wayoffthecoast/reference-PDB-files/Motherboard/PDFs/Motherboard-layout.pdf

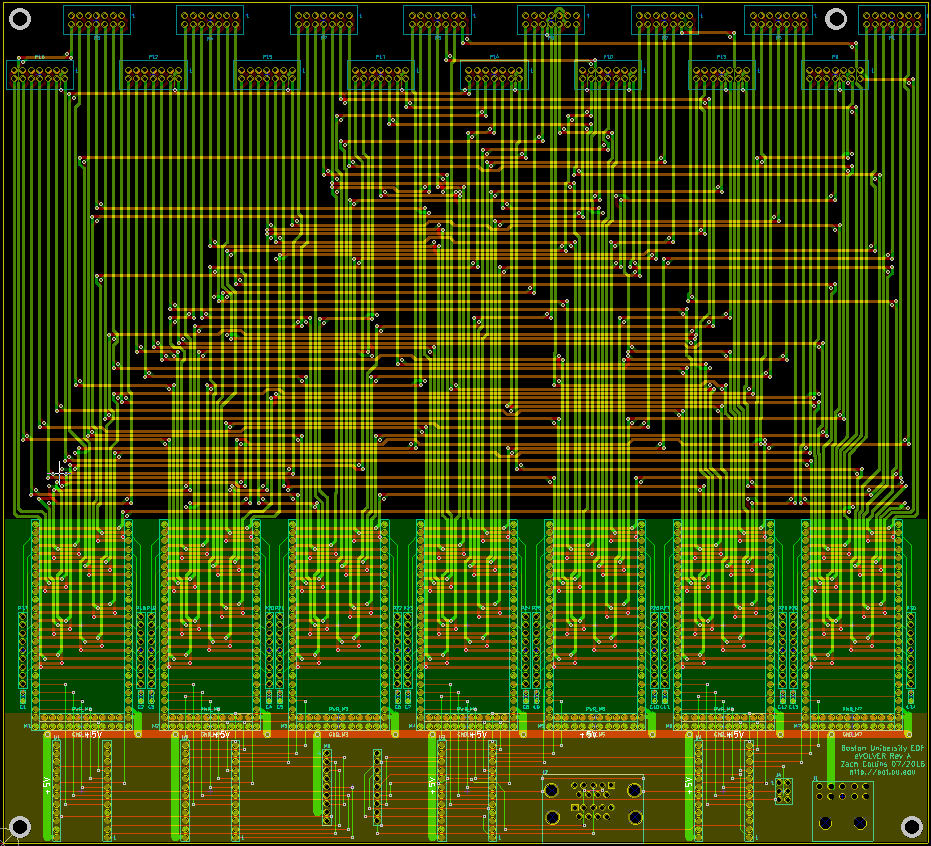
[picture p1: page 1]
