wayoffthecoast/reference-PDB-files/ADC/ADC_BOM_grouped_IC1_IS_WRONG?_.ods

 |  |  |  |  |  | Prototype Qty: | 5 |  |  |  | Production Qty: | 40 |  | Reeling Fee | $7.00
 |  |  |  |  |  | Prototype (Cut Tape) |  |  |  |  | Production (Digi-Reel)
Index | Reference | Quantity | Value | Footprint | Supplier Name | Qty Needed | Qty to Buy | Supplier Number | Comp Price | Comp Total | Qty Needed | Qty to Buy | Supplier Number | Comp Price | Reel Total
1 | C1 C10 C11 C12 C13 C14 C15 C16 C17 C18 C19 C2 C20 C21 C22 C23 C24 C3 C4 C5 C6 C7 C8 C9 | 24 | .1uF | Capacitors_SMD:C_0402 | Murata Electronics North America | 120 | 150 | 490-10777-1-ND | $0.01 | $0.83 | 960 | 1300 | 490-10777-6-ND | $0.00 | $10.90
2 | IC1 | 1 | 74HC4067 | ADC:74HC_HTC4067 | NXP Semiconductors | 5 | 8 | 568-12173-1-ND | $2.88 | $23.04 | 40 | 50 | 568-12173-6-ND | $2.59 | $136.35
3 | P1 P2 | 2 | CONNX25 | mods:25_pin_10in | Mill-Max Manufacturing Corp. | 10 | 12 | ED10025-ND | $3.66 | $43.87 | 80 | 85 | ED10025-ND | $4.52 | $384.20 | Not in Reel
4 | R1 R12 R13 R16 R17 R20 R21 R24 R25 R28 R29 R32 R33 R36 R37 R4 R40 R41 R44 R45 R48 R49 R5 R52 R53 R56 R57 R60 R61 R64 R65 R8 R9 | 33 | 10k | Resistors_SMD:R_0402 | Yageo | 165 | 200 | 311-10KJRCT-ND | $0.00 | $0.94 | 1320 | 1500 | 311-10KJRDKR-ND | $0.00 | $10.20
5 | R10 R14 R18 R2 R22 R26 R30 R34 R38 R42 R46 R50 R54 R58 R6 R62 | 16 | 1 M | Resistors_SMD:R_0402 | Yageo | 80 | 100 | 311-1.0MJRCT-ND | $0.00 | $0.47 | 640 | 800 | 311-1.0MJRDKR-ND | $0.00 | $9.32
6 | R11 R15 R19 R23 R27 R3 R31 R35 R39 R43 R47 R51 R55 R59 R63 R7 | 16 | OMIT | Resistors_SMD:R_0402 | Yageo | 80 | 0 | N/A | $0.00 | $0.00 | 640 | 0 | N/A | $0.00 | $0.00
7 | U1 | 1 | TLV1117LV33DCYR | ADC:TLV1117 | Texas Instruments | 5 | 8 | 296-28778-1-ND | $0.64 | $5.12 | 40 | 50 | 296-28778-6-ND | $0.56 | $35.20
8 | U2 | 1 | MCP6001 | ADC:MCP6001 | Microchip Technology | 5 | 8 | MCP6001T-I/OTCT-ND | $0.24 | $1.92 | 40 | 50 | MCP6001T-I/OTDKR-ND | $0.20 | $17.00
9 | U3 U4 U5 U6 | 4 | MCP6004 | ADC:MCP6004 | Microchip Technology | 20 | 25 | MCP6004T-I/STCT-ND | $0.36 | $9.00 | 160 | 200 | MCP6004T-I/STCT-ND | $0.33 | $73.00
 |  |  |  |  |  |  |  | Prototype Cost |  | $85.18 |  |  | Production Cost |  | $676.17
