wayoffthecoast/reference-PDB-files/Motherboard/Motherboard_BOM_grouped.ods

Prototype board quantity: | 2
Production board quantity: | 12 |  |  |  |  |  | Prototype |  |  |  |  | Production
Index | Reference | Quantity | Value | Footprint | Supplier Name | Notes | Catalog Number | quantity | order quantity | Price each | Price total | Catalog Number | quantity | order quantity | Price each | Price Total | Notes
1 | C1 C10 C11 C12 C13 C14 C2 C3 C4 C5 C6 C7 C8 C9 | 14 | 1uF | mods:FK18X5R0J105K | Digi-Key |  | 445-8395-ND | 28 | 30 | $0.20 | $6.00 | 445-8395-ND | 168 | 200 | $0.11 | $22.72
2 | P31 | 1 | CONN_01X10 | Mods:1723162216 | Digi-Key |  | WM11879-ND | 2 | 3 | $7.38 | $22.14 | WM11879-ND | 12 | 15 | $7.08 | $106.20
3 | J2 | 1 | DB9-M | mods:DB9FC | Digi-Key |  | 1109FME-ND | 2 | 3 | $6.96 | $20.88 | 1109FME-ND | 12 | 15 | $6.67 | $100.05
4 | J4 | 1 | CONN_02X03 | mods:2x3_pin_10in | Digi-Key |  | 609-3218-ND | 2 | 3 | $0.27 | $0.81 | 609-3218-ND | 12 | 15 | $0.26 | $3.87
5 | M1 M2 M3 M4 M5 M6 M7 | 7 | CONN_02X25 | mods:50_pin_10in | Digi-Key | Quantity 2x | 25-0513-10T | 28 | 30 | $2.90 | $87.00 | 25-0513-10T | 168 | 168 | $2.32 | $389.76
6 | M8 | 1 | CONN_02X09 | mods:2x_9_pin_10in | Digi-Key | Quantity 2x | 09-0513-10T | 4 | 5 | $1.87 | $9.35 | 09-0513-10 | 24 | 24 | $1.35 | $32.40 | IC socket?
7 | P1 P10 P11 P12 P13 P14 P15 P16 P2 P3 P4 P5 P6 P7 P8 P9 | 16 | CONN_02X07 | mods:2x7_pin_10in | Digi-Key |  | S9170-ND | 32 | 40 | $0.39 | $15.41 | S9170-ND | 192 | 200 | 0.315 | $63.00
8 | P17 P18 P19 P20 P21 P22 P23 P24 P25 P26 P27 P28 P29 P30 | 14 | 8_R_01X09 | mods:9_pin_10in | Digi-Key |  | 09-0513-10T | 28 | 30 | $2.69 | $80.61 | 09-0513-10 | 168 | 200 | $2.21 | $442.64
9 | GND_M1 GND_M2 GND_M3 GND_M4 GND_M5 GND_M6 GND_M7 PWR_M1 PWR_M2 PWR_M3 PWR_M4 PWR_M5 PWR_M6 PWR_M7 | 14 | CONN_01X10 | mods:10_pin_10in | Digi-Key |  | 10-0513-10 | 28 | 30 | $1.57 | $47.10 | 10-0513-10 | 168 | 200 | $1.26 | $252.00
10 | U1 U2 U3 U4 | 4 | CONN_02X12 | mods:24_pin_10in | Digi-Key |  | 214-44-624-01-670800 | 8 | 10 | $1.98 | $19.80 | 214-44-624-01-670800 | 48 | 50 | $1.98 | $99.00
 |  |  |  |  |  |  |  |  |  | Total cost: | $309.10 |  |  |  | Total cost | $1,511.64
 |  |  |  |  |  |  |  |  |  | Per board: | $154.55 |  |  |  | Per board: | $125.97
