wayoffthecoast/reference-PDB-files/Pi-Hat/EV-PiHat-asmBOM-RevA.ods

Reference | Value | Footprint | Datasheet | Supplier | Supplier PN
Q3 | 2N7002 | project_footprints:2N7002 |  | Digi-key | 2N7002NCT-ND
R1 | 510 | project_footprints:R_805_HS |  | Digi-key | RMCF0805JG510R-ND
D1 | LED | project_footprints:LED_0603 |  | Digi-key | 846-1178-2-ND
Q4 | 2N7002 | project_footprints:2N7002 |  | Digi-key | 2N7002NCT-ND
R2 | 510 | project_footprints:R_805_HS |  | Digi-key | RMCF0805JG510R-ND
D2 | LED | project_footprints:LED_0603 |  | Digi-key | 846-1178-2-ND
C2 | 1uF | project_footprints:C_0805_HS |  | Digi-key | CL21B105KOFNNNF-ND
C3 | 1uF | project_footprints:C_0805_HS |  | Digi-key | CL21B105KOFNNNF-ND
C1 | 1uF | project_footprints:C_0805_HS |  | Digi-key | CL21B105KOFNNNF-ND
R3 | DNP | project_footprints:R_805_HS
R5 | 10k | project_footprints:R_805_HS |  | Digi-key | RMCF0805JG10K0TR-ND
R10 | 10k | project_footprints:R_805_HS
J2 | Header_10Pin | project_footprints:10Pin_Header
J3 | Header_8Pin | project_footprints:8Pin_Header |  | Digi-key | 609-3273-ND
J4 | Header_8Pin | project_footprints:8Pin_Header |  | Digi-key | 609-3273-ND
J5 | Header_8Pin | project_footprints:8Pin_Header |  | Digi-key | 609-3273-ND
U1 | MAX481 | project_footprints:SO-8 |  | Digi-key | MAX481CSA+TR-ND
J6 | RJ14 | project_footprints:609-5080-ND |  | Digi-key | 609-5080-ND
Q5 | BSS123 | project_footprints:2N7002 |  | Digi-key | BSS123NTR-ND
R12 | 10k | project_footprints:R_805_HS |  | Digi-key | RMCF0805JG10K0TR-ND
R4 | 10k | project_footprints:R_805_HS |  | Digi-key | RMCF0805JG10K0TR-ND
J7 | 2Screw_Term | project_footprints:277-1667-ND |  | Digi-key | 277-1667-ND
R6 | DNP | project_footprints:R_805_HS |  | x | x
J1 | raspberrypi_hat:OX40HAT | project_footprints:Connector_PinSocket_2.54mm |  | Digi-key | S9200-ND
