wayoffthecoast/reference-PDB-files/PWM/pwm_BOM_grouped.ods

Prototype board quantity: | 6
Production board quantity: | 60 |  |  |  |  | Prototype |  |  |  |  | Production
Index | Reference | Qty | Value | Footprint | Supplier Name | Catalog Number | quantity | order quantity | Price each | Price total | Catalog Number | quantity | order quantity | Price each | Price Total | Reel charge | Total | Notes
1 | C1 C10 C2 C5 C6 C7 C8 C9 | 8 | 0.1uF | mods:C_0402 | Digi-Key | 490-6328-1-ND | 48 | 50 | $0.01 | $0.33 | 490-6328-6-ND | 480 | 500 | $0.00386 | $1.93 | $7.00 | $8.93
2 | C3 C4 | 2 | 1uF | mods:C_0402 | Digi-Key | 490-1320-1-ND | 12 | 20 | $0.02 | $0.42 | 490-1320-6-ND | 120 | 250 | 0.0096 | $2.40 | $7.00 | $9.40
3 | D1 D10 D11 D12 D13 D14 D15 D16 D2 D3 D4 D5 D6 D7 D8 D9 | 16 | ZHCS506TA | mods:ZHCS506TA | Digi-Key | ZHCS506CT-ND | 96 | 100 | $0.33 | $33.24 | ZHCS506DKR-ND | 960 | 1000 | $0.20 | $201.25 | $7.00 | $208.25
4 | P1 P2 | 2 | CONN_01X25_1 | mods:25_pin_10in | Digi-Key | 25-0600-20 | 12 | 20 | $3.19 | $63.80 | 25-0600-20 | 120 | 150 | $2.55 | $382.50 |  | $382.50 | ED10025-ND alternate ($$$)
5 | P3 P4 | 2 | CONN_01X10 | mods:10pin_tenth_in | Digi-Key | 10-0600-20 | 12 | 20 | $1.56 | $31.20 | 10-0600-20 | 120 | 150 | $1.26 | $189.00 |  | $189.00 | ED10010-ND alternate ($$$)
6 | Q1 Q10 Q11 Q12 Q13 Q14 Q15 Q16 Q2 Q3 Q4 Q5 Q6 Q7 Q8 Q9 | 16 | AO3422 | mods:AO3422 | Digi-Key | 785-1015-1-ND | 96 | 100 | $0.2538 | $25.38 | 785-1015-6-ND | 960 | 1000 | $0.11536 | $115.36 | $7.00 | $122.36
7 | R1 R10 R11 R12 R13 R14 R15 R16 R2 R3 R4 R5 R6 R7 R8 R9 R18 | 17 | 10K | mods:R_0402 | Digi-Key | 311-10KJRCT-ND | 102 | 120 | $0.00470 | $0.56 | 311-10KJRDKR-ND | 1020 | 1100 | $0.00213 | $2.34 | $7.00 | $9.34
8 | R17 | 1 | 2.2k | mods:R_0402 | Digi-Key | 311-2.20KLRCT-ND | 6 | 10 | $0.013 | $0.13 | 311-2.20KLRDKR-ND | 60 | 100 | $0.01 | $0.54 | $7.00 | $7.54
9 | U1 | 1 | TLV1117LV33DCYR | mods:TLV1117LV33DCYR | Digi-Key | 296-28778-1-ND | 6 | 10 | $0.649 | $6.49 | 296-28778-6-ND | 60 | 100 | $0.4966 | $49.66 | $7.00 | $56.66
10 | U2 | 1 | TLC5940PWP | mods:TLC5940PWP | Digi-Key | 296-35975-1-ND | 6 | 10 | $2.778 | $27.78 | 296-35975-6-ND | 60 | 100 | $2.2793 | $227.93 | $7.00 | $234.93
 |  |  |  |  |  |  |  |  | Total cost: | $189.33 |  |  |  | Total cost | $1,172.91 | $56.00 | $1,228.91
 |  |  |  |  |  |  |  |  | Per board: | $31.56 |  |  |  |  |  | Per board: | $20.48
