wayoffthecoast/reference-PDB-files/RS485/RS485_BOM_grouped.ods

 |  |  |  |  |  | Prototype Qty: | 2 |  |  |  | Production Qty: | 10 |  | Reeling Fee | $7.00
 |  |  |  |  |  | Prototype (Cut Tape) |  |  |  |  | Production (Digi-Reel)
Index | Reference | Quantity | Value | Footprint | Supplier Name | Qty Needed | Qty to Buy | Supplier Number | Comp Price | Comp Total | Qty Needed | Qty to Buy | Supplier Number | Comp Price | Reel Total
1 | C1 C2 C3 | 3 | .1uF | mods:C_0402 | Murata Electronics North America | 6 | 10 | 490-10777-1-ND | 0.012 | $0.12 | 30 | 40 | 490-10777-6-ND | 0.012 | $7.48
2 | C4 | 1 | 10nF | mods:C_0402 | Murata Electronics North America | 2 | 10 | 490-6340-1-ND | 0.012 | $0.12 | 10 | 20 | 490-6340-6-ND | 0.012 | $7.24
3 | C5 | 1 | 1nF | mods:C_0402 | Murata Electronics North America | 2 | 10 | 490-6169-1-ND | 0.029 | $0.29 | 10 | 20 | 490-6169-6-ND | 0.029 | $7.58
4 | C6 | 1 | 100pF | mods:C_0402 | Murata Electronics North America | 2 | 10 | 490-5922-1-ND | 0.012 | $0.12 | 10 | 20 | 490-5922-6-ND | 0.012 | $7.24
5 | C7 | 1 | 10pF | mods:C_0402 | Murata Electronics North America | 2 | 10 | 490-6168-1-ND | 0.012 | $0.12 | 10 | 20 | 490-6168-6-ND | 0.012 | $7.24
6 | P1 P2 | 2 | CONN_01X09 | mods:9_pin_10in | Mill-Max Manufacturing Corp. | 4 | 6 | ED10009-ND | 2.85 | $17.10 | 20 | 30 | ED10009-ND | 2.85 | $85.50
7 | R1 R2 R3 R4 | 4 | 10k | mods:R_0402 | Yageo | 8 | 10 | 311-10KJRCT-ND | 0.012 | $0.12 | 40 | 50 | 311-10KJRDKR-ND | 0.012 | $7.60 | Not in Reel
8 | U1 U2 U4 U5 | 4 | SP3485CN | mods:SO-8 | Exar Corporation | 8 | 10 | 1016-1144-5-ND | 2.027 | $20.27 | 40 | 50 | 1016-1144-5-ND | 2.027 | $101.35 | Not in Reel (Tube)
9 | U3 | 1 | TLV1117LV33DCYR | mods:TLV1117LV33DCYR | Texas Instruments | 2 | 5 | 296-28778-1-ND | 0.64 | $3.20 | 10 | 20 | 296-28778-6-ND | 0.64 | $19.80
 |  |  |  |  |  |  |  | Prototype Cost |  | $41.46 |  |  | Production Cost |  | $251.03
 |  |  |  |  |  |  |  |  | Per board: | $20.73 |  |  |  | Per board: | $25.10
