wayoffthecoast/reference-PDB-files/ADC/JLCPCB/ADC_BOM_single_SUBMITTED.xls

Comment | Designator | Footprint | LCSC Part Number | Datasheet | Supplier Num | Supplier Name | PREVIOUSLY USED WRONG PART
TLV1117LV33DCYR | U1 | ADC:TLV1117 | C15578 |  | 296-28778-1-ND | Texas Instruments
.1uF | C4 | Capacitors_SMD:C_0402 | C159815
.1uF | C2 | Capacitors_SMD:C_0402 | C159815
CONNX25 | P1 | mods:25_pin_10in |  |  | ED10025-ND | Mill-Max Manufacturing Corp.
CONNX25 | P2 | mods:25_pin_10in |  |  | ED10025-ND | Mill-Max Manufacturing Corp.
74HC4067DB,118 | IC1 | ADC:74HC_HTC4067 | C124924 |  | 568-7641-1-ND | NXP Semiconductors | 74HC4067PW,118 = 568-12173-2-ND
.1uF | C1 | Capacitors_SMD:C_0402 | C159815
.1uF | C3 | Capacitors_SMD:C_0402 | C159815
MCP6001 | U2 | ADC:MCP6001 | C116490 |  | MCP6001T-I/OTCT-ND | Microchip Technology
10k | R1 | Resistors_SMD:R_0402 | C140214
MCP6004 | U3 | ADC:MCP6004 | C50282 |  | MCP6004T-I/STCT-ND | Microchip Technology
1M = 1 MegaOhm | R2 | Resistors_SMD:R_0402 | C26087
10k | R4 | Resistors_SMD:R_0402 | C140214
DO NOT PLACE = OMIT | R3 | Resistors_SMD:R_0402
10k | R5 | Resistors_SMD:R_0402 | C140214
.1uF | C5 | Capacitors_SMD:C_0402 | C159815
1M = 1 MegaOhm | R10 | Resistors_SMD:R_0402 | C26087
DO NOT PLACE = OMIT | R11 | Resistors_SMD:R_0402
10k | R12 | Resistors_SMD:R_0402 | C140214
10k | R13 | Resistors_SMD:R_0402 | C140214
1M = 1 MegaOhm | R14 | Resistors_SMD:R_0402 | C26087
DO NOT PLACE = OMIT | R15 | Resistors_SMD:R_0402
10k | R16 | Resistors_SMD:R_0402 | C140214
10k | R17 | Resistors_SMD:R_0402 | C140214
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
10k | R56 | Resistors_SMD:R_0402 | C140214
10k | R57 | Resistors_SMD:R_0402 | C140214
.1uF | C21 | Capacitors_SMD:C_0402 | C159815
.1uF | C23 | Capacitors_SMD:C_0402 | C159815
.1uF | C22 | Capacitors_SMD:C_0402 | C159815
.1uF | C24 | Capacitors_SMD:C_0402 | C159815
