wayoffthecoast/reference-PDB-files/RS485/JLCPCB/RS485_BOM_grouped_Submitted.xls

Comment | Designator | Footprint | LCSC Part Number | Supplier Name | Qty Needed | Qty to Buy | Supplier Number | Comp Price | Comp Total | Qty Needed | Qty to Buy | Supplier Number | Comp Price | Reel Total
.1uF = 100 nF | C1 C2 C3 | mods:C_0402 | C309458 | Murata Electronics North America | #REF! | 10 | 490-10777-1-ND | 0.012 | $0.12 | #REF! | 40 | 490-10777-6-ND | 0.012 | #REF!
10nF | C4 | mods:C_0402 | C541443 | Murata Electronics North America | #REF! | 10 | 490-6340-1-ND | 0.012 | $0.12 | #REF! | 20 | 490-6340-6-ND | 0.012 | #REF!
1nF | C5 | mods:C_0402 | C77018 | Murata Electronics North America | #REF! | 10 | 490-6169-1-ND | 0.029 | $0.29 | #REF! | 20 | 490-6169-6-ND | 0.029 | #REF!
100pF | C6 | mods:C_0402 | C1546 | Murata Electronics North America | #REF! | 10 | 490-5922-1-ND | 0.012 | $0.12 | #REF! | 20 | 490-5922-6-ND | 0.012 | #REF!
10pF | C7 | mods:C_0402 | C32949 | Murata Electronics North America | #REF! | 10 | 490-6168-1-ND | 0.012 | $0.12 | #REF! | 20 | 490-6168-6-ND | 0.012 | #REF!
CONN_01X09 | P1 P2 | mods:9_pin_10in |  | Mill-Max Manufacturing Corp. | #REF! | 6 | ED10009-ND | 2.85 | $17.10 | #REF! | 30 | ED10009-ND | 2.85 | $85.50
10k | R1 R2 R3 R4 | mods:R_0402 | C269674 | Yageo | #REF! | 10 | 311-10KJRCT-ND | 0.012 | $0.12 | #REF! | 50 | 311-10KJRDKR-ND | 0.012 | #REF! | Not in Reel
SP3485CN | U1 U2 U4 U5 | mods:SO-8 | C916153 | Exar Corporation | #REF! | 10 | 1016-1144-5-ND | 2.027 | $20.27 | #REF! | 50 | 1016-1144-5-ND | 2.027 | $101.35 | Not in Reel (Tube)
TLV1117LV33DCYR | U3 | mods:TLV1117LV33DCYR | C15578 | Texas Instruments | #REF! | 5 | 296-28778-1-ND | 0.64 | $3.20 | #REF! | 20 | 296-28778-6-ND | 0.64 | #REF!
 |  |  |  |  |  |  | Prototype Cost |  | $41.46 |  |  | Production Cost |  | #REF!
 |  |  |  |  |  |  |  | Per board: | #REF! |  |  |  | Per board: | #REF!
