wayoffthecoast/reference-PDB-files/hardware-master/Smart Sleeve/vial_board/Rev D/Vial_Board_grp.ods

Reference | Quantity | Value | Footprint | Datasheet | Catalog Number | Supplier Name
P1 | 1 | CONN_02X08 | mods:2x8_pin_10in |  | S9171-ND | Digi-key
P2 | 1 | CONN_01X04 | mods:4_ScrewTerm |  | ED10563-ND | Digi-Key
P5 | 1 | DNP (Thermistor) | mods:Thermistor |  | x | x
P6 | 1 | IR LED | mods:screw_terminal |  | ED10561-ND | Digi-Key
P7 | 1 | IR Detector | mods:screw_terminal |  | ED10561-ND | Digi-Key
P8 | 1 | Spare B | mods:screw_terminal |  | ED10561-ND | Digi-key
P9 | 1 | Spare A | mods:screw_terminal |  | ED10561-ND | Digi-key
R1 R3 R4 R7 | 4 | 82 | mods:Through_hole_R |  | 82ZCT-ND | Digi-Key
R5 | 1 | Heater 1 | mods:Heater |  | 684-MP915-20 | Mouser Electronics
R6 | 1 | Heater 2 | mods:Heater |  | 684-MP915-20 | Mouser Electronics
