wayoffthecoast/reference-PDB-files/hardware-master/pump_board/Rev C/Mounts/3D printed/Solidworks/pumpmount_frontLeft_RevC.SLDPRT

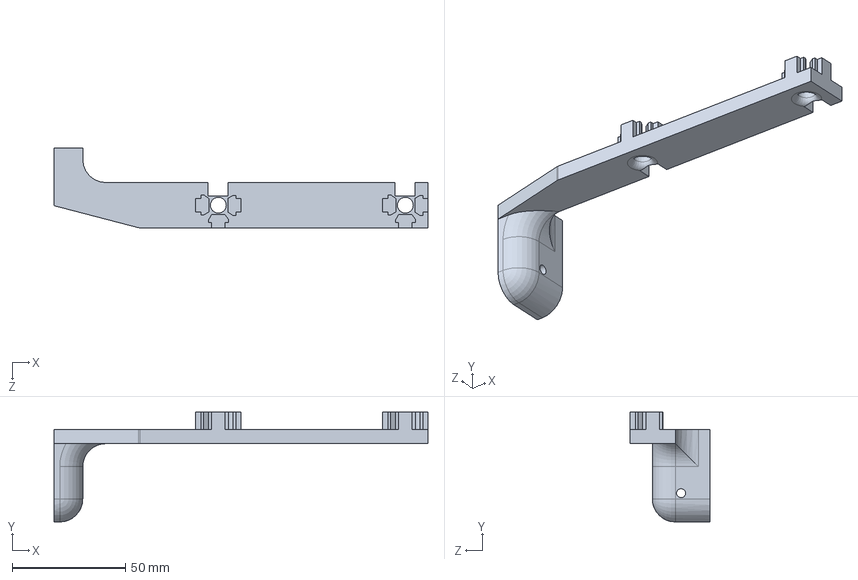
[picture p3: CAD file, 2021-12-21]
hardware-master/pump_board/Rev C/Mounts/3D printed/Solidworks/pumpmount_frontLeft_RevC.SLDPRT
165.1 x 48.5 x 35.2 mm
