wayoffthecoast/reference-PDB-files/hardware-master/Smart Sleeve/aluminum_tube/KL_aluminum_sleeve_V2.STEP

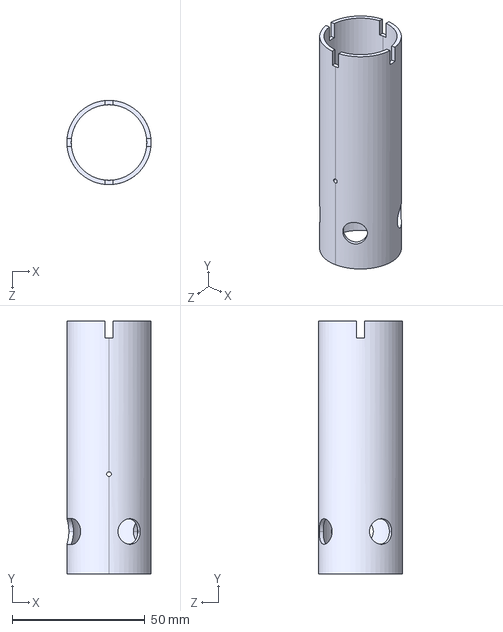
[picture p4: CAD file, 2021-12-21]
hardware-master/Smart Sleeve/aluminum_tube/KL_aluminum_sleeve_V2.STEP
31.8 x 95.3 x 31.8 mm
