wayoffthecoast/reference-PDB-files/hardware-master/Smart Sleeve/tube-holder/Tube Holder_V4.SLDPRT

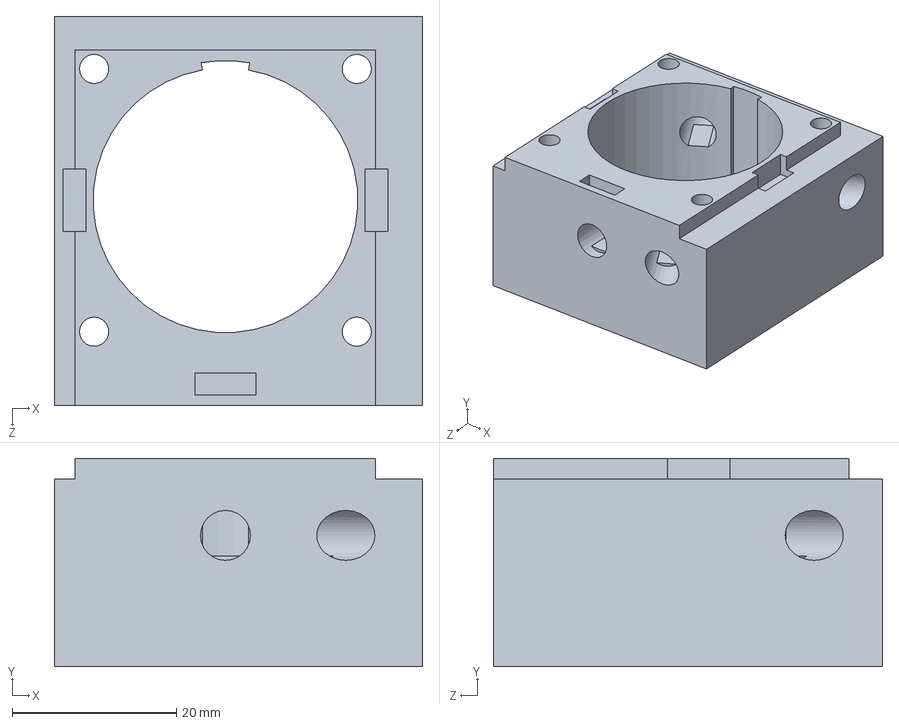
[picture p5: CAD file, 2021-12-21]
hardware-master/Smart Sleeve/tube-holder/Tube Holder_V4.SLDPRT
44.8 x 25.4 x 47.4 mm
