wayoffthecoast/reference-PDB-files/hardware-master/Smart Sleeve/vial-aligner/vial_aligner.SLDPRT

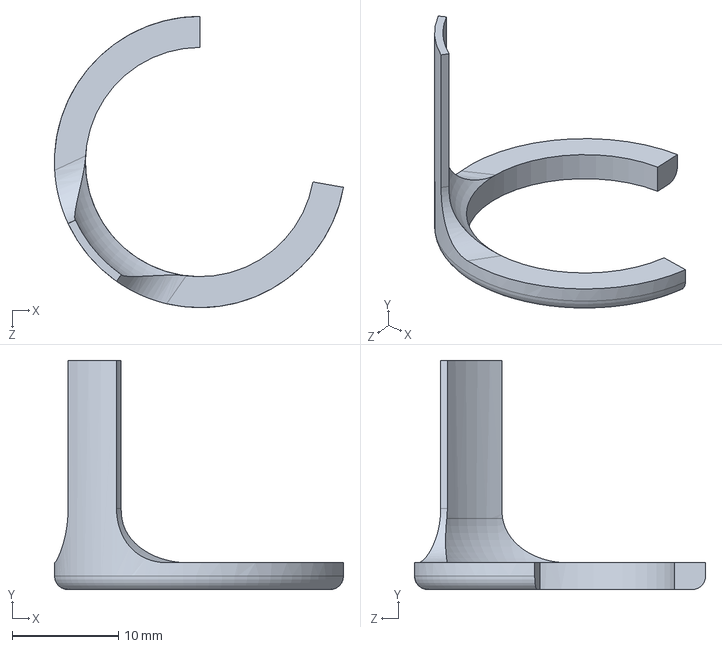
[picture p6: CAD file, 2021-12-21]
hardware-master/Smart Sleeve/vial-aligner/vial_aligner.SLDPRT
27.2 x 21.6 x 27.4 mm
