wayoffthecoast/reference-PDB-files/hardware-master/Smart Sleeve/vial_cap/vial_cap_v5.SLDPRT

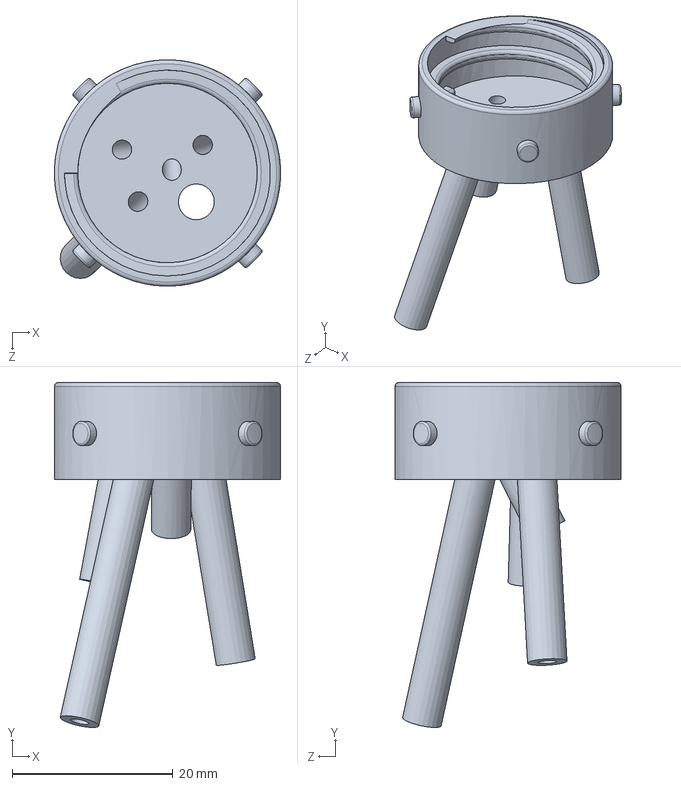
[picture p7: CAD file, 2021-12-21]
hardware-master/Smart Sleeve/vial_cap/vial_cap_v5.SLDPRT
28.2 x 43.0 x 28.2 mm
