wayoffthecoast/reference-PDB-files/pump_board/Rev C/Mounts/3D printed/Solidworks/pumpmount_backLeft_RevC.SLDPRT

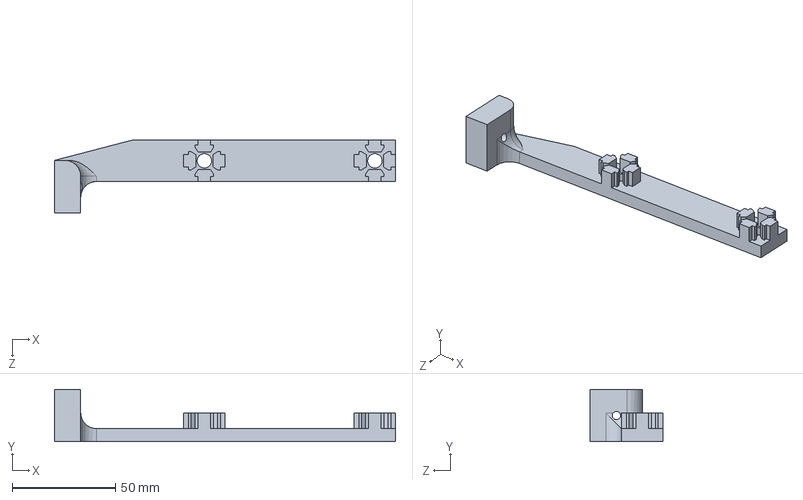
[picture p8: CAD file, 2021-12-21]
pump_board/Rev C/Mounts/3D printed/Solidworks/pumpmount_backLeft_RevC.SLDPRT
165.1 x 25.4 x 35.2 mm
