wayoffthecoast/reference-PDB-files/(list of files, cad)

Other CAD files:
hardware-master/pump_board/Rev C/Mounts/3D printed/STL/pumpmount_frontRight_RevC.STL
pump_board/Rev C/Mounts/3D printed/Solidworks/pumpmount_frontRigh_RevC.SLDPRT
pump_board/Rev C/Mounts/3D printed/STL/pumpmount_frontRight_RevC.STL
hardware-master/pump_board/Rev C/Mounts/3D printed/Solidworks/pumpmount_frontRigh_RevC.SLDPRT
hardware-master/pump_board/Rev C/Mounts/3D printed/Solidworks/pumpmount_backRight_RevC.SLDPRT
pump_board/Rev C/Mounts/3D printed/Solidworks/pumpmount_backRight_RevC.SLDPRT
hardware-master/Smart Sleeve/tube-holder/Tube Holder_V4.STL
hardware-master/Smart Sleeve/vial-aligner/vial_aligner.STL
hardware-master/Smart Sleeve/vial_cap/vial_cap_v5.STL
hardware-master/pump_board/Rev C/Mounts/3D printed/STL/pumpmount_backLeft_RevC.STL
hardware-master/pump_board/Rev C/Mounts/3D printed/STL/pumpmount_backRight_RevC.STL
hardware-master/pump_board/Rev C/Mounts/3D printed/STL/pumpmount_frontLeft_RevC.STL
pump_board/Rev C/Mounts/3D printed/STL/pumpmount_backLeft_RevC.STL
pump_board/Rev C/Mounts/3D printed/STL/pumpmount_backRight_RevC.STL
pump_board/Rev C/Mounts/3D printed/STL/pumpmount_frontLeft_RevC.STL
