wayoffthecoast/reference-PDB-files/Motherboard/PDFs/Motherboard-gerber.pdf

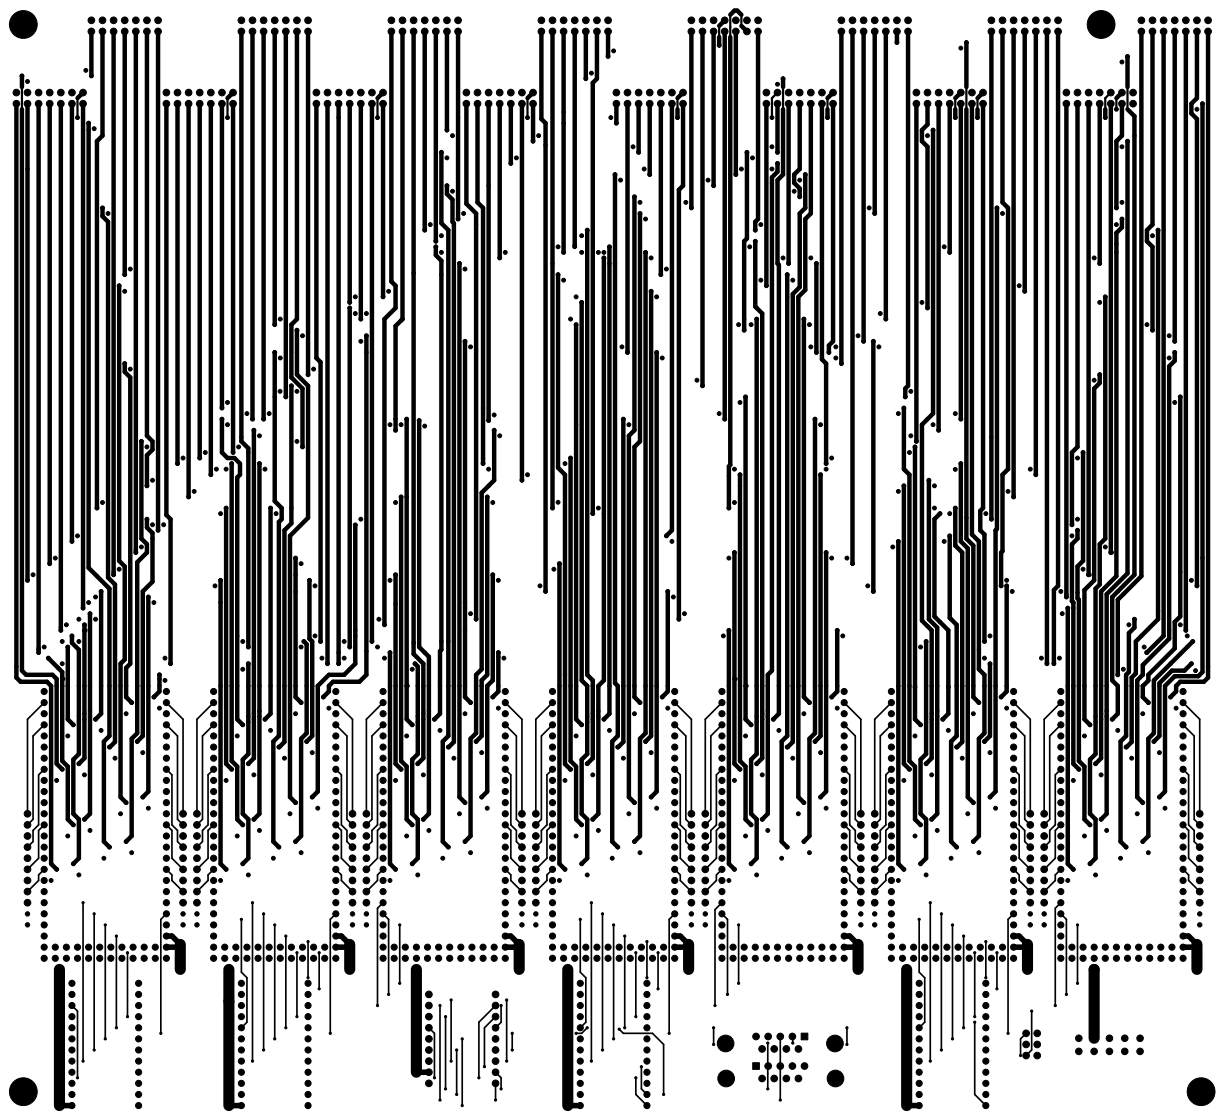
[picture p10: page 1]

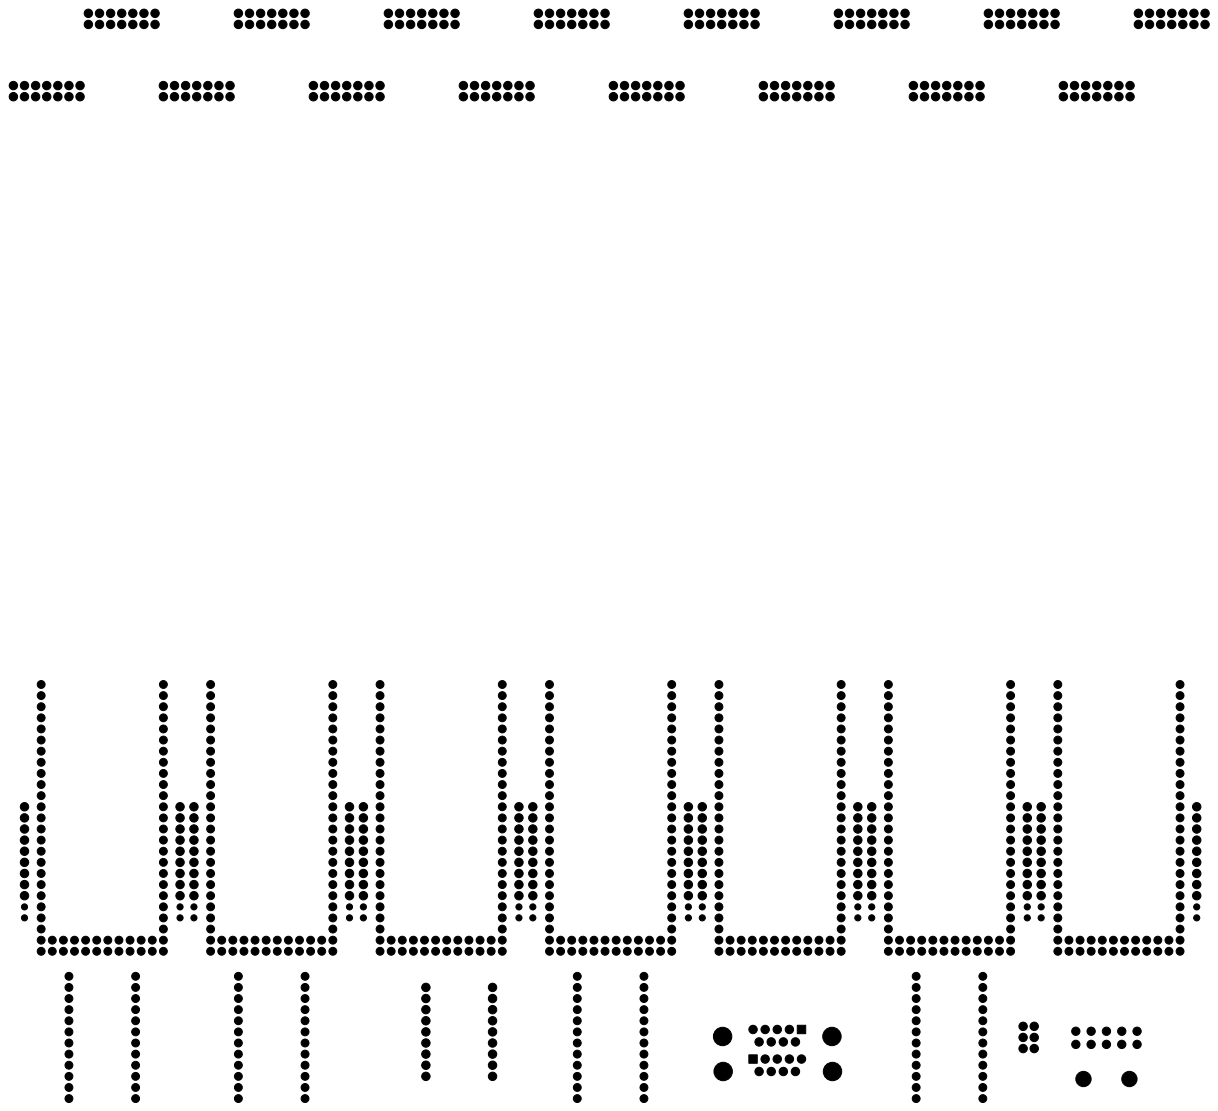
[picture p11: page 2]

# BOSTON UNIVERSITY EDF

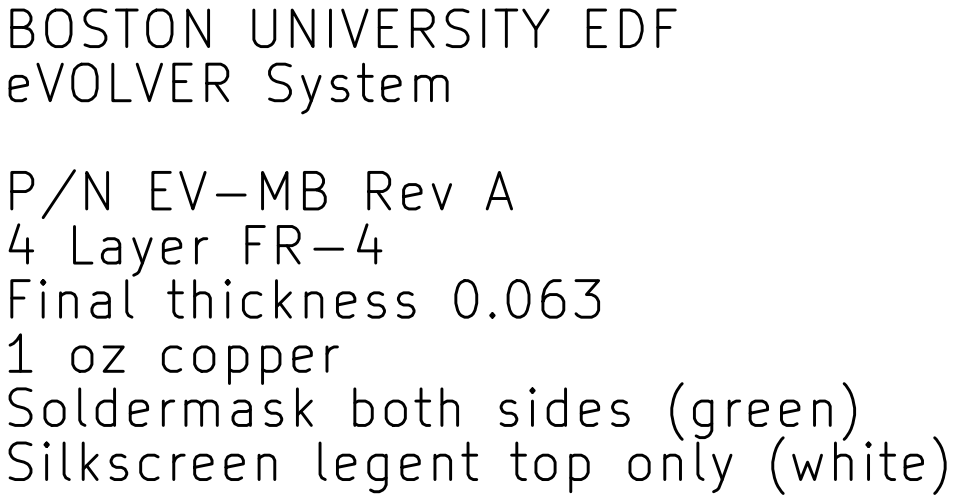
[picture p12: page 5]

eVOLVER System
P/N EV-MB Rev A
4 Layer FR-4
Final thickness 0.063
1 oz copper
Soldermask both sides (green)
Silkscreen legent top only (white)

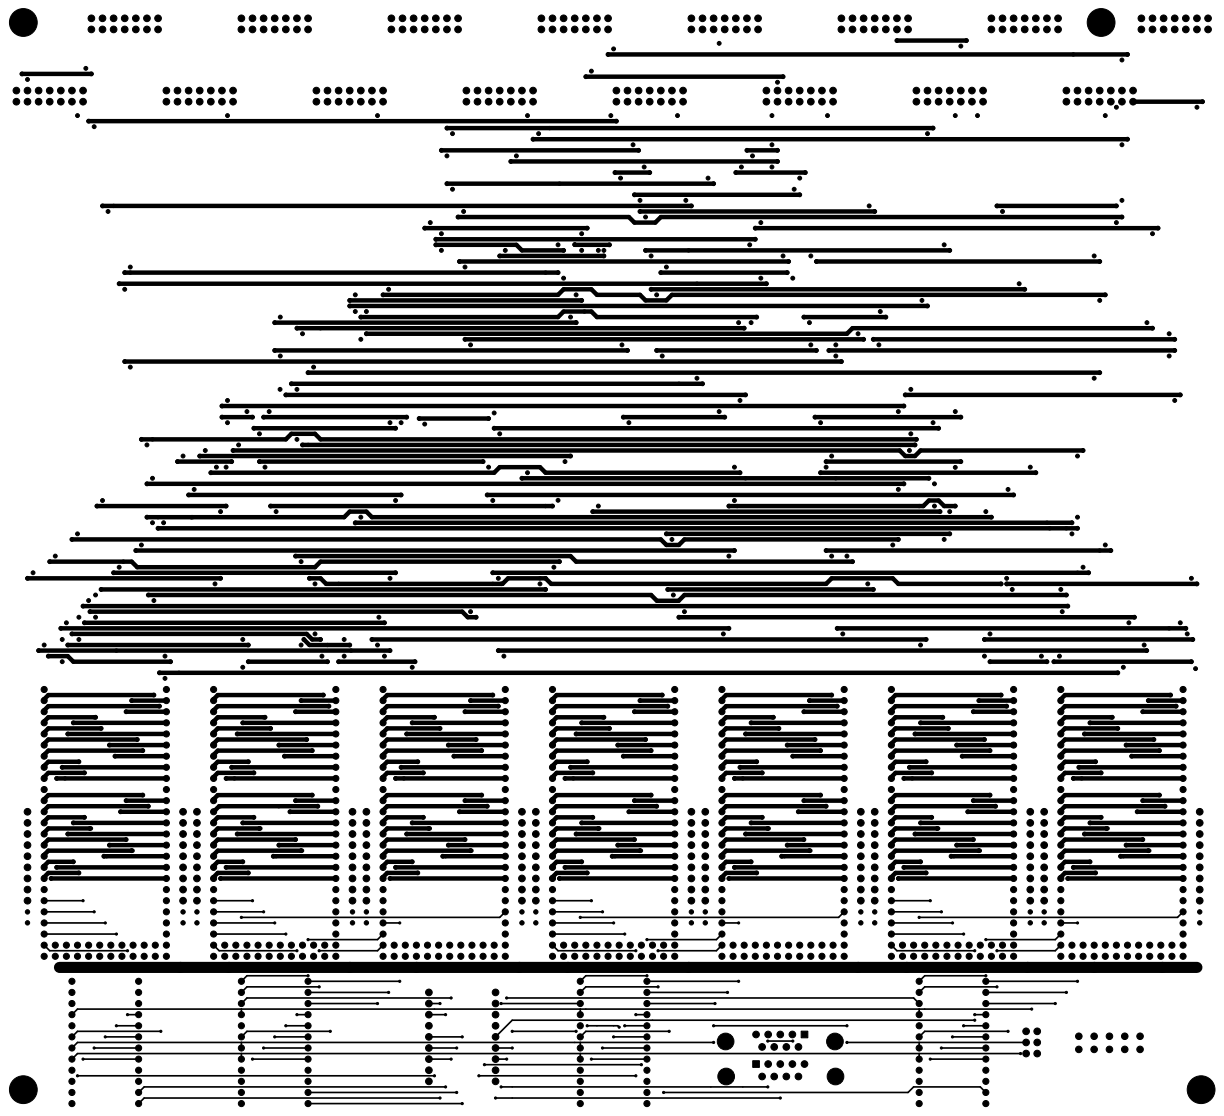
[picture p13: page 6]

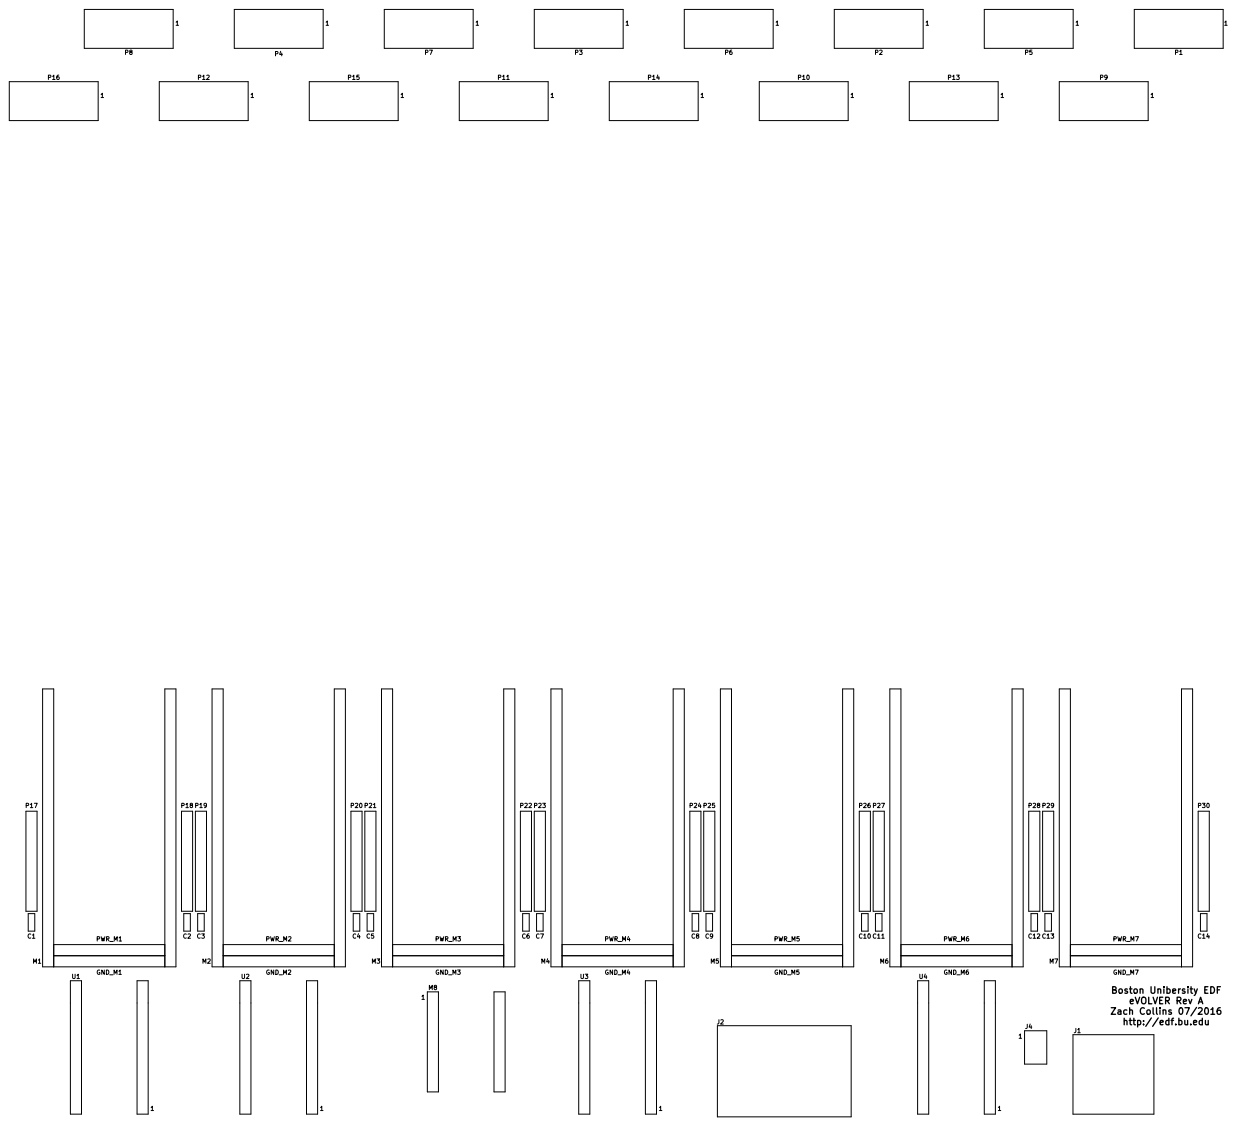
[picture p14: page 9]

Boston Unibersity EDF
eVOLVER Rev A
Zach Collins 07/2016 http://edf.bu.edu

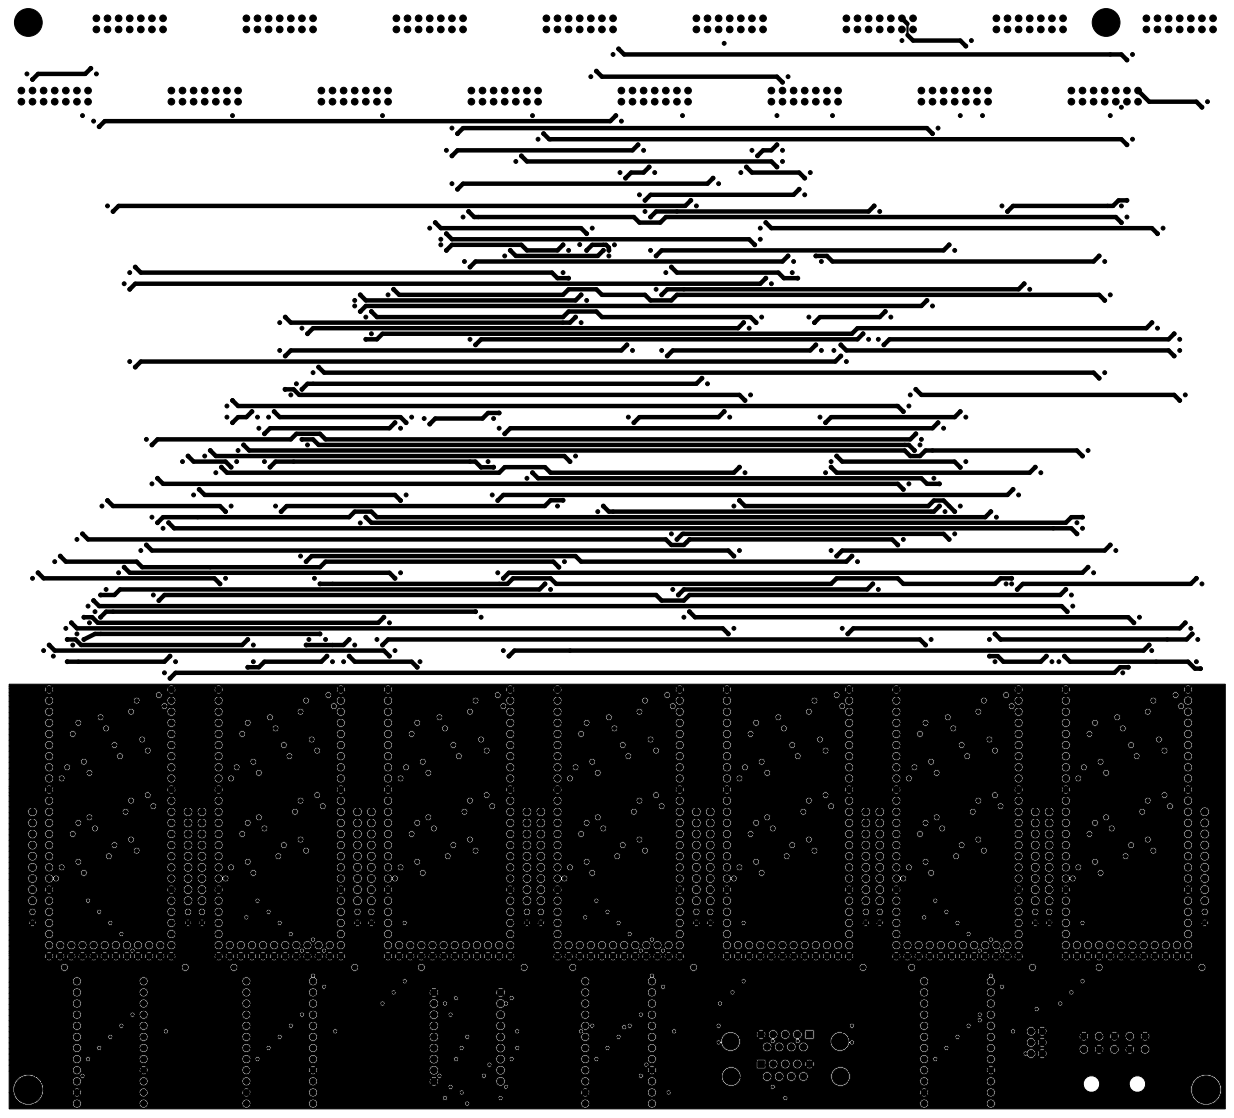
[picture p15: page 10]

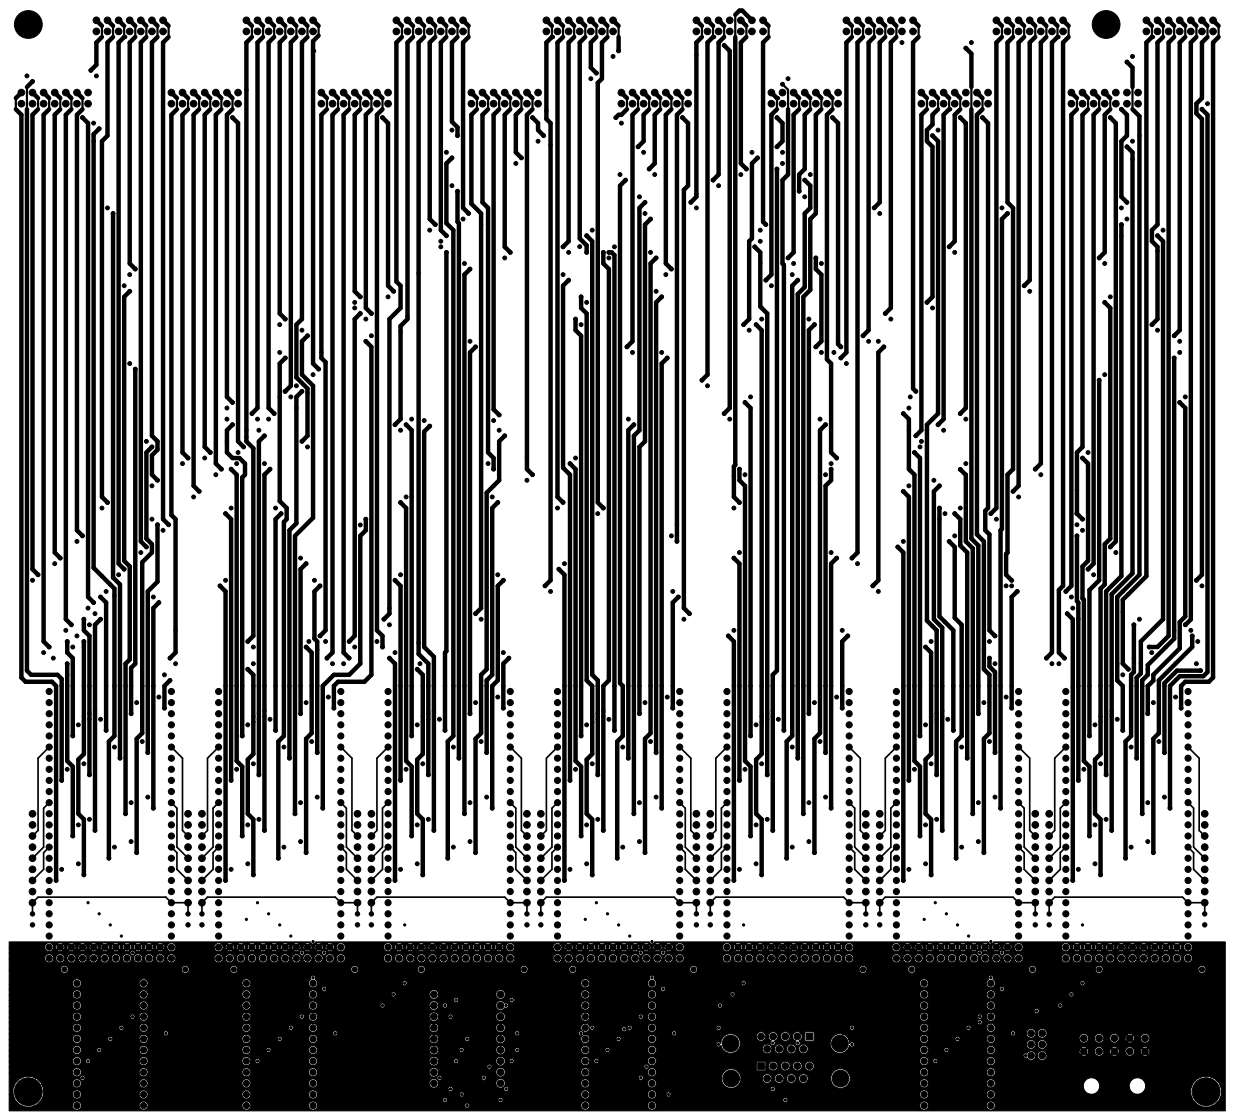
[picture p16: page 11]
