wayoffthecoast/reference-PDB-files/Motherboard/PDFs/Motherboard.pdf

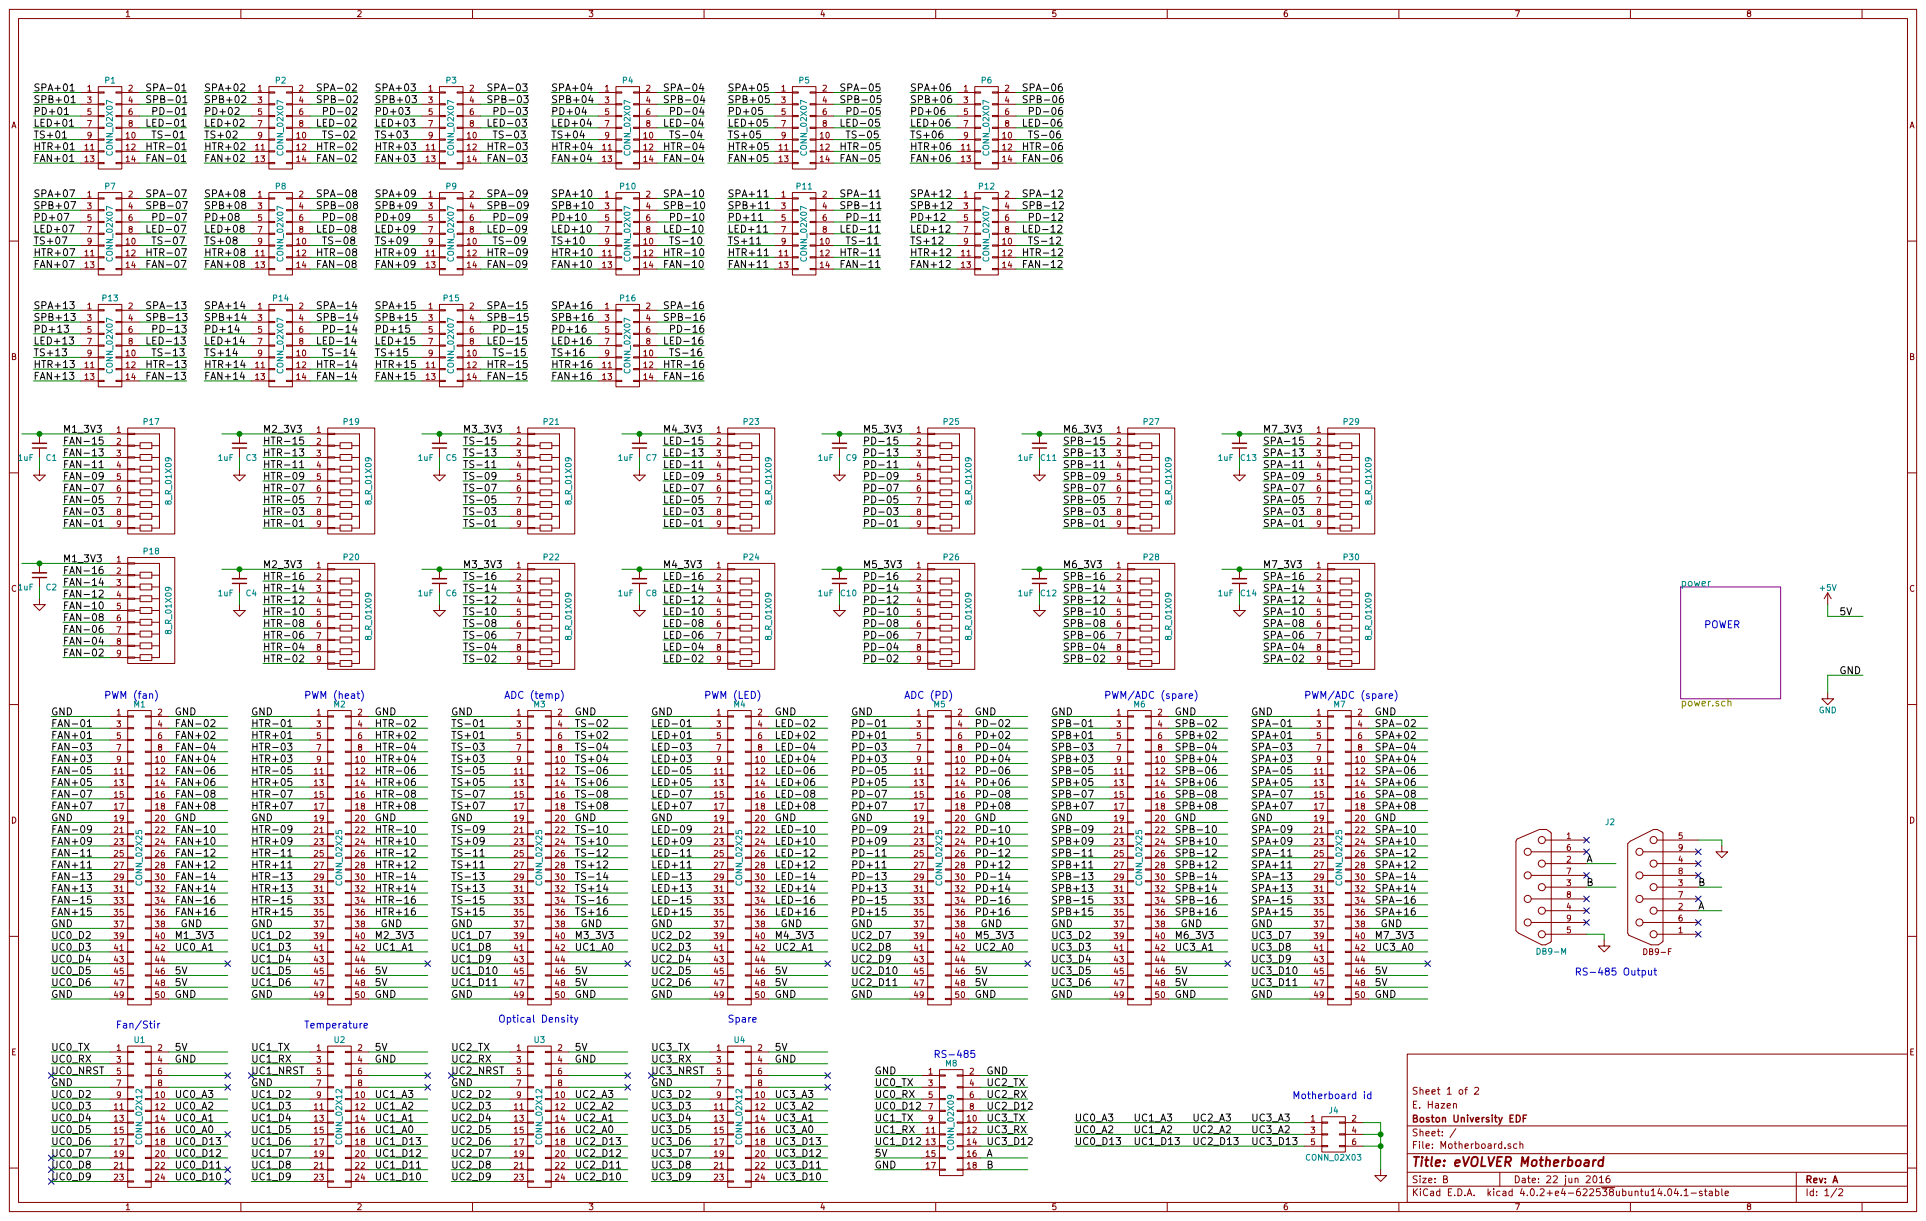
[picture p17: page 1]

LED-05 TS-05 HTR-05 FAN-05 SPA-11

LED-06 TS-06 HTR-06 FAN-06 SPA-12

LED+05 TS+05 HTR+05 FAN+05

LED+06 TS+06 HTR+06 FAN+06

LED-12 TS-12 HTR-12 FAN-12 M1_3V3

LED+11 TS+11 HTR+11 FAN+11

LED-11 TS-11 HTR-11 FAN-11

LED+12 TS+12 HTR+12 FAN+12

File: Motherboard.sch Sheet: / Boston University EDF E. Hazen Sheet 1 of 2

Id: 1/2 Title: eVOLVER Motherboard
