wayoffthecoast/reference-PDB-files/PWM/PDFs/eVolver_pwm_gerbers.pdf

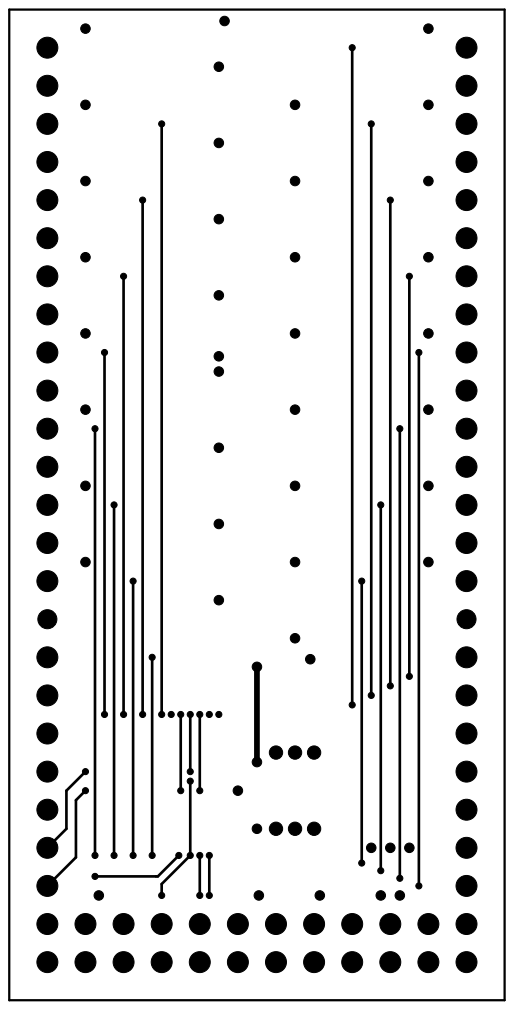
[picture p18: page 1]
D Date: KiCad E.D.A. kicad 4.0.2+e4-622538ubuntu14.04.1-stable Size: A4; Rev:; Id: 1/1 Title:; File: eVolver_pwm.kicad_pcb Sheet:

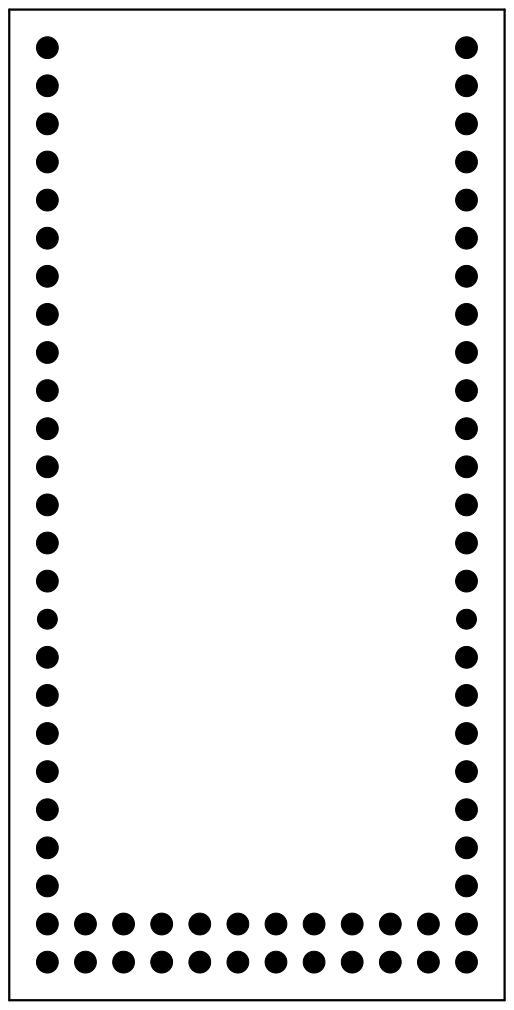
[picture p19: page 2]
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

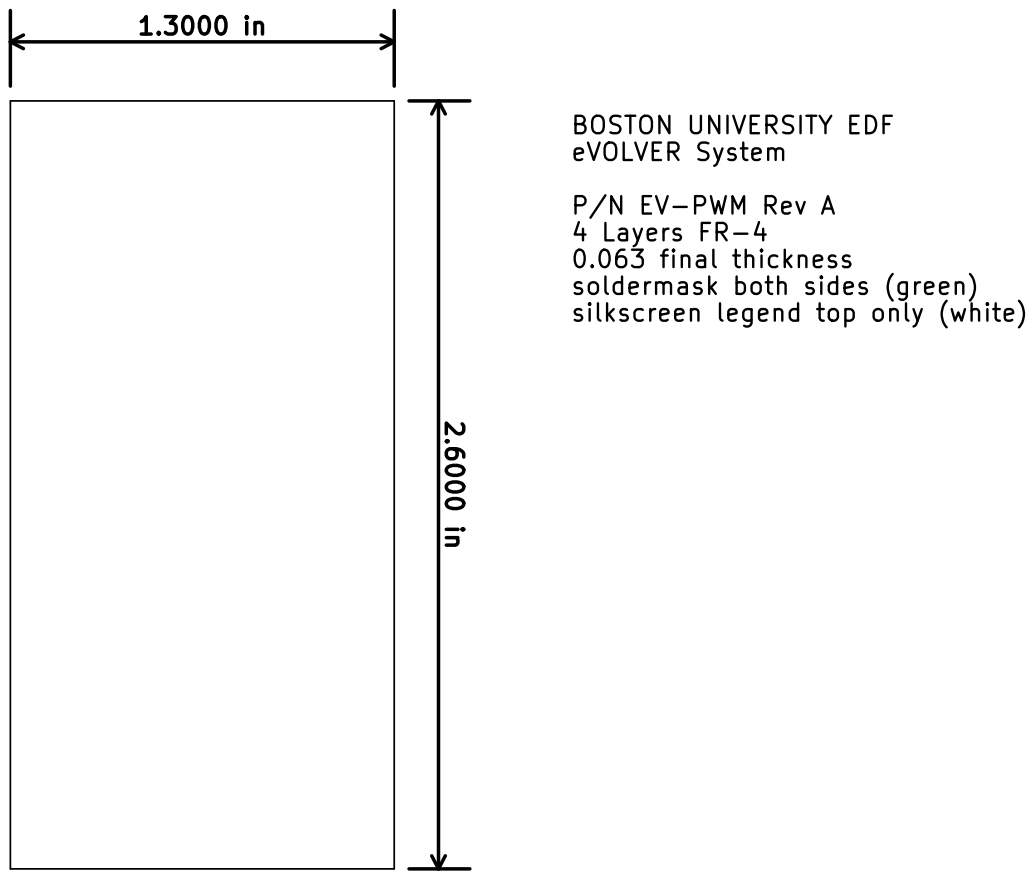
[picture p20: page 3]
D Date: KiCad E.D.A. kicad 4.0.2+e4-622538ubuntu14.04.1-stable Size: A4; Rev:; Id: 1/1 Title:; File: eVolver_pwm.kicad_pcb Sheet:; BOSTON UNIVERSITY EDF

eVOLVER System
P/N EV-PWM Rev A
4 Layers FR-4
0.063 final thickness
soldermask both sides (green)
silkscreen legend top only (white)

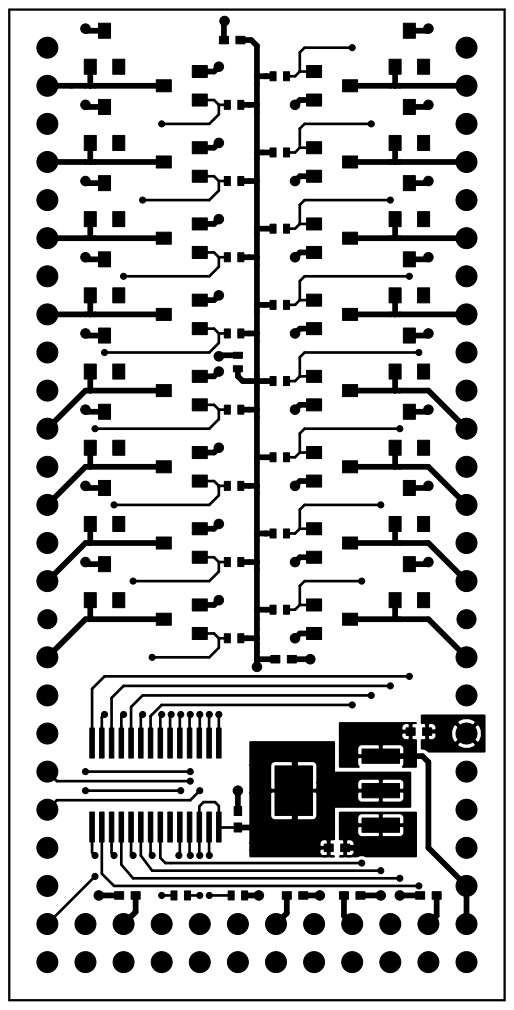
[picture p21: page 4]
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

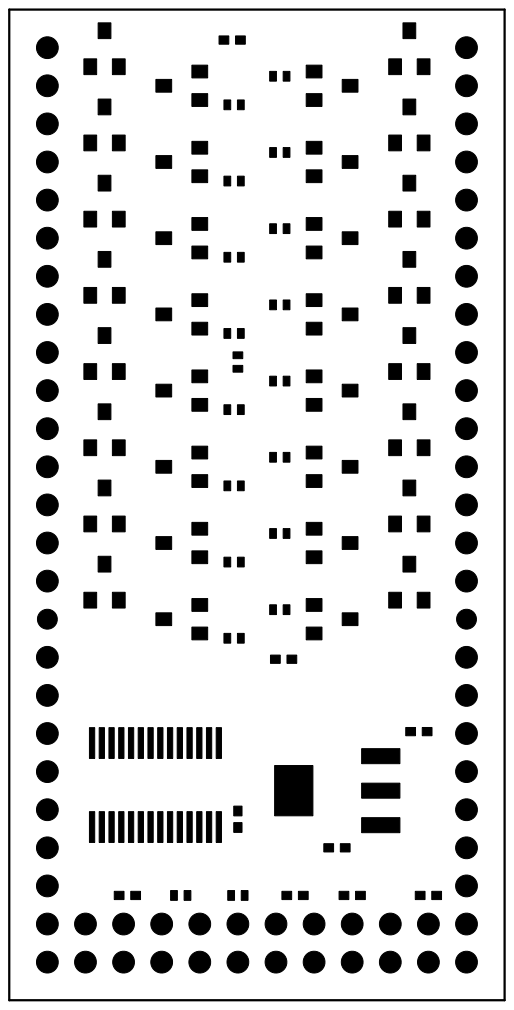
[picture p22: page 5]
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

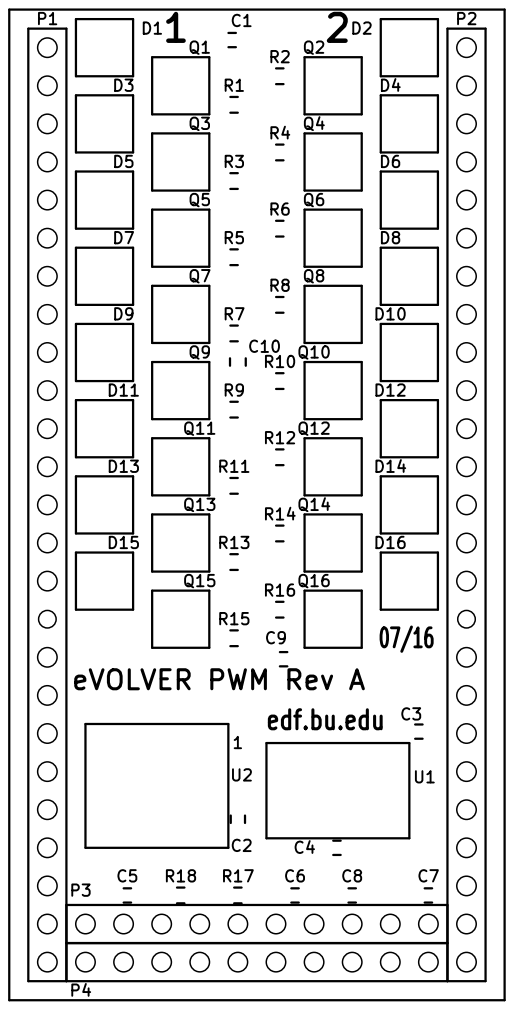
[picture p23: page 6]

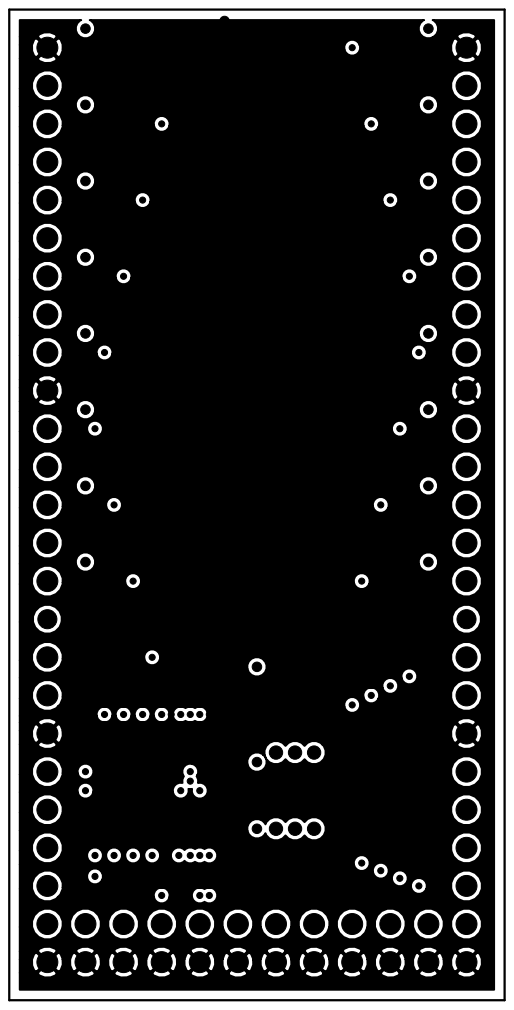
[picture p24: page 7]
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

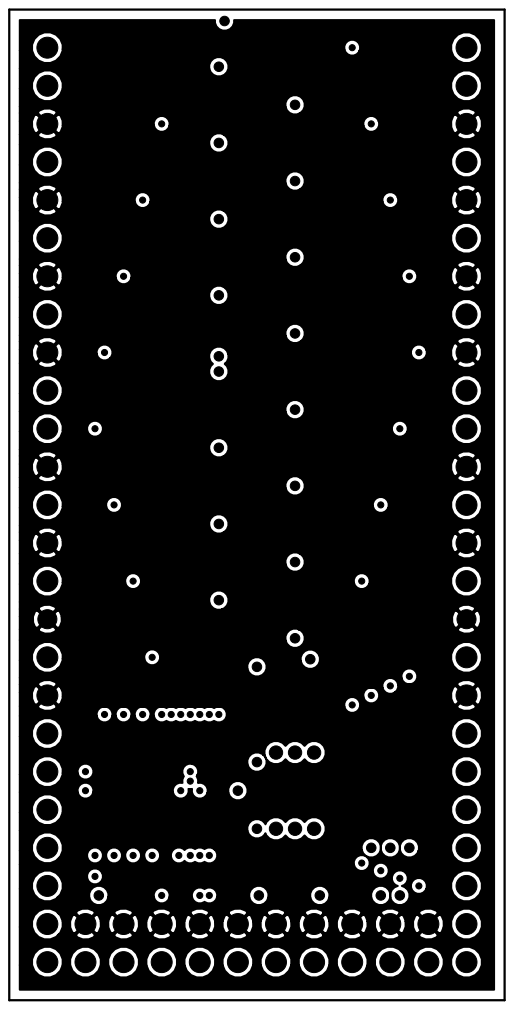
[picture p25: page 8]
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
