wayoffthecoast/reference-PDB-files/Motor_Board | TSSOP/schematic-test-print.pdf

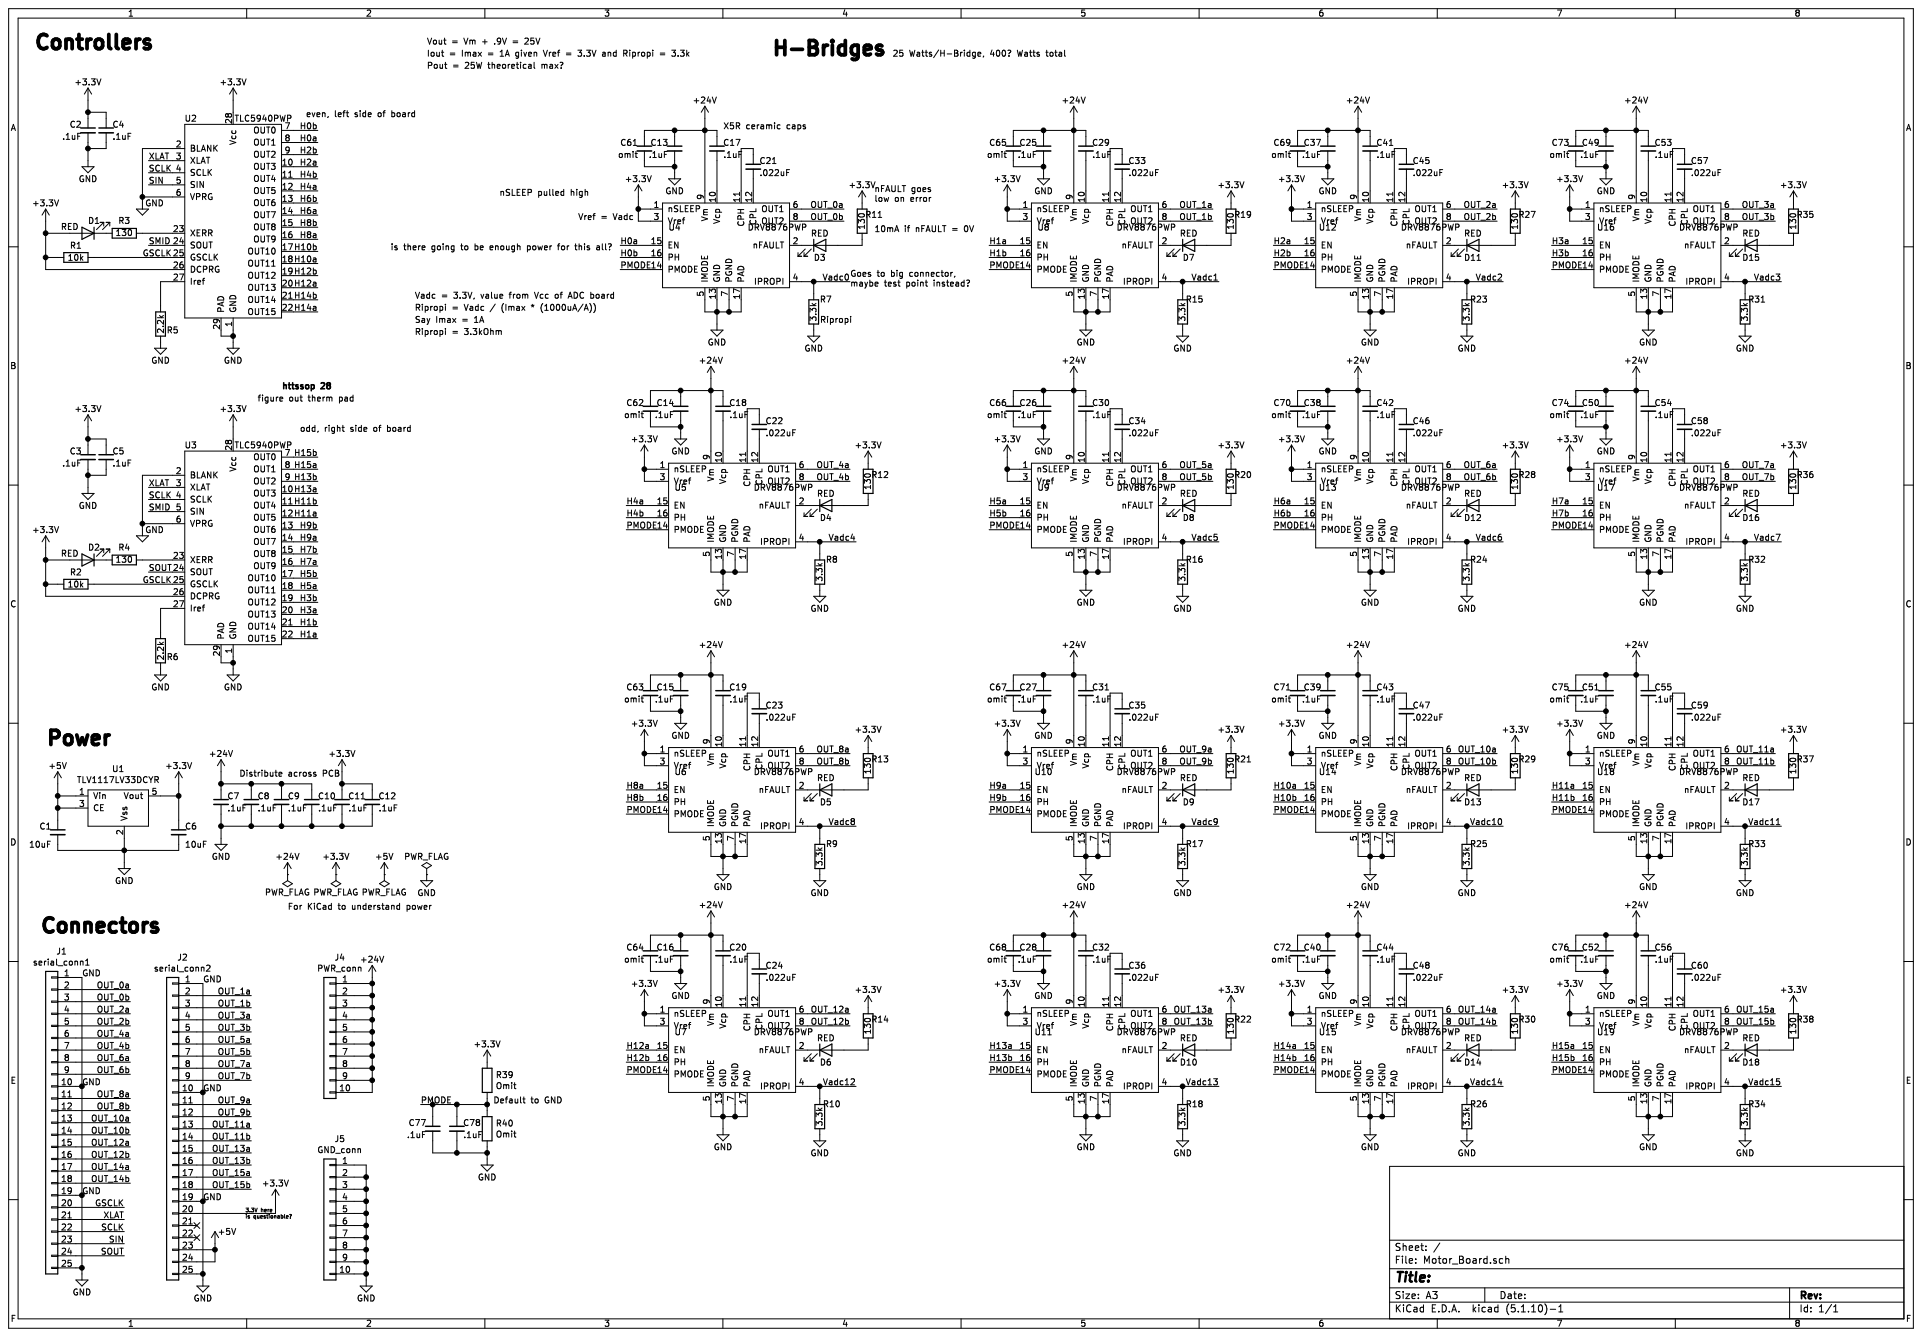
[picture p26: page 1]
