wayoffthecoast/reference-PDB-files/AUX/PDFs/Auxiliary_Board-B.Cu.pdf

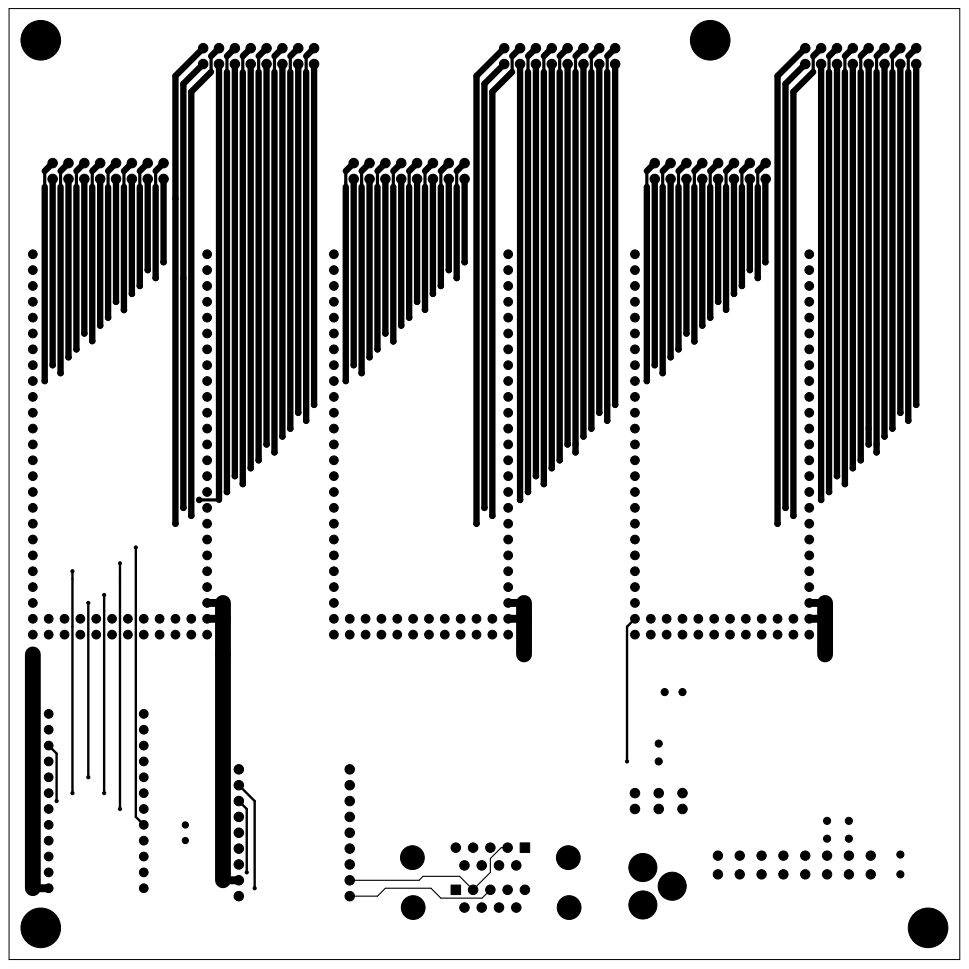
[picture p27: page 1]
