wayoffthecoast/reference-PDB-files/AUX/PDFs/Auxiliary_Board-B.Mask.pdf

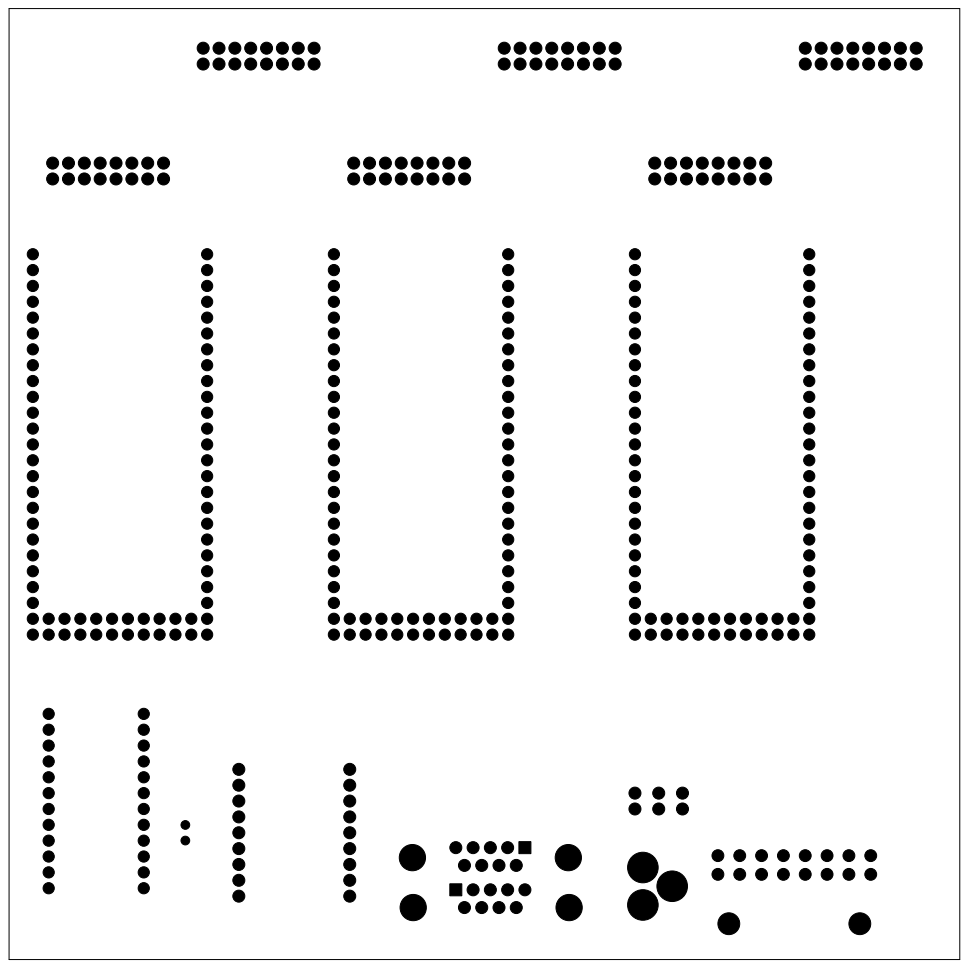
[picture p28: page 1]
