wayoffthecoast/reference-PDB-files/AUX/PDFs/Auxiliary_Board-Dwgs.User.pdf

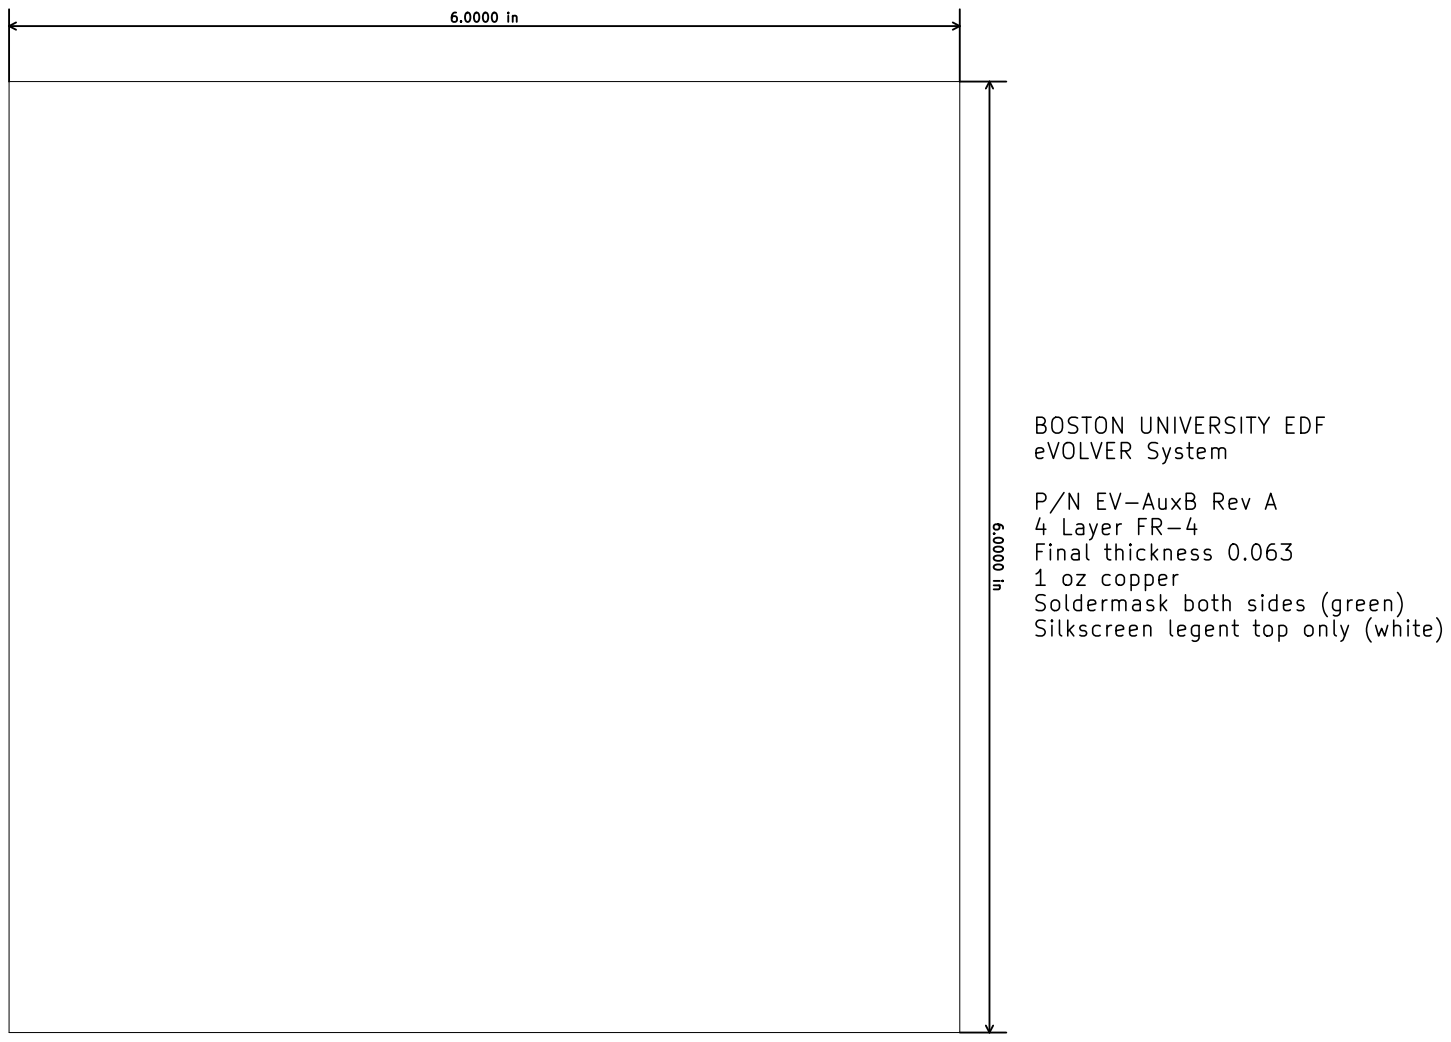
[picture p29: page 1]
