wayoffthecoast/reference-PDB-files/AUX/PDFs/Auxiliary_Board-F.Cu.pdf

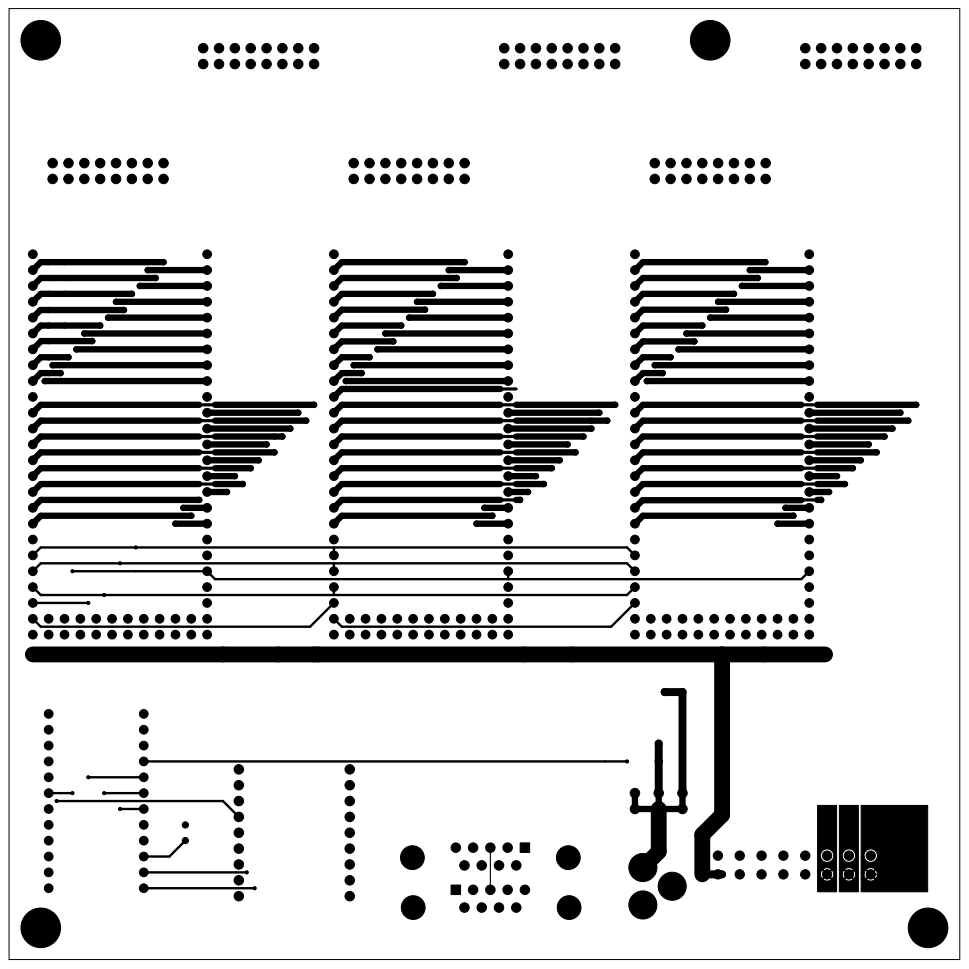
[picture p30: page 1]
