wayoffthecoast/reference-PDB-files/AUX/PDFs/Auxiliary_Board-F.SilkS.pdf

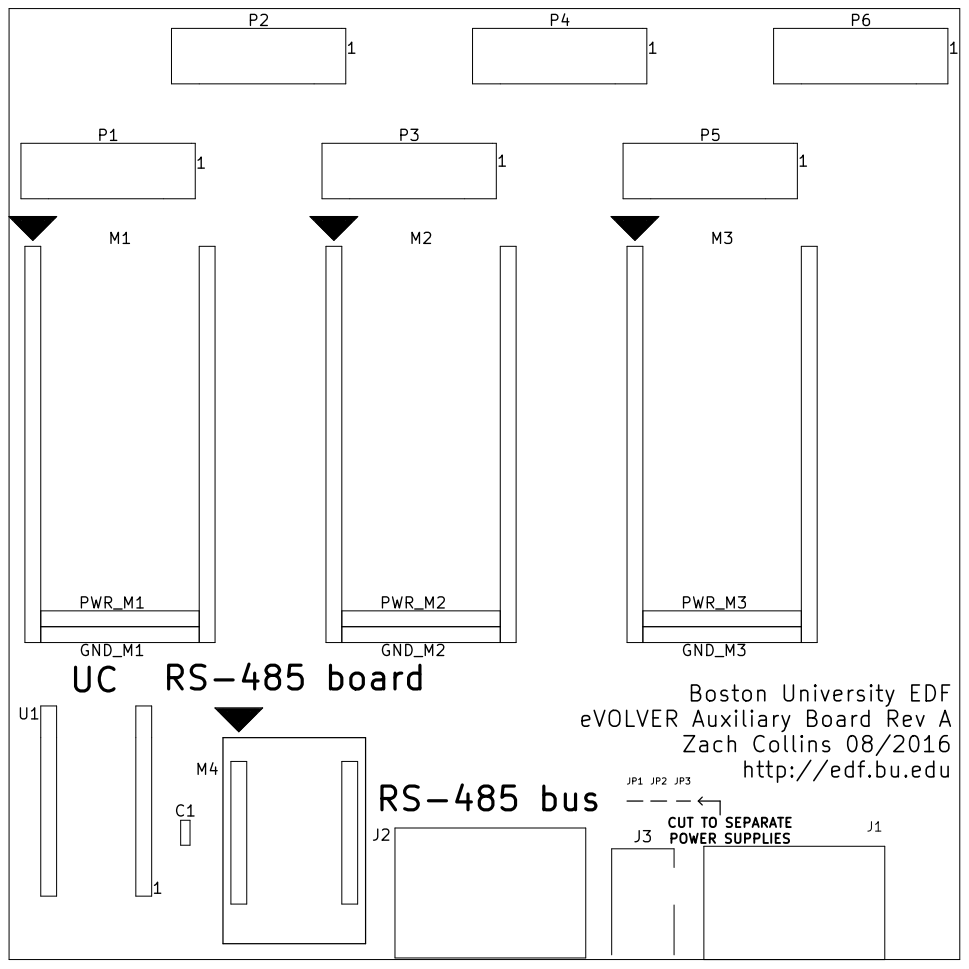
[picture p31: page 1]
