wayoffthecoast/reference-PDB-files/AUX/PDFs/Auxiliary_Board-In1.Cu.pdf

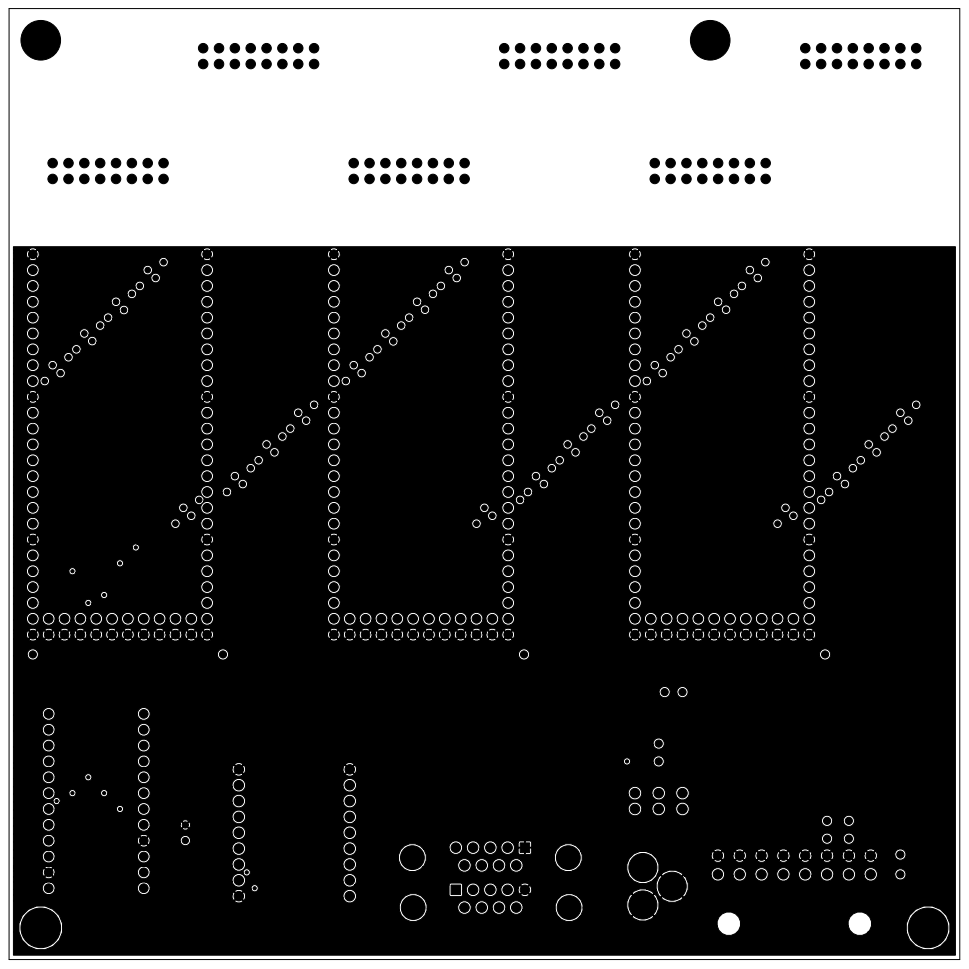
[picture p32: page 1]
