wayoffthecoast/reference-PDB-files/AUX/PDFs/Auxiliary_Board-In2.Cu.pdf

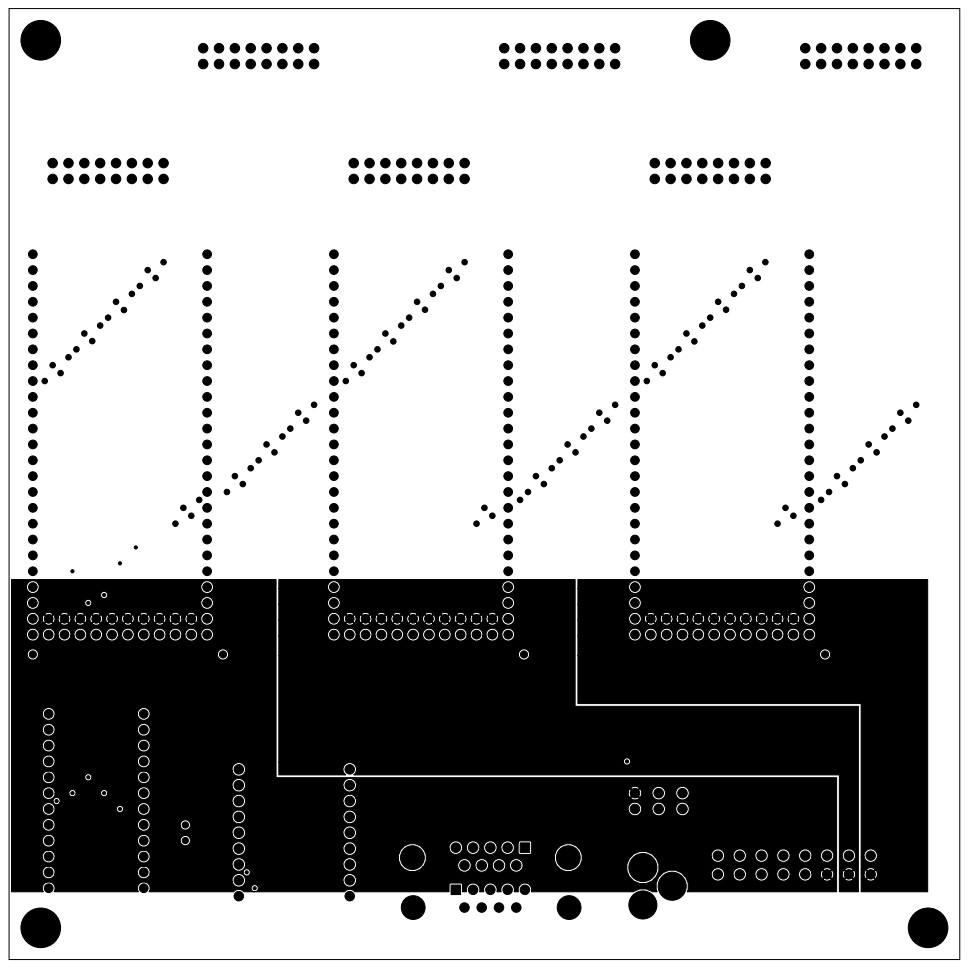
[picture p33: page 1]
