wayoffthecoast/reference-PDB-files/Motherboard/PDFs/Motherboard-F.Cu.pdf

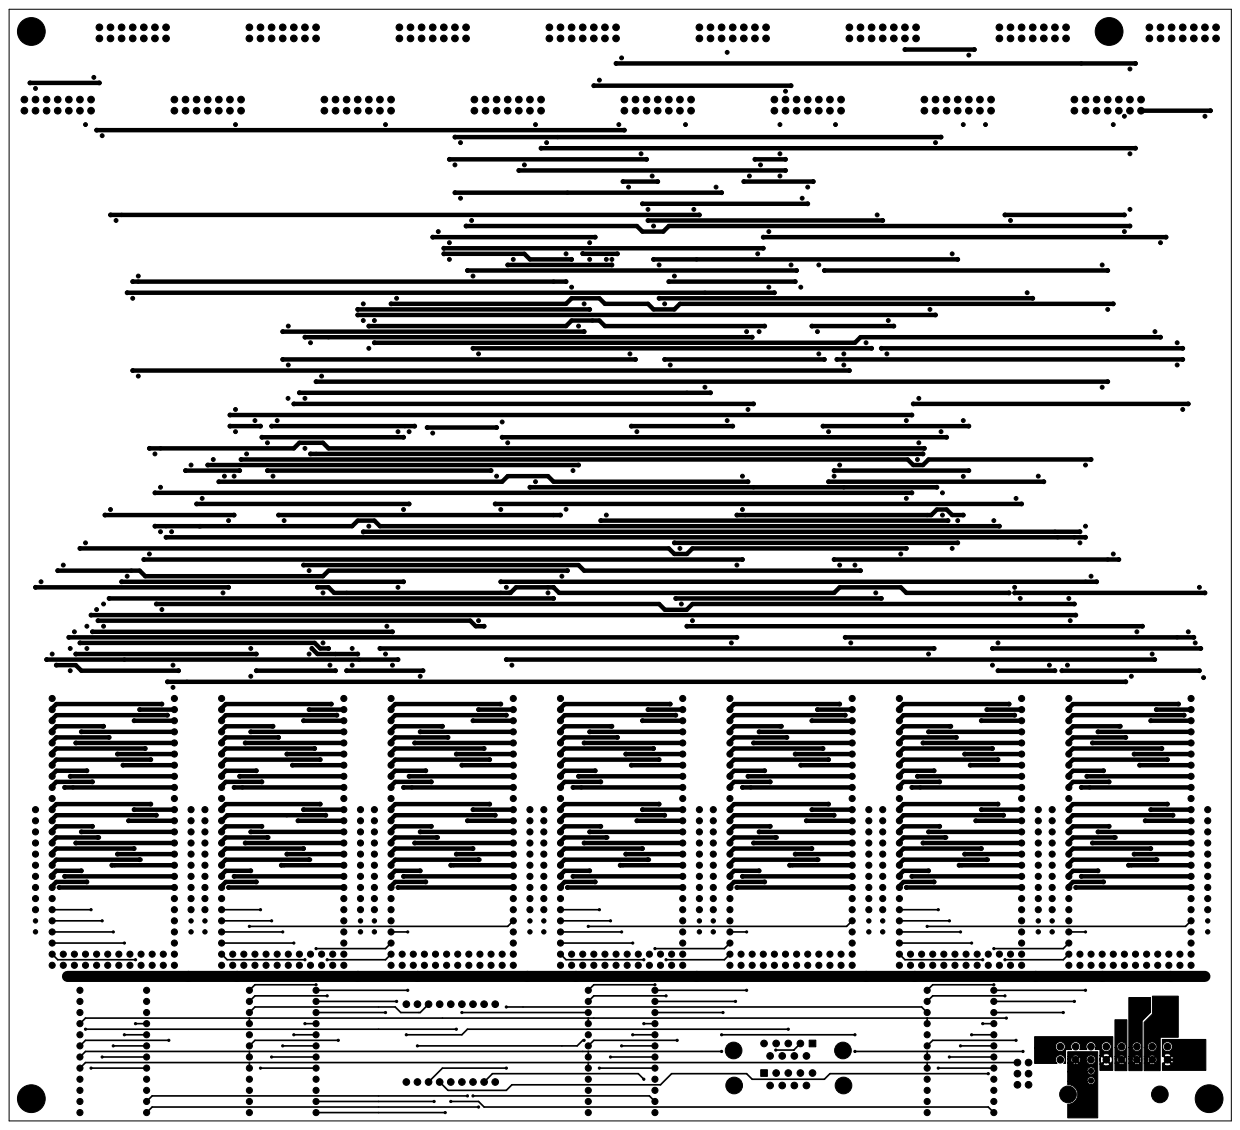
[picture p34: page 1]
