wayoffthecoast/reference-PDB-files/Motherboard/PDFs/Motherboard-F.SilkS.pdf

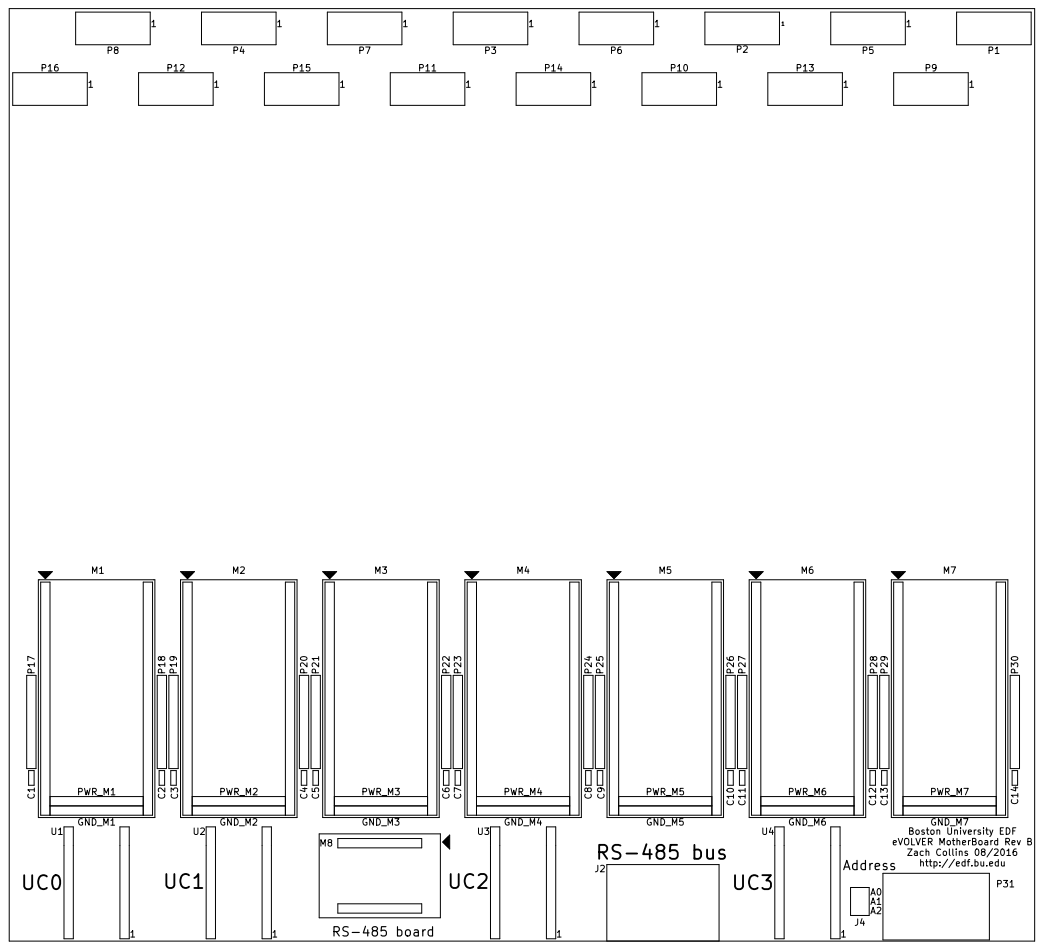
[picture p35: page 1]

Boston University EDF
eVOLVER MotherBoard Rev B
Zach Collins 08/2016
http://edf.bu.edu
