wayoffthecoast/reference-PDB-files/Motor_Board/Motor_Board.kicad_pcb

## KiCad design Motor_Board/Motor_Board.kicad_pcb (2021-12-21)

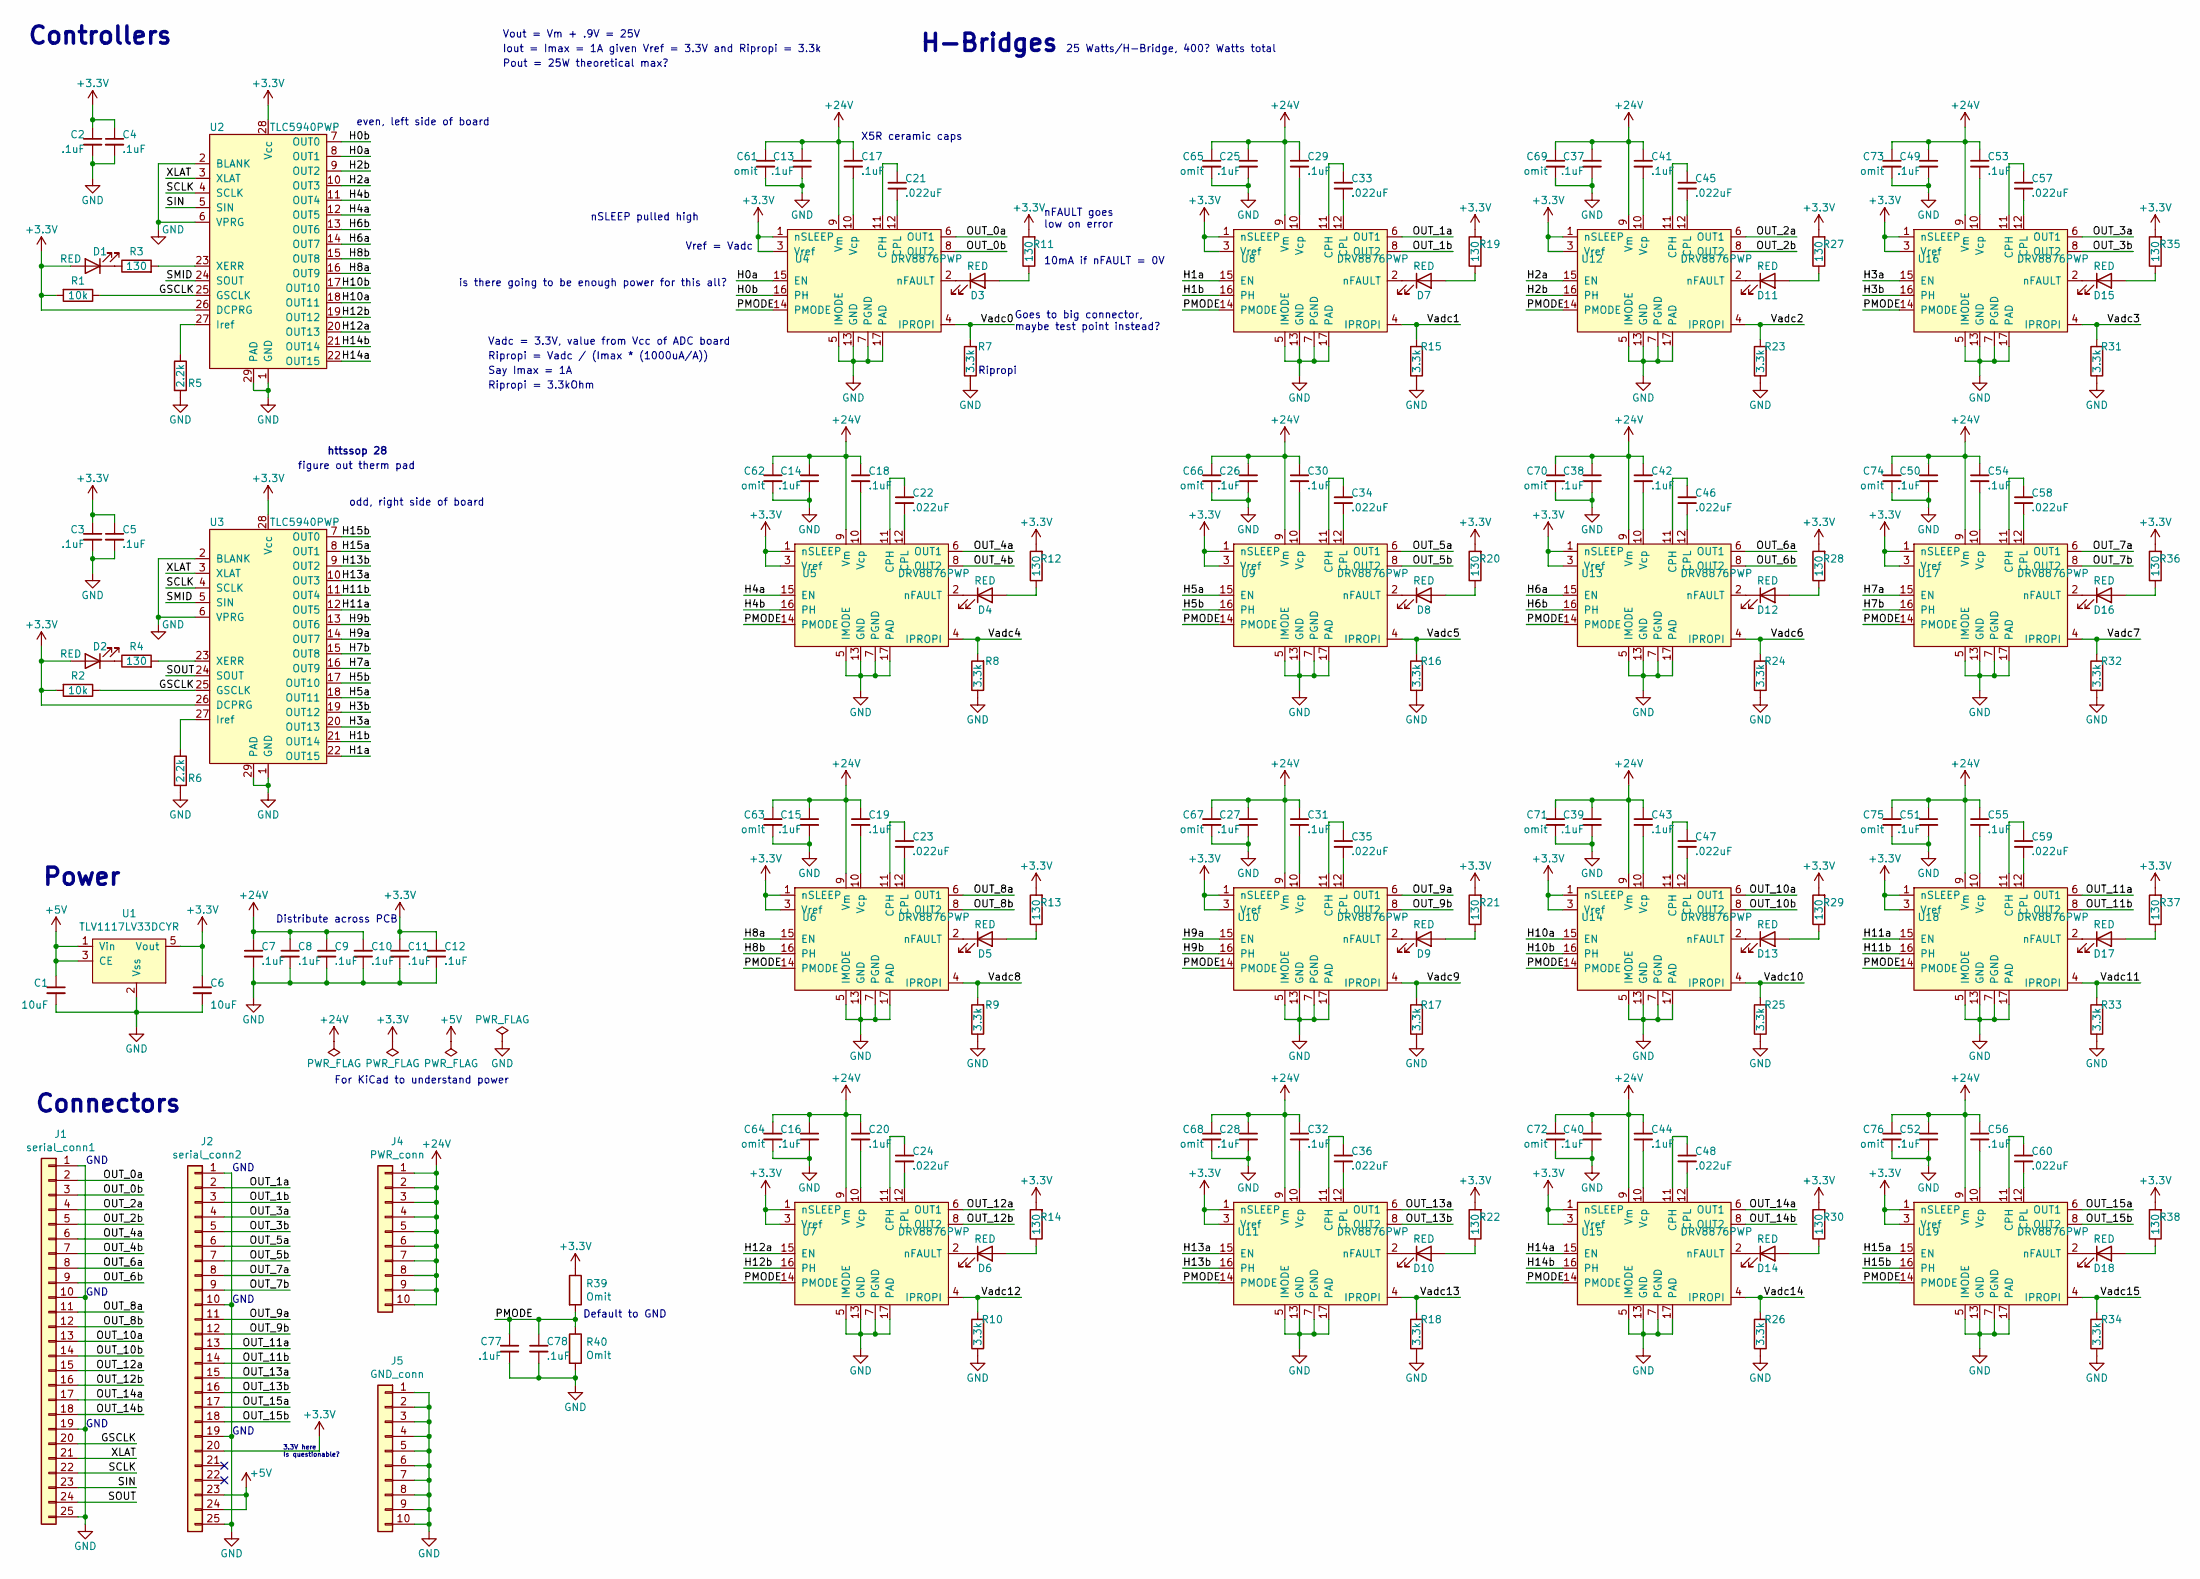
[picture p36: schematic Motor_Board.sch]

Parts:
C1, C6: 10uF; C_0402_1005Metric_lines
C2, C3, C4, C5, C7, C8, C9, C10, C11, C12, C13, C14, C15, C16, C17, C18, C19, C20, C25, C26, C27, C28, C29, C30, C31, C32, C37, C38, C39, C40, C41, C42, C43, C44, C49, C50, C51, C52, C53, C54, C55, C56, C77, C78: .1uF; C_0402_1005Metric_lines
C21, C22, C23, C24, C33, C34, C35, C36, C45, C46, C47, C48, C57, C58, C59, C60: .022uF; C_0402_1005Metric_lines
C61, C62, C63, C64, C65, C66, C67, C68, C69, C70, C71, C72, C73, C74, C75, C76: omit; C_0603_1608Metric_Pad1.05x0.95mm_HandSolder
D1, D2, D3, D4, D5, D6, D7, D8, D9, D10, D11, D12, D13, D14, D15, D16, D17, D18: RED; D_0402_1005Metric_lines
J1: serial_conn1; PinSocket_1x25_P2.54mm_Vertical
J2: serial_conn2; PinSocket_1x25_P2.54mm_Vertical
J4: PWR_conn; PinSocket_1x10_P2.54mm_Vertical
J5: GND_conn; PinSocket_1x10_P2.54mm_Vertical
R1, R2: 10k; R_0402_1005Metric_lines
R3, R4, R11, R12, R13, R14, R19, R20, R21, R22, R27, R28, R29, R30, R35, R36, R37, R38: 130; R_0402_1005Metric_lines
R5, R6: 2.2k; R_0402_1005Metric_lines
R7, R8, R10, R15, R16, R17, R18, R23, R24, R25, R26, R31, R32, R33, R34: 3.3k; R_0402_1005Metric_lines
R9: 3.3k; R_0402_1005Metric
R39, R40: Omit; C_0402_1005Metric_lines
U1: TLV1117LV33DCYR; SOT-23-5
U2, U3: TLC5940PWP; HTSSOP-28-1EP_4.4x9.7mm_P0.65mm_EP2.85x5.4mm_ThermalVias
U4, U5, U6, U7, U8, U9, U10, U11, U12, U13, U14, U15, U16, U17, U18, U19: DRV8876PWP; QFN-16-1EP_3x3mm_P0.5mm_EP1.75x1.75mm_ThermalVias

Connections:
+3V3: C2.1, C3.1, C4.1, C5.1, C6.1, C11.1, C12.1, D1.2 (A), D2.2 (A), J2.20, R1.2, R2.2, R11.2, R12.2, R13.2, R14.2, R19.2, R20.2, R21.2, R22.2, R27.2, R28.2, R29.2, R30.2, R35.2, R36.2, R37.2, R38.2, R39.1, U1.5 (Vout), U2.26 (DCPRG), U2.28 (Vcc), U3.26 (DCPRG), U3.28 (Vcc), U4.1 (nSLEEP), U4.3 (Vref), U5.1 (nSLEEP), U5.3 (Vref), U6.1 (nSLEEP), U6.3 (Vref), U7.1 (nSLEEP), U7.3 (Vref), U8.1 (nSLEEP), U8.3 (Vref), U9.1 (nSLEEP), U9.3 (Vref), U10.1 (nSLEEP), U10.3 (Vref), U11.1 (nSLEEP), U11.3 (Vref), U12.1 (nSLEEP), U12.3 (Vref), U13.1 (nSLEEP), U13.3 (Vref), U14.1 (nSLEEP), U14.3 (Vref), U15.1 (nSLEEP), U15.3 (Vref), U16.1 (nSLEEP), U16.3 (Vref), U17.1 (nSLEEP), U17.3 (Vref), U18.1 (nSLEEP), U18.3 (Vref), U19.1 (nSLEEP), U19.3 (Vref)
+5V: C1.1, J2.23, J2.24, U1.1 (Vin), U1.3 (CE)
+24V: C7.1, C8.1, C9.1, C10.1, C13.1, C14.1, C15.1, C16.1, C17.1, C18.1, C19.1, C20.1, C25.1, C26.1, C27.1, C28.1, C29.1, C30.1, C31.1, C32.1, C37.1, C38.1, C39.1, C40.1, C41.1, C42.1, C43.1, C44.1, C49.1, C50.1, C51.1, C52.1, C53.1, C54.1, C55.1, C56.1, C61.1, C62.1, C63.1, C64.1, C65.1, C66.1, C67.1, C68.1, C69.1, C70.1, C71.1, C72.1, C73.1, C74.1, C75.1, C76.1, J4.1, J4.2, J4.3, J4.4, J4.5, J4.6, J4.7, J4.8, J4.9, J4.10, U4.9 (Vm), U5.9 (Vm), U6.9 (Vm), U7.9 (Vm), U8.9 (Vm), U9.9 (Vm), U10.9 (Vm), U11.9 (Vm), U12.9 (Vm), U13.9 (Vm), U14.9 (Vm), U15.9 (Vm), U16.9 (Vm), U17.9 (Vm), U18.9 (Vm), U19.9 (Vm)
/GSCLK: J1.20, R1.1, R2.1, U2.25 (GSCLK), U3.25 (GSCLK)
/H0a: U2.8 (OUT1), U4.15 (EN)
/H0b: U2.7 (OUT0), U4.16 (PH)
/H1a: U3.22 (OUT15), U8.15 (EN)
/H1b: U3.21 (OUT14), U8.16 (PH)
/H2a: U2.10 (OUT3), U12.15 (EN)
/H2b: U2.9 (OUT2), U12.16 (PH)
/H3a: U3.20 (OUT13), U16.15 (EN)
/H3b: U3.19 (OUT12), U16.16 (PH)
/H4a: U2.12 (OUT5), U5.15 (EN)
/H4b: U2.11 (OUT4), U5.16 (PH)
/H5a: U3.18 (OUT11), U9.15 (EN)
/H5b: U3.17 (OUT10), U9.16 (PH)
/H6a: U2.14 (OUT7), U13.15 (EN)
/H6b: U2.13 (OUT6), U13.16 (PH)
/H7a: U3.16 (OUT9), U17.15 (EN)
/H7b: U3.15 (OUT8), U17.16 (PH)
/H8a: U2.16 (OUT9), U6.15 (EN)
/H8b: U2.15 (OUT8), U6.16 (PH)
/H9a: U3.14 (OUT7), U10.15 (EN)
/H9b: U3.13 (OUT6), U10.16 (PH)
/H10a: U2.18 (OUT11), U14.15 (EN)
/H10b: U2.17 (OUT10), U14.16 (PH)
/H11a: U3.12 (OUT5), U18.15 (EN)
/H11b: U3.11 (OUT4), U18.16 (PH)
/H12a: U2.20 (OUT13), U7.15 (EN)
/H12b: U2.19 (OUT12), U7.16 (PH)
/H13a: U3.10 (OUT3), U11.15 (EN)
/H13b: U3.9 (OUT2), U11.16 (PH)
/H14a: U2.22 (OUT15), U15.15 (EN)
/H14b: U2.21 (OUT14), U15.16 (PH)
/H15a: U3.8 (OUT1), U19.15 (EN)
/H15b: U3.7 (OUT0), U19.16 (PH)
/OUT_0a: J1.2, U4.6 (OUT1)
/OUT_0b: J1.3, U4.8 (OUT2)
/OUT_1a: J2.2, U8.6 (OUT1)
/OUT_1b: J2.3, U8.8 (OUT2)
/OUT_2a: J1.4, U12.6 (OUT1)
/OUT_2b: J1.5, U12.8 (OUT2)
/OUT_3a: J2.4, U16.6 (OUT1)
/OUT_3b: J2.5, U16.8 (OUT2)
/OUT_4a: J1.6, U5.6 (OUT1)
/OUT_4b: J1.7, U5.8 (OUT2)
/OUT_5a: J2.6, U9.6 (OUT1)
/OUT_5b: J2.7, U9.8 (OUT2)
/OUT_6a: J1.8, U13.6 (OUT1)
/OUT_6b: J1.9, U13.8 (OUT2)
/OUT_7a: J2.8, U17.6 (OUT1)
/OUT_7b: J2.9, U17.8 (OUT2)
/OUT_8a: J1.11, U6.6 (OUT1)
/OUT_8b: J1.12, U6.8 (OUT2)
/OUT_9a: J2.11, U10.6 (OUT1)
/OUT_9b: J2.12, U10.8 (OUT2)
/OUT_10a: J1.13, U14.6 (OUT1)
/OUT_10b: J1.14, U14.8 (OUT2)
/OUT_11a: J2.13, U18.6 (OUT1)
/OUT_11b: J2.14, U18.8 (OUT2)
/OUT_12a: J1.15, U7.6 (OUT1)
/OUT_12b: J1.16, U7.8 (OUT2)
/OUT_13a: J2.15, U11.6 (OUT1)
/OUT_13b: J2.16, U11.8 (OUT2)
/OUT_14a: J1.17, U15.6 (OUT1)
/OUT_14b: J1.18, U15.8 (OUT2)
/OUT_15a: J2.17, U19.6 (OUT1)
/OUT_15b: J2.18, U19.8 (OUT2)
/PMODE: C77.1, C78.1, R39.2, R40.1, U4.14 (PMODE), U5.14 (PMODE), U6.14 (PMODE), U7.14 (PMODE), U8.14 (PMODE), U9.14 (PMODE), U10.14 (PMODE), U11.14 (PMODE), U12.14 (PMODE), U13.14 (PMODE), U14.14 (PMODE), U15.14 (PMODE), U16.14 (PMODE), U17.14 (PMODE), U18.14 (PMODE), U19.14 (PMODE)
/SCLK: J1.22, U2.4 (SCLK), U3.4 (SCLK)
/SIN: J1.23, U2.5 (SIN)
/SMID: U2.24 (SOUT), U3.5 (SIN)
/SOUT: J1.24, U3.24 (SOUT)
/Vadc0: R7.2, U4.4 (IPROPI)
/Vadc1: R15.2, U8.4 (IPROPI)
/Vadc2: R23.2, U12.4 (IPROPI)
/Vadc3: R31.2, U16.4 (IPROPI)
/Vadc4: R8.2, U5.4 (IPROPI)
/Vadc5: R16.2, U9.4 (IPROPI)
/Vadc6: R24.2, U13.4 (IPROPI)
/Vadc7: R32.2, U17.4 (IPROPI)
/Vadc8: R9.2, U6.4 (IPROPI)
/Vadc9: R17.2, U10.4 (IPROPI)
/Vadc10: R25.2, U14.4 (IPROPI)
/Vadc11: R33.2, U18.4 (IPROPI)
/Vadc12: R10.2, U7.4 (IPROPI)
/Vadc13: R18.2, U11.4 (IPROPI)
/Vadc14: R26.2, U15.4 (IPROPI)
/Vadc15: R34.2, U19.4 (IPROPI)
/XLAT: J1.21, U2.3 (XLAT), U3.3 (XLAT)
GND: C1.2, C2.2, C3.2, C4.2, C5.2, C6.2, C7.2, C8.2, C9.2, C10.2, C11.2, C12.2, C13.2, C14.2, C15.2, C16.2, C25.2, C26.2, C27.2, C28.2, C37.2, C38.2, C39.2, C40.2, C49.2, C50.2, C51.2, C52.2, C61.2, C62.2, C63.2, C64.2, C65.2, C66.2, C67.2, C68.2, C69.2, C70.2, C71.2, C72.2, C73.2, C74.2, C75.2, C76.2, C77.2, C78.2, J1.1, J1.10, J1.19, J1.25, J2.1, J2.10, J2.19, J2.25, J5.1, J5.2, J5.3, J5.4, J5.5, J5.6, J5.7, J5.8, J5.9, J5.10, R5.2, R6.2, R7.1, R8.1, R9.1, R10.1, R15.1, R16.1, R17.1, R18.1, R23.1, R24.1, R25.1, R26.1, R31.1, R32.1, R33.1, R34.1, R40.2, U1.2 (Vss), U2.1 (GND), U2.2 (BLANK), U2.6 (VPRG), U2.29 (PAD), U3.1 (GND), U3.2 (BLANK), U3.6 (VPRG), U3.29 (PAD), U4.5 (IMODE), U4.7 (PGND), U4.13 (GND), U4.17 (PAD), U5.5 (IMODE), U5.7 (PGND), U5.13 (GND), U5.17 (PAD), U6.5 (IMODE), U6.7 (PGND), U6.13 (GND), U6.17 (PAD), U7.5 (IMODE), U7.7 (PGND), U7.13 (GND), U7.17 (PAD), U8.5 (IMODE), U8.7 (PGND), U8.13 (GND), U8.17 (PAD), U9.5 (IMODE), U9.7 (PGND), U9.13 (GND), U9.17 (PAD), U10.5 (IMODE), U10.7 (PGND), U10.13 (GND), U10.17 (PAD), U11.5 (IMODE), U11.7 (PGND), U11.13 (GND), U11.17 (PAD), U12.5 (IMODE), U12.7 (PGND), U12.13 (GND), U12.17 (PAD), U13.5 (IMODE), U13.7 (PGND), U13.13 (GND), U13.17 (PAD), U14.5 (IMODE), U14.7 (PGND), U14.13 (GND), U14.17 (PAD), U15.5 (IMODE), U15.7 (PGND), U15.13 (GND), U15.17 (PAD), U16.5 (IMODE), U16.7 (PGND), U16.13 (GND), U16.17 (PAD), U17.5 (IMODE), U17.7 (PGND), U17.13 (GND), U17.17 (PAD), U18.5 (IMODE), U18.7 (PGND), U18.13 (GND), U18.17 (PAD), U19.5 (IMODE), U19.7 (PGND), U19.13 (GND), U19.17 (PAD)
unnamed: C17.2, U4.10 (Vcp)
unnamed: C18.2, U5.10 (Vcp)
unnamed: C19.2, U6.10 (Vcp)
unnamed: C20.2, U7.10 (Vcp)
unnamed: C21.1, U4.11 (CPH)
unnamed: C21.2, U4.12 (CPL)
unnamed: C22.1, U5.11 (CPH)
unnamed: C22.2, U5.12 (CPL)
unnamed: C23.1, U6.11 (CPH)
unnamed: C23.2, U6.12 (CPL)
unnamed: C24.1, U7.11 (CPH)
unnamed: C24.2, U7.12 (CPL)
unnamed: C29.2, U8.10 (Vcp)
unnamed: C30.2, U9.10 (Vcp)
unnamed: C31.2, U10.10 (Vcp)
unnamed: C32.2, U11.10 (Vcp)
unnamed: C33.1, U8.11 (CPH)
unnamed: C33.2, U8.12 (CPL)
unnamed: C34.1, U9.11 (CPH)
unnamed: C34.2, U9.12 (CPL)
unnamed: C35.1, U10.11 (CPH)
unnamed: C35.2, U10.12 (CPL)
unnamed: C36.1, U11.11 (CPH)
unnamed: C36.2, U11.12 (CPL)
unnamed: C41.2, U12.10 (Vcp)
unnamed: C42.2, U13.10 (Vcp)
unnamed: C43.2, U14.10 (Vcp)
unnamed: C44.2, U15.10 (Vcp)
unnamed: C45.1, U12.11 (CPH)
unnamed: C45.2, U12.12 (CPL)
unnamed: C46.1, U13.11 (CPH)
unnamed: C46.2, U13.12 (CPL)
unnamed: C47.1, U14.11 (CPH)
unnamed: C47.2, U14.12 (CPL)
unnamed: C48.1, U15.11 (CPH)
unnamed: C48.2, U15.12 (CPL)
unnamed: C53.2, U16.10 (Vcp)
unnamed: C54.2, U17.10 (Vcp)
unnamed: C55.2, U18.10 (Vcp)
unnamed: C56.2, U19.10 (Vcp)
unnamed: C57.1, U16.11 (CPH)
unnamed: C57.2, U16.12 (CPL)
unnamed: C58.1, U17.11 (CPH)
unnamed: C58.2, U17.12 (CPL)
unnamed: C59.1, U18.11 (CPH)
unnamed: C59.2, U18.12 (CPL)
unnamed: C60.1, U19.11 (CPH)
unnamed: C60.2, U19.12 (CPL)
unnamed: D1.1 (K), R3.1
unnamed: D2.1 (K), R4.1
unnamed: D3.1 (K), U4.2 (nFAULT)
unnamed: D3.2 (A), R11.1
unnamed: D4.1 (K), U5.2 (nFAULT)
unnamed: D4.2 (A), R12.1
unnamed: D5.1 (K), U6.2 (nFAULT)
unnamed: D5.2 (A), R13.1
unnamed: D6.1 (K), U7.2 (nFAULT)
unnamed: D6.2 (A), R14.1
unnamed: D7.1 (K), U8.2 (nFAULT)
unnamed: D7.2 (A), R19.1
unnamed: D8.1 (K), U9.2 (nFAULT)
unnamed: D8.2 (A), R20.1
unnamed: D9.1 (K), U10.2 (nFAULT)
unnamed: D9.2 (A), R21.1
unnamed: D10.1 (K), U11.2 (nFAULT)
unnamed: D10.2 (A), R22.1
unnamed: D11.1 (K), U12.2 (nFAULT)
unnamed: D11.2 (A), R27.1
unnamed: D12.1 (K), U13.2 (nFAULT)
unnamed: D12.2 (A), R28.1
unnamed: D13.1 (K), U14.2 (nFAULT)
unnamed: D13.2 (A), R29.1
unnamed: D14.1 (K), U15.2 (nFAULT)
unnamed: D14.2 (A), R30.1
unnamed: D15.1 (K), U16.2 (nFAULT)
unnamed: D15.2 (A), R35.1
unnamed: D16.1 (K), U17.2 (nFAULT)
unnamed: D16.2 (A), R36.1
unnamed: D17.1 (K), U18.2 (nFAULT)
unnamed: D17.2 (A), R37.1
unnamed: D18.1 (K), U19.2 (nFAULT)
unnamed: D18.2 (A), R38.1
unnamed: R3.2, U2.23 (XERR)
unnamed: R4.2, U3.23 (XERR)
unnamed: R5.1, U2.27 (Iref)
unnamed: R6.1, U3.27 (Iref)

Notes on the sheet:
Connectors
Controllers
H-Bridges
3.3V here is questionable?
GND
Power
Distribute across PCB
X5R ceramic caps
nFAULT goes low on error
is there going to be enough power for this all?
Ripropi
Vadc = 3.3V, value from Vcc of ADC board
Ripropi = Vadc / (Imax * (1000uA/A))
Say Imax = 1A
Ripropi = 3.3kOhm
Vref = Vadc
nSLEEP pulled high
10mA if nFAULT = 0V
25 Watts/H-Bridge, 400? Watts total
For KiCad to understand power
Goes to big connector, maybe test point instead?
Vout = Vm + .9V = 25V
Iout = Imax = 1A given Vref = 3.3V and Ripropi = 3.3k
Pout = 25W theoretical max?
httssop 28
figure out therm pad
even, left side of board
odd, right side of board
Default to GND

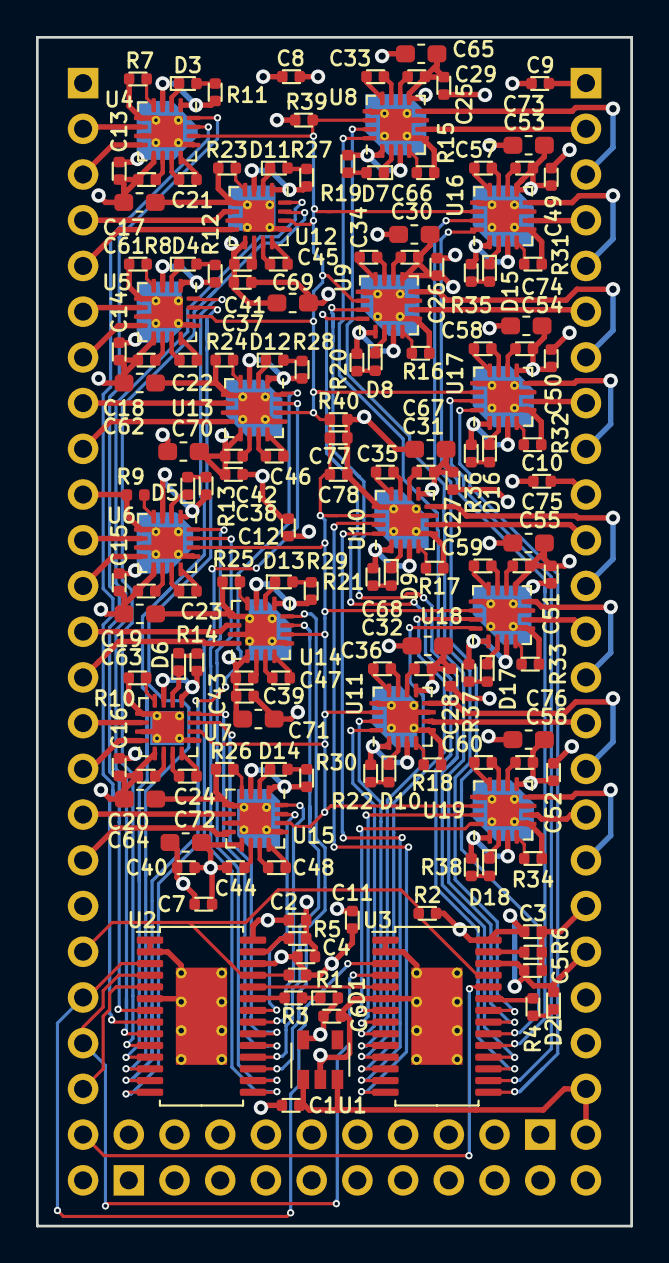
[picture p37: board Motor_Board.kicad_pcb from above]

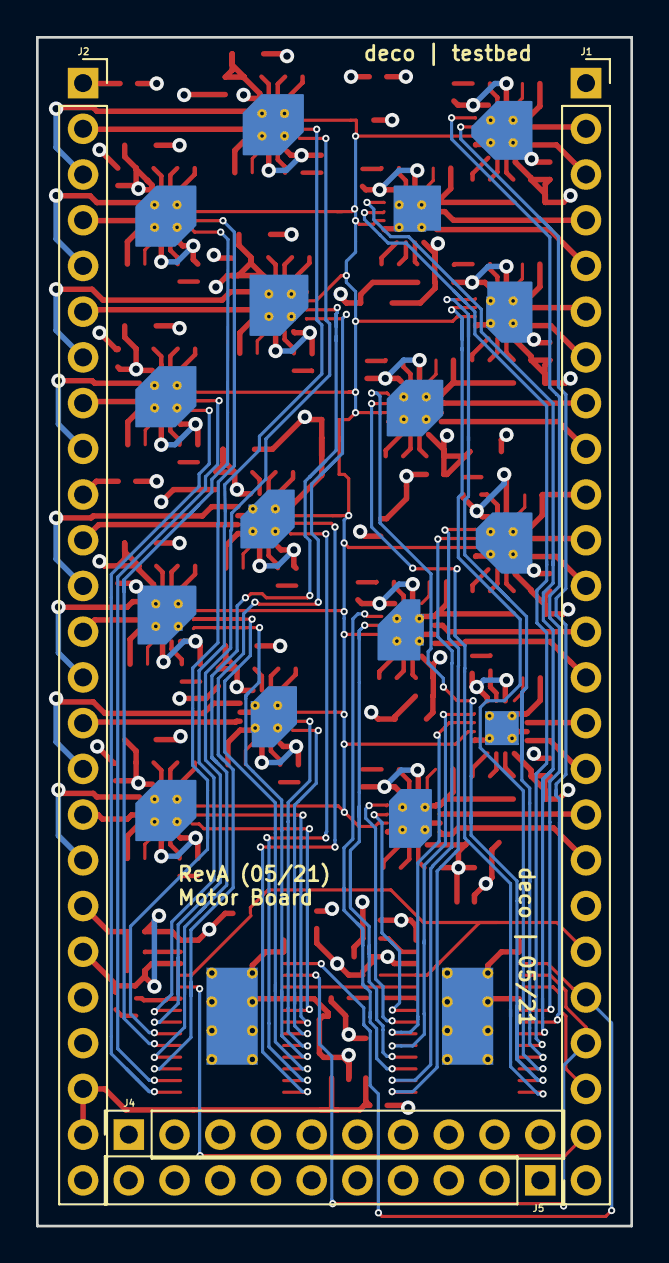
[picture p38: board Motor_Board.kicad_pcb from below]

Board: 4 copper layers, 33.0 x 66.0 mm, 159 parts (4 on the bottom side), 177 nets.
