wayoffthecoast/reference-PDB-files/pump_board/Rev C/PCB/pump_board/pump_board.kicad_pcb

## KiCad design pump_board/Rev C/PCB/pump_board/pump_board.kicad_pcb (2021-12-21)

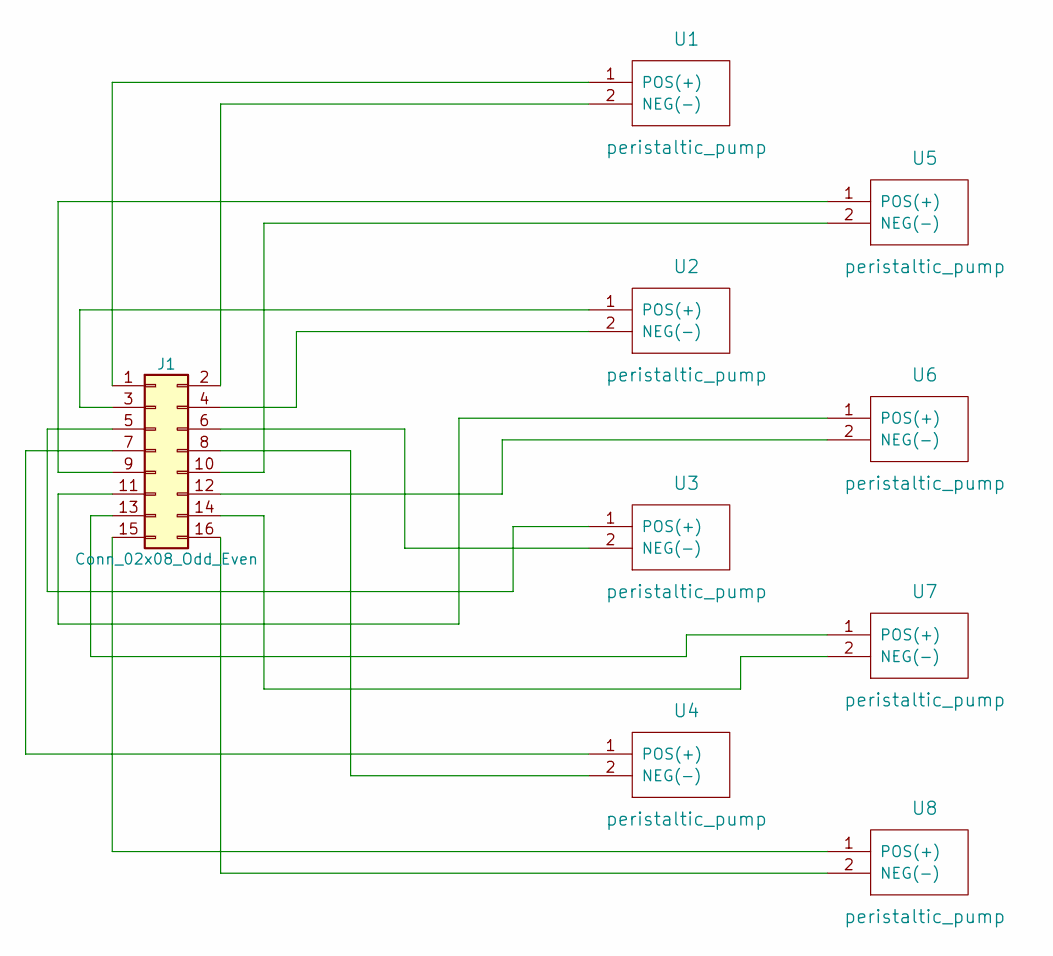
[picture p39: schematic pump_board.sch]

Parts:
J1: Conn_02x08_Odd_Even; pump_2x8_connector
U1, U2, U3, U4, U5, U6, U7, U8: peristaltic_pump; peristlatic_pump_2020_04_29

Connections:
unnamed: J1.1, U1.1 (POS(+))
unnamed: J1.2, U1.2 (NEG(-))
unnamed: J1.3, U2.1 (POS(+))
unnamed: J1.4, U2.2 (NEG(-))
unnamed: J1.5, U3.1 (POS(+))
unnamed: J1.6, U3.2 (NEG(-))
unnamed: J1.7, U4.1 (POS(+))
unnamed: J1.8, U4.2 (NEG(-))
unnamed: J1.9, U5.1 (POS(+))
unnamed: J1.10, U5.2 (NEG(-))
unnamed: J1.11, U6.1 (POS(+))
unnamed: J1.12, U6.2 (NEG(-))
unnamed: J1.13, U7.1 (POS(+))
unnamed: J1.14, U7.2 (NEG(-))
unnamed: J1.15, U8.1 (POS(+))
unnamed: J1.16, U8.2 (NEG(-))

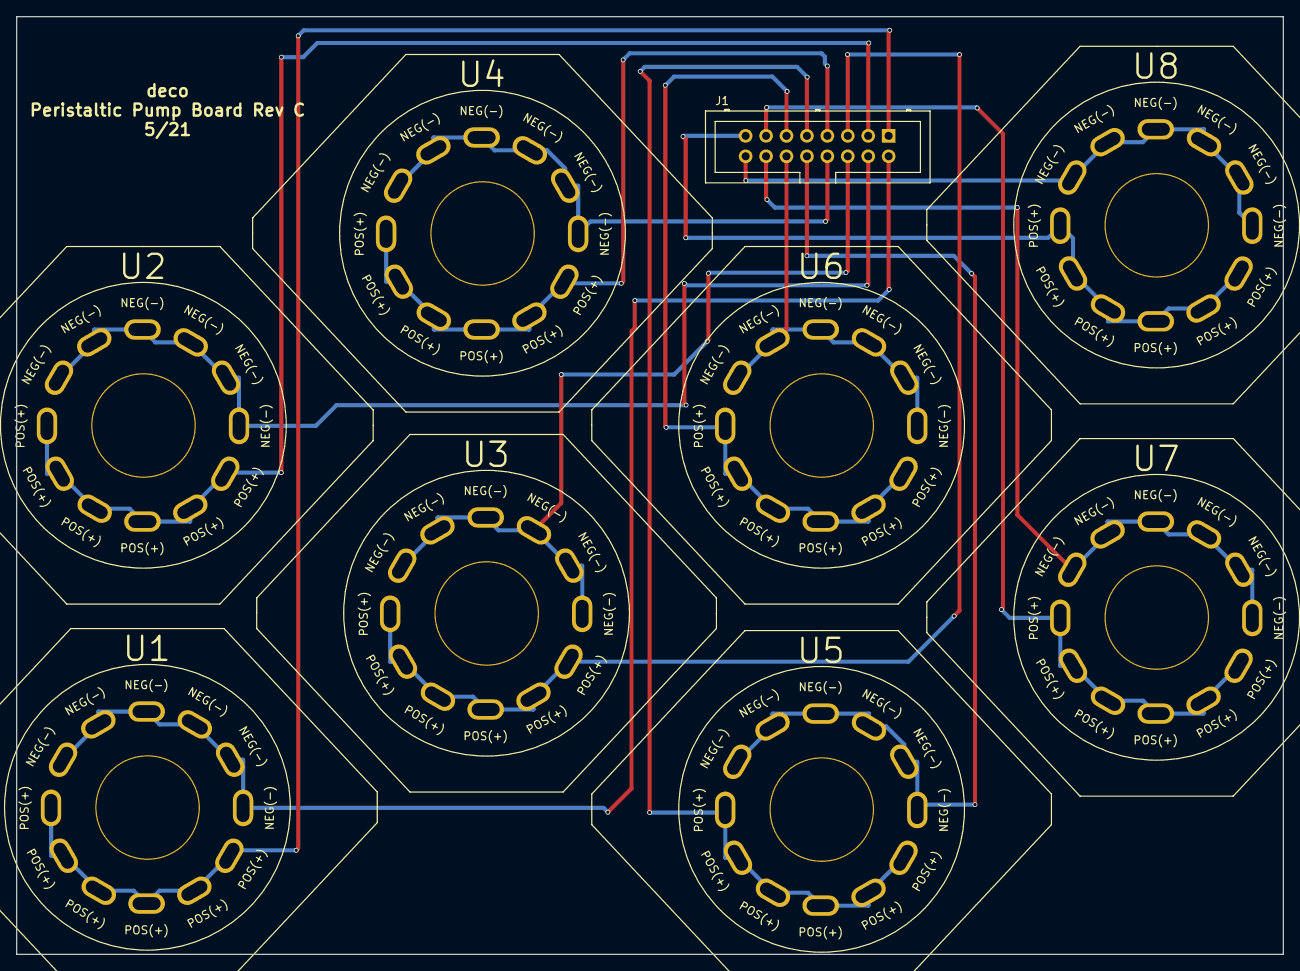
[picture p40: board pump_board.kicad_pcb from above]

Board: 2 copper layers, 157.5 x 116.6 mm, 9 parts (0 on the bottom side), 16 nets.
