wayoffthecoast/reference-PDB-files/Debug-Chip-001/Debug-Chip-001.kicad_pcb

## KiCad design Debug-Chip-001/Debug-Chip-001.kicad_pcb (2021-12-21)

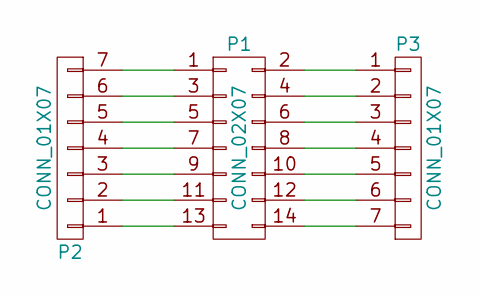
[picture p41: schematic Debug-Chip-001.sch]

Parts:
P1: CONN_02X07; 2x7_pin_10in
P2, P3: CONN_01X07; Pin_Header_Straight_1x07_Pitch2.54mm

Connections:
unnamed: P1.1, P2.7
unnamed: P1.2, P3.1
unnamed: P1.3, P2.6
unnamed: P1.4, P3.2
unnamed: P1.5, P2.5
unnamed: P1.6, P3.3
unnamed: P1.7, P2.4
unnamed: P1.8, P3.4
unnamed: P1.9, P2.3
unnamed: P1.10, P3.5
unnamed: P1.11, P2.2
unnamed: P1.12, P3.6
unnamed: P1.13, P2.1
unnamed: P1.14, P3.7

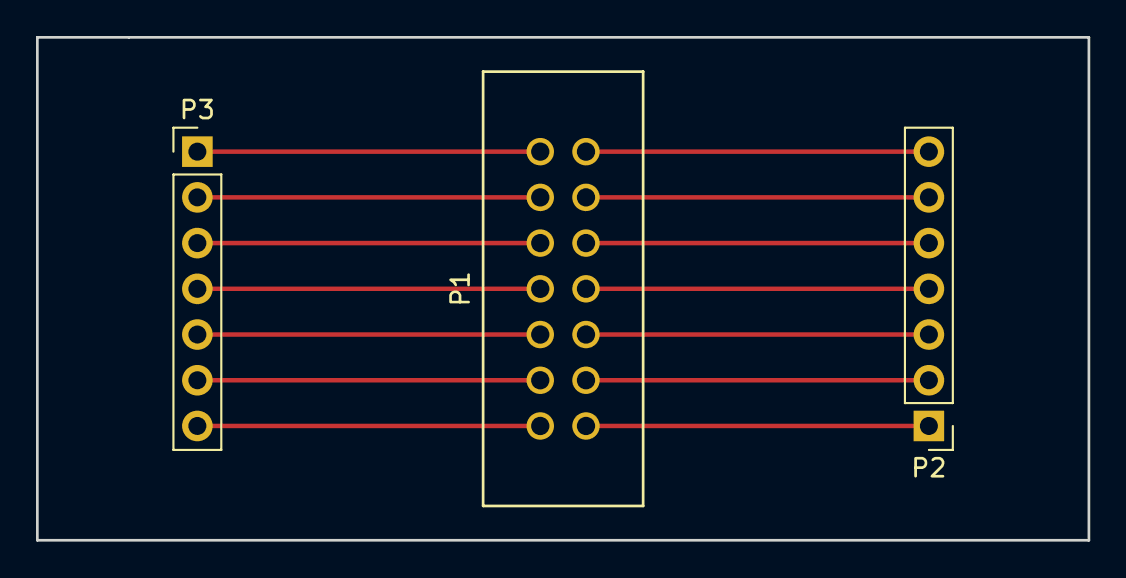
[picture p42: board Debug-Chip-001.kicad_pcb from above]

Board: 2 copper layers, 58.4 x 27.9 mm, 3 parts (0 on the bottom side), 14 nets.
