wayoffthecoast/reference-PDB-files/Vial Board/Vial_Board.kicad_pcb

## KiCad design Vial Board/Vial_Board.kicad_pcb (2021-12-21)

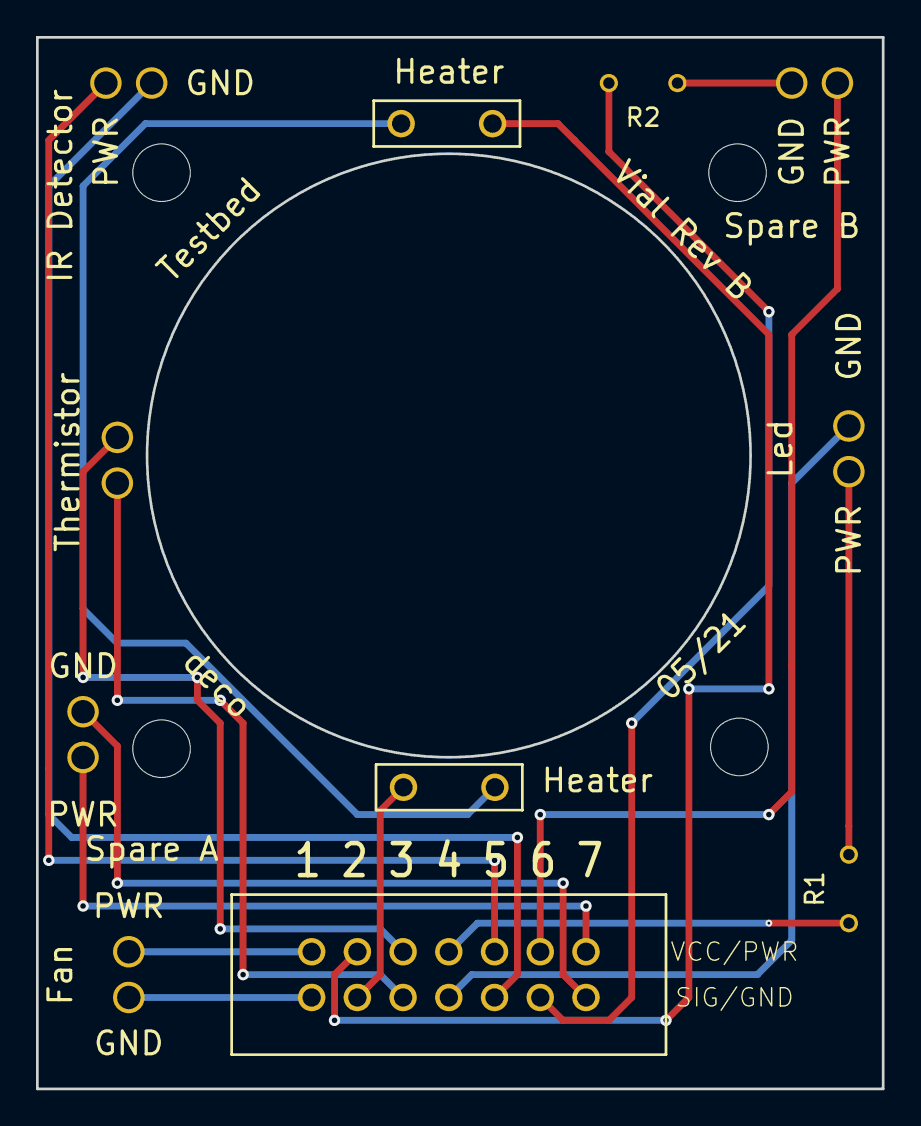
[picture p43: board Vial Board/Vial_Board.kicad_pcb from above]

Board: 2 copper layers, 47.0 x 58.4 mm, 11 parts (0 on the bottom side), 17 nets.

Parts:
P1: CONN_02X07; 2x7_pin_10in
P2: Fan; screw_terminal
P5: Thermistor
P6: Led; screw_terminal
P7: IR Detector; screw_terminal
P8: Spare B; screw_terminal
P9: Spare A; screw_terminal
R1: 435; Through_hole_R
R2: 750; Through_hole_R
R5: Heater 1; Heater
R6: Heater 2; Heater

Connections:
/FAN+: P1.13, P2.1
/FAN-: P1.14, P2.2
/HTR+: P1.11, R5.1
/HTR-: P1.12, R6.2
/LED+: P1.7, R1.1
/LED-: P1.8, P6.2
/PD+: P1.5, P7.1
/PD-: P1.6, P7.2
/SPA+: P1.1, P9.1
/SPA-: P1.2, P9.2
/SPB+: P1.3, P8.1
/SPB-: P1.4, R2.2
/TS+: P1.9, P5.1
/TS-: P1.10, P5.2
unnamed: P6.1, R1.2
unnamed: P8.2, R2.1
unnamed: R5.2, R6.1
