wayoffthecoast/reference-PDB-files/RS485/RS485.kicad_pcb

## KiCad design RS485/RS485.kicad_pcb (2021-12-21)

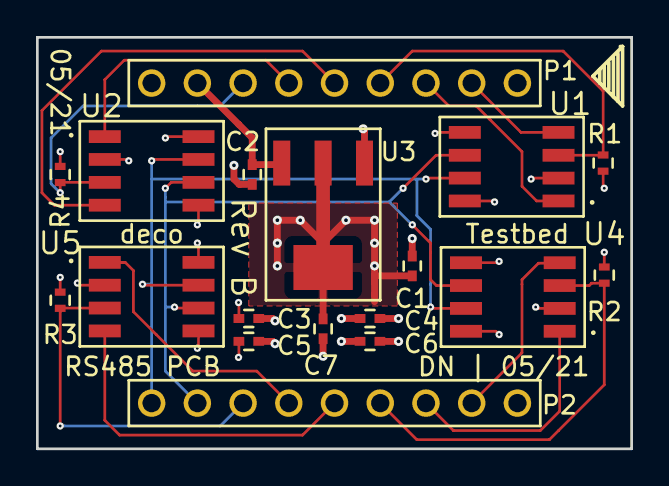
[picture p44: board RS485.kicad_pcb from above]

Board: 4 copper layers, 33.0 x 22.9 mm, 18 parts (0 on the bottom side), 17 nets.

Parts:
C1, C2: .1uF; C_0402
C3, C4, C5, C6, C7: C; C_0402
P1, P2: CONN_01X09; 9_pin_10in
R1, R2, R3, R4: 10k; R_0402
U1, U2, U4, U5: SP3485CN; SO-8
U3: TLV1117LV33DCYR

Connections:
+3V3: C1.1, C3.1, C4.1, C5.1, C6.1, C7.1, U1.8, U2.8, U3.2, U3.Tab, U4.8, U5.8
+5V: C2.1, P1.8, U3.3
GND: C1.2, C2.2, C3.2, C4.2, C5.2, C6.2, C7.2, P1.1, P1.9, P2.1, R1.2, R2.2, R3.2, R4.1, U1.2, U1.5, U2.2, U2.5, U3.1, U4.2, U4.5, U5.2, U5.5
unnamed: P1.2, U1.4
unnamed: P1.3, U1.1
unnamed: P1.4, R1.1, U1.3
unnamed: P1.5, U2.4
unnamed: P1.6, U2.1
unnamed: P1.7, R4.2, U2.3
unnamed: P2.2, U4.4
unnamed: P2.3, U4.1
unnamed: P2.4, R2.1, U4.3
unnamed: P2.5, U5.4
unnamed: P2.6, U5.1
unnamed: P2.7, R3.1, U5.3
unnamed: P2.8, U1.6, U2.6, U4.6, U5.6
unnamed: P2.9, U1.7, U2.7, U4.7, U5.7
