wayoffthecoast/reference-PDB-files/AUX/Auxiliary_Board.kicad_pcb

## KiCad design AUX/Auxiliary_Board.kicad_pcb (2021-12-21)

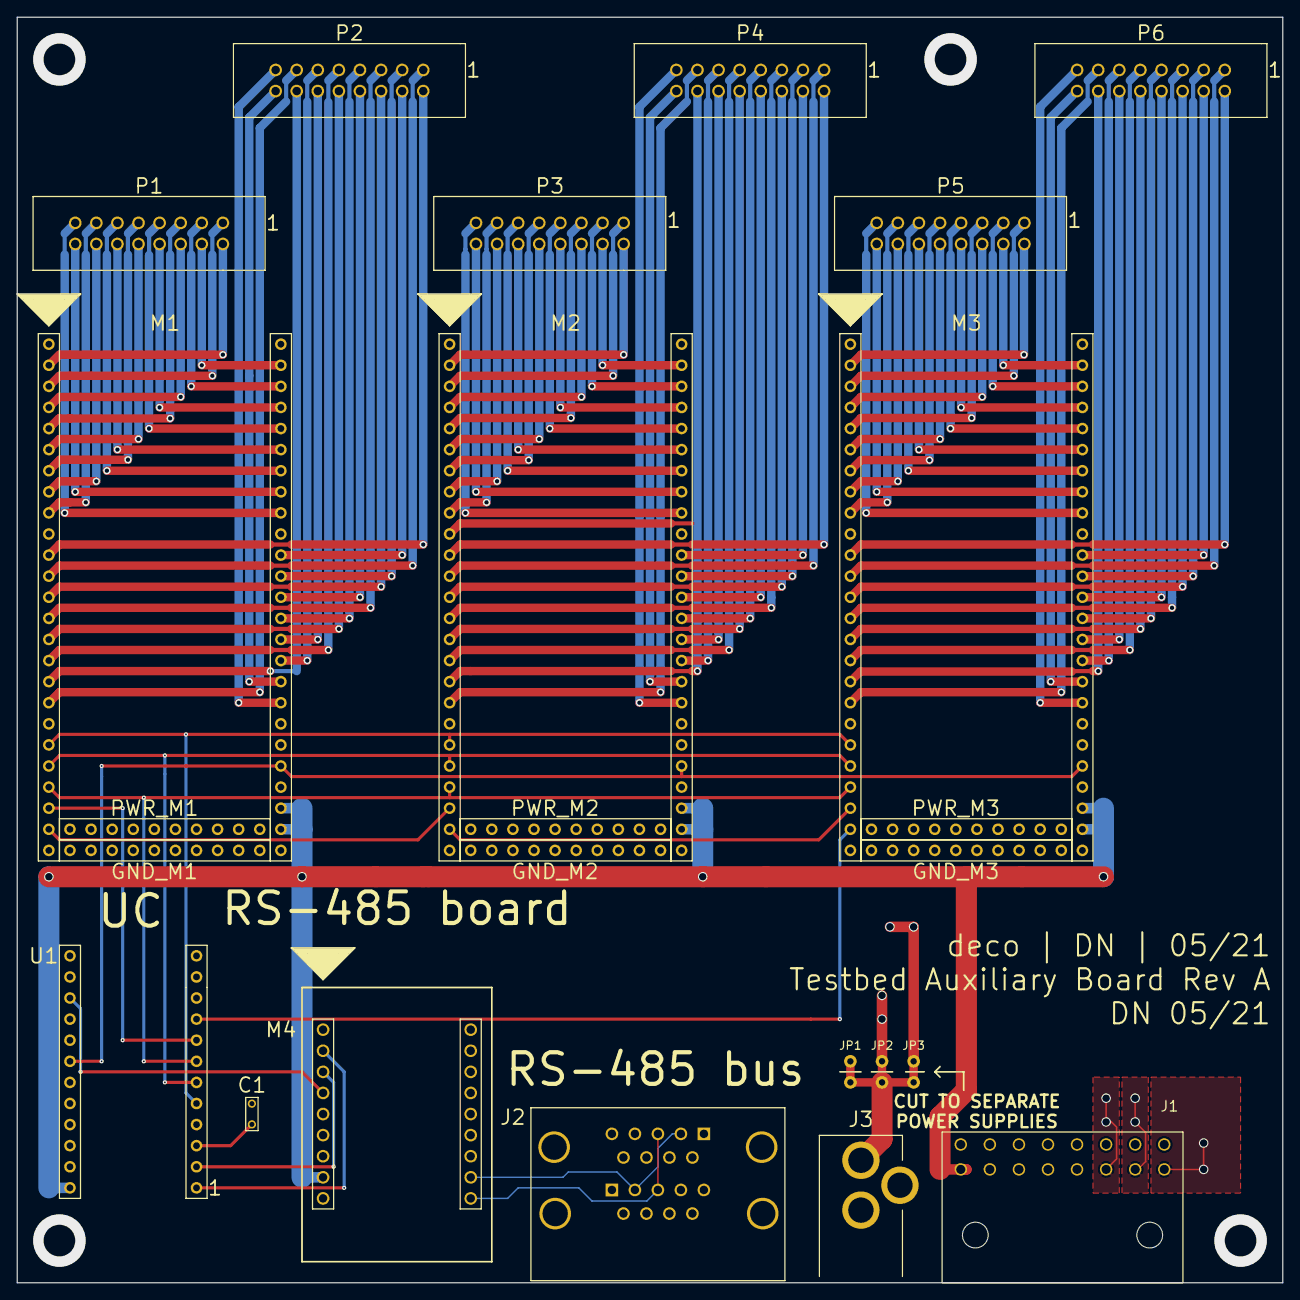
[picture p45: board Auxiliary_Board.kicad_pcb from above]

Board: 4 copper layers, 152.4 x 152.4 mm, 24 parts (0 on the bottom side), 116 nets.

Parts:
C1: 10 uF; FK18X5R0J105K
GND_M1, GND_M2, GND_M3: CONN_01X10; 10pin_tenth_in
J1: CONN_01X16; 1723162216
J2: 2xDB9; DB9FC
J3: CONN_01X03; 2.1mm_DC_Jack
JP1, JP2, JP3: JUMPER; JPR_SHORT
M1, M2, M3: CONN_02X25; 50_pin_10in
M4: CONN_02X09; 2x_9_pin_10in
P1, P2, P3, P4, P5, P6: CONN_02X08; 2x8_conn_10in
PWR_M1, PWR_M2, PWR_M3: CONN_01X10; 10pin_tenth_in
U1: CONN_02X12; 24_pin_10in

Connections:
+5V: J1.15, M1.46, M1.48, M2.46, M2.48, M3.46, M3.48, M4.15, U1.2
+24V: J3.1, JP1.1, JP2.1, JP3.1
/A: J2.2, J2.11, M4.16
/B: J2.3, J2.12, M4.18
/BLANK: M1.42, M2.42, M3.42, U1.14
/GSCLK: M1.39, M2.39, M3.39, U1.9
/M1_SOUT: M1.47, M2.45
/M2_SOUT: M2.47, M3.45
/M3_SOUT: M3.47, U1.17
/PUMP+00: M1.5, P1.1
/PUMP+01: M1.6, P1.3
/PUMP+02: M1.9, P1.5
/PUMP+03: M1.10, P1.7
/PUMP+04: M1.13, P1.9
/PUMP+05: M1.14, P1.11
/PUMP+06: M1.17, P1.13
/PUMP+07: M1.18, P1.15
/PUMP+08: M1.23, P2.1
/PUMP+09: M1.24, P2.3
/PUMP+10: M1.27, P2.5
/PUMP+11: M1.28, P2.7
/PUMP+12: M1.31, P2.9
/PUMP+13: M1.32, P2.11
/PUMP+14: M1.35, P2.13
/PUMP+15: M1.36, P2.15
/PUMP+16: M2.5, P3.1
/PUMP+17: M2.6, P3.3
/PUMP+18: M2.9, P3.5
/PUMP+19: M2.10, P3.7
/PUMP+20: M2.13, P3.9
/PUMP+21: M2.14, P3.11
/PUMP+22: M2.17, P3.13
/PUMP+23: M2.18, P3.15
/PUMP+24: M2.23, P4.1
/PUMP+25: M2.24, P4.3
/PUMP+26: M2.27, P4.5
/PUMP+27: M2.28, P4.7
/PUMP+28: M2.31, P4.9
/PUMP+29: M2.32, P4.11
/PUMP+30: M2.35, P4.13
/PUMP+31: M2.36, P4.15
/PUMP+32: M3.5, P5.1
/PUMP+33: M3.6, P5.3
/PUMP+34: M3.9, P5.5
/PUMP+35: M3.10, P5.7
/PUMP+36: M3.13, P5.9
/PUMP+37: M3.14, P5.11
/PUMP+38: M3.17, P5.13
/PUMP+39: M3.18, P5.15
/PUMP+40: M3.23, P6.1
/PUMP+41: M3.24, P6.3
/PUMP+42: M3.27, P6.5
/PUMP+43: M3.28, P6.7
/PUMP+44: M3.31, P6.9
/PUMP+45: M3.32, P6.11
/PUMP+46: M3.35, P6.13
/PUMP+47: M3.36, P6.15
/PUMP-00: M1.3, P1.2
/PUMP-01: M1.4, P1.4
/PUMP-02: M1.7, P1.6
/PUMP-03: M1.8, P1.8
/PUMP-04: M1.11, P1.10
/PUMP-05: M1.12, P1.12
/PUMP-06: M1.15, P1.14
/PUMP-07: M1.16, P1.16
/PUMP-08: M1.21, P2.2
/PUMP-09: M1.22, P2.4
/PUMP-10: M1.25, P2.6
/PUMP-11: M1.26, P2.8
/PUMP-12: M1.29, P2.10
/PUMP-13: M1.30, P2.12
/PUMP-14: M1.33, P2.14
/PUMP-15: M1.34, P2.16
/PUMP-16: M2.3, P3.2
/PUMP-17: M2.4, P3.4
/PUMP-18: M2.7, P3.6
/PUMP-19: M2.8, P3.8
/PUMP-20: M2.11, P3.10
/PUMP-21: M2.12, P3.12
/PUMP-22: M2.15, P3.14
/PUMP-23: M2.16, P3.16
/PUMP-24: M2.21, P4.2
/PUMP-25: M2.22, P4.4
/PUMP-26: M2.25, P4.6
/PUMP-27: M2.26, P4.8
/PUMP-28: M2.29, P4.10
/PUMP-29: M2.30, P4.12
/PUMP-30: M2.33, P4.14
/PUMP-31: M2.34, P4.16
/PUMP-32: M3.3, P5.2
/PUMP-33: M3.4, P5.4
/PUMP-34: M3.7, P5.6
/PUMP-35: M3.8, P5.8
/PUMP-36: M3.11, P5.10
/PUMP-37: M3.12, P5.12
/PUMP-38: M3.15, P5.14
/PUMP-39: M3.16, P5.16
/PUMP-40: M3.21, P6.2
/PUMP-41: M3.22, P6.4
/PUMP-42: M3.25, P6.6
/PUMP-43: M3.26, P6.8
/PUMP-44: M3.29, P6.10
/PUMP-45: M3.30, P6.12
/PUMP-46: M3.33, P6.14
/PUMP-47: M3.34, P6.16
/PWR1: J1.5, JP1.2, PWR_M1.1, PWR_M1.2, PWR_M1.3, PWR_M1.4, PWR_M1.5, PWR_M1.6, PWR_M1.7, PWR_M1.8, PWR_M1.9, PWR_M1.10
/PWR2: J1.3, JP2.2, PWR_M2.1, PWR_M2.2, PWR_M2.3, PWR_M2.4, PWR_M2.5, PWR_M2.6, PWR_M2.7, PWR_M2.8, PWR_M2.9, PWR_M2.10
/PWR3: J1.1, JP3.2, PWR_M3.1, PWR_M3.2, PWR_M3.3, PWR_M3.4, PWR_M3.5, PWR_M3.6, PWR_M3.7, PWR_M3.8, PWR_M3.9, PWR_M3.10
/SCLK: M1.43, M2.43, M3.43, U1.13
/SIN: M1.45, U1.15
/UC_D12: M4.7, U1.20
/UC_NRST: C1.1, U1.5
/UC_RX: M4.5, U1.3
/UC_TX: M4.3, U1.1
/XLAT: M1.41, M2.41, M3.41, U1.11
GND: C1.2, GND_M1.1, GND_M1.2, GND_M1.3, GND_M1.4, GND_M1.5, GND_M1.6, GND_M1.7, GND_M1.8, GND_M1.9, GND_M1.10, GND_M2.1, GND_M2.2, GND_M2.3, GND_M2.4, GND_M2.5, GND_M2.6, GND_M2.7, GND_M2.8, GND_M2.9, GND_M2.10, GND_M3.1, GND_M3.2, GND_M3.3, GND_M3.4, GND_M3.5, GND_M3.6, GND_M3.7, GND_M3.8, GND_M3.9, GND_M3.10, J1.2, J1.4, J1.6, J1.8, J1.10, J1.12, J1.14, J1.16, J2.5, J2.10, J3.2, J3.3, M1.1, M1.2, M1.19, M1.20, M1.37, M1.38, M1.49, M1.50, M2.1, M2.2, M2.19, M2.20, M2.37, M2.38, M2.49, M2.50, M3.1, M3.2, M3.19, M3.20, M3.37, M3.38, M3.49, M3.50, M4.1, M4.2, M4.17, U1.4, U1.7
