wayoffthecoast/reference-PDB-files/ADC/ADC.kicad_pcb

## KiCad design ADC/ADC.kicad_pcb (2021-12-21)

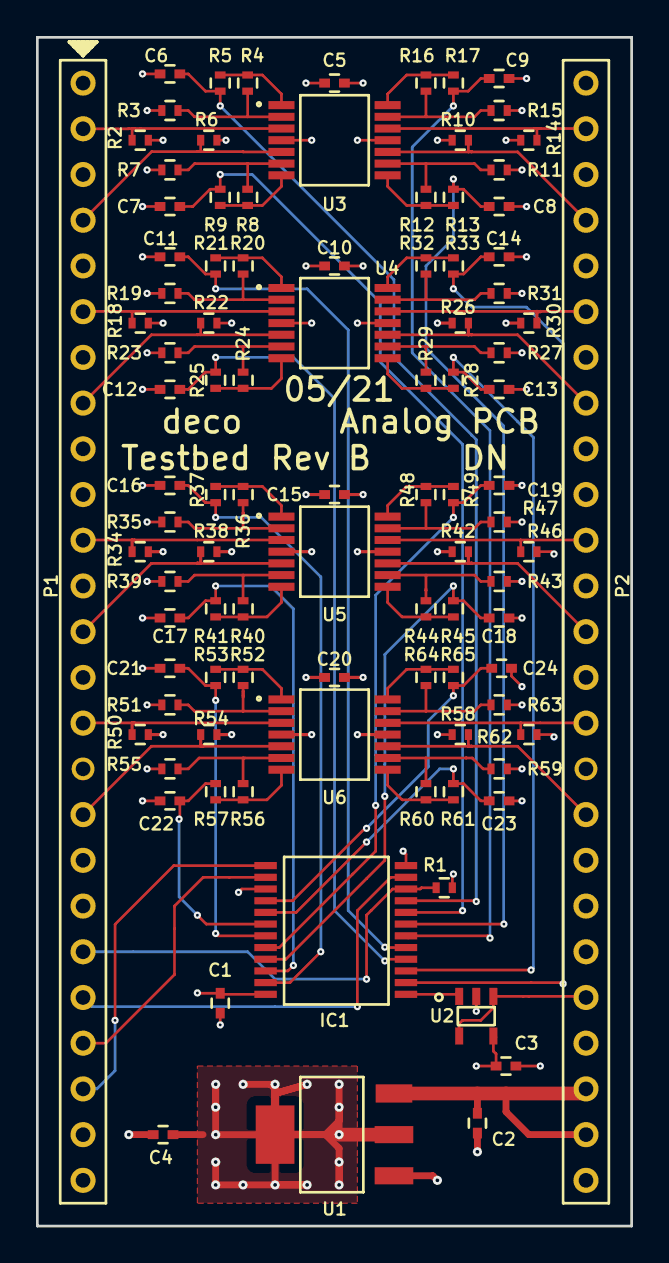
[picture p46: board ADC.kicad_pcb from above]

Board: 4 copper layers, 33.0 x 66.0 mm, 98 parts (0 on the bottom side), 73 nets.

Parts:
C1, C2, C3, C4, C5, C6, C7, C8, C9, C10, C11, C12, C13, C14, C15, C16, C17, C18, C19, C20, C21, C22, C23, C24: .1uF; C_0402
IC1: 74HC4067; 74HC_HTC4067
P1, P2: CONNX25; 25_pin_10in
R1, R4, R5, R8, R9, R12, R13, R16, R17, R20, R21, R24, R25, R28, R29, R32, R33, R36, R37, R40, R41, R44, R45, R48, R49, R52, R53, R56, R57, R60, R61, R64, R65: 10k; R_0402
R2, R3, R6, R7, R10, R11, R14, R15, R18, R19, R22, R23, R26, R27, R30, R31, R34, R35, R38, R39, R42, R43, R46, R47, R50, R51, R54, R55, R58, R59, R62, R63: OMIT; R_0402
U1: TLV1117LV33DCYR; TLV1117
U2: MCP6001
U3, U4, U5, U6: MCP6004

Connections:
+3V3: C1.1, C3.1, C4.1, C5.1, C10.1, C15.1, C20.1, IC1.24, P2.20, U1.2, U1.4, U2.5, U3.4, U4.4, U5.4, U6.4
+5V: C2.1, P2.23, P2.24, U1.3
/MCP6004_1/OPOUT1: C6.1, IC1.9, R5.2
/MCP6004_1/OPOUT2: C7.1, IC1.8, R9.2
/MCP6004_1/OPOUT3: C8.1, IC1.7, R13.2
/MCP6004_1/OPOUT4: C9.1, IC1.6, R17.2
/MCP6004_2/OPOUT1: C11.1, IC1.5, R21.2
/MCP6004_2/OPOUT2: C12.1, IC1.4, R25.2
/MCP6004_2/OPOUT3: C13.1, IC1.3, R29.2
/MCP6004_2/OPOUT4: C14.1, IC1.2, R33.2
/MCP6004_3/OPOUT1: C16.1, IC1.23, R37.2
/MCP6004_3/OPOUT2: C17.1, IC1.22, R41.2
/MCP6004_3/OPOUT3: C18.1, IC1.21, R45.2
/MCP6004_3/OPOUT4: C19.1, IC1.20, R49.2
/MCP6004_4/OPOUT1: C21.1, IC1.19, R53.2
/MCP6004_4/OPOUT2: C22.1, IC1.18, R57.2
/MCP6004_4/OPOUT3: C23.1, IC1.17, R61.2
/MCP6004_4/OPOUT4: C24.1, IC1.16, R65.2
/M_0: IC1.10, P1.20, R1.2
/M_1: IC1.11, P1.21
/M_2: IC1.14, P1.22
/M_3: IC1.13, P1.23
/M_OUT: P2.21, U2.1, U2.4
/OPIN_1: P1.2, R2.2, U3.3
/OPIN_2: P1.4, R6.2, U3.5
/OPIN_3: P2.4, R10.2, U3.10
/OPIN_4: P2.2, R14.2, U3.12
/OPIN_5: P1.6, R18.2, U4.3
/OPIN_6: P1.8, R22.2, U4.5
/OPIN_7: P2.8, R26.2, U4.10
/OPIN_8: P2.6, R30.2, U4.12
/OPIN_9: P1.11, R34.2, U5.3
/OPIN_10: P1.13, R38.2, U5.5
/OPIN_11: P2.13, R42.2, U5.10
/OPIN_12: P2.11, R46.2, U5.12
/OPIN_13: P1.15, R50.2, U6.3
/OPIN_14: P1.17, R54.2, U6.5
/OPIN_15: P2.17, R58.2, U6.10
/OPIN_16: P2.15, R62.2, U6.12
GND: C1.2, C2.2, C3.2, C4.2, C5.2, C6.2, C7.2, C8.2, C9.2, C10.2, C11.2, C12.2, C13.2, C14.2, C15.2, C16.2, C17.2, C18.2, C19.2, C20.2, C21.2, C22.2, C23.2, C24.2, IC1.12, IC1.15, P1.1, P1.3, P1.5, P1.7, P1.9, P1.10, P1.12, P1.14, P1.16, P1.18, P1.19, P1.25, P2.1, P2.3, P2.5, P2.7, P2.9, P2.10, P2.12, P2.14, P2.16, P2.18, P2.19, P2.25, R1.1, R2.1, R3.2, R6.1, R7.1, R10.1, R11.1, R14.1, R15.1, R18.1, R19.2, R22.1, R23.1, R26.1, R27.1, R30.1, R31.1, R34.1, R35.2, R38.1, R39.1, R42.1, R43.1, R46.1, R47.1, R50.1, R51.2, R54.1, R55.1, R58.1, R59.1, R62.1, R63.1, U1.1, U2.2, U3.11, U4.11, U5.11, U6.11
unnamed: IC1.1, U2.3
unnamed: R3.1, R4.1, U3.2
unnamed: R4.2, R5.1, U3.1
unnamed: R7.2, R8.1, U3.6
unnamed: R8.2, R9.1, U3.7
unnamed: R11.2, R12.1, U3.9
unnamed: R12.2, R13.1, U3.8
unnamed: R15.2, R16.1, U3.13
unnamed: R16.2, R17.1, U3.14
unnamed: R19.1, R20.1, U4.2
unnamed: R20.2, R21.1, U4.1
unnamed: R23.2, R24.1, U4.6
unnamed: R24.2, R25.1, U4.7
unnamed: R27.2, R28.1, U4.9
unnamed: R28.2, R29.1, U4.8
unnamed: R31.2, R32.1, U4.13
unnamed: R32.2, R33.1, U4.14
unnamed: R35.1, R36.1, U5.2
unnamed: R36.2, R37.1, U5.1
unnamed: R39.2, R40.1, U5.6
unnamed: R40.2, R41.1, U5.7
unnamed: R43.2, R44.1, U5.9
unnamed: R44.2, R45.1, U5.8
unnamed: R47.2, R48.1, U5.13
unnamed: R48.2, R49.1, U5.14
unnamed: R51.1, R52.1, U6.2
unnamed: R52.2, R53.1, U6.1
unnamed: R55.2, R56.1, U6.6
unnamed: R56.2, R57.1, U6.7
unnamed: R59.2, R60.1, U6.9
unnamed: R60.2, R61.1, U6.8
unnamed: R63.2, R64.1, U6.13
unnamed: R64.2, R65.1, U6.14
