wayoffthecoast/reference-PDB-files/PWM/pwm.kicad_pcb

## KiCad design PWM/pwm.kicad_pcb (2021-12-21)

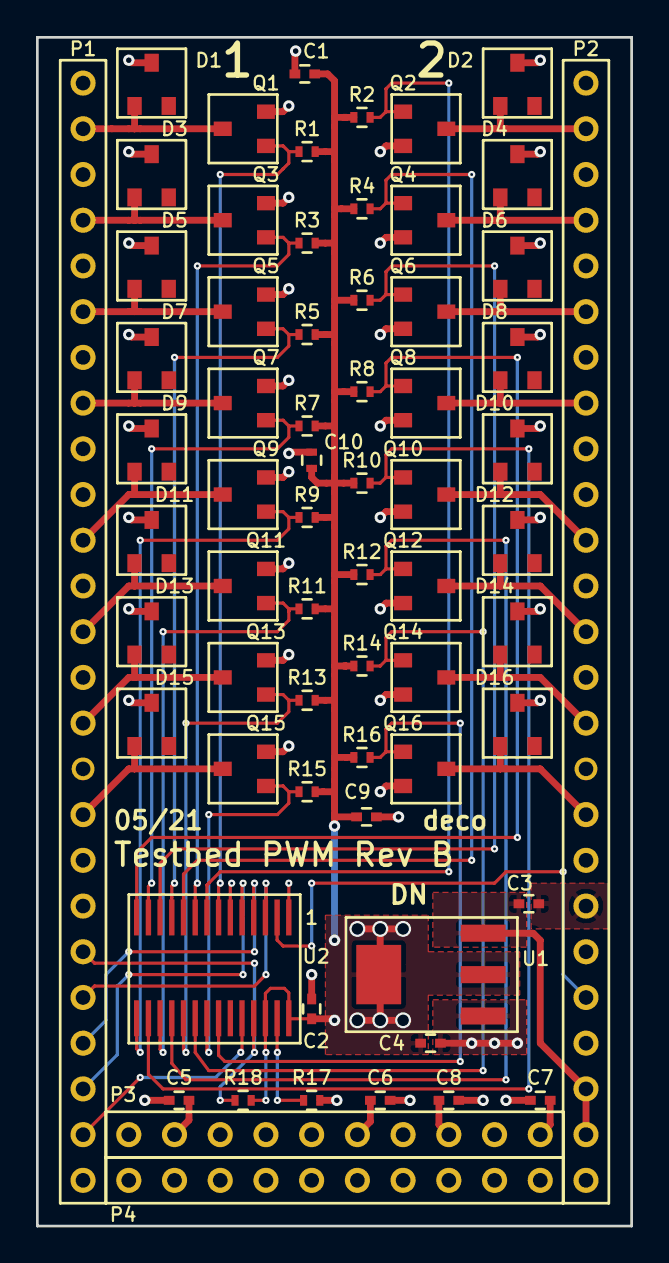
[picture p47: board pwm.kicad_pcb from above]

Board: 4 copper layers, 33.0 x 66.0 mm, 66 parts (0 on the bottom side), 43 nets.

Parts:
C1, C2, C5, C6, C7, C8, C9: 0.1uF; C_0402
C3, C4: 1uF; C_0402
C10: 0.1uF; R_0402
D1, D2, D3, D4, D5, D6, D7, D8, D9, D10, D11, D12, D13, D14, D15, D16: ZHCS506TA
P1: CONN_01X25_1; 25_pin_10in
P2: CONN_01X25_2; 25_pin_10in
P3, P4: CONN_01X10; 10pin_tenth_in
Q1, Q2, Q3, Q4, Q5, Q6, Q7, Q8, Q9, Q10, Q11, Q12, Q13, Q14, Q15, Q16: AO3422
R1, R2, R3, R4, R5, R6, R7, R8, R9, R10, R11, R12, R13, R14, R15, R16, R18: 10K; R_0402
R17: 2.2k; R_0402
U1: TLV1117LV33DCYR
U2: TLC5940PWP

Connections:
+3V3: C1.1, C2.1, C4.1, C9.1, C10.1, R1.1, R2.1, R3.1, R4.1, R5.1, R6.1, R7.1, R8.1, R9.1, R10.1, R11.1, R12.1, R13.1, R14.1, R15.1, R16.1, R18.1, U1.2, U1.Tab, U2.26, U2.28
+5V: C3.1, P2.23, P2.24, U1.3
+24V: C5.1, C6.1, C7.1, C8.1, D1.1, D2.1, D3.1, D4.1, D5.1, D6.1, D7.1, D8.1, D9.1, D10.1, D11.1, D12.1, D13.1, D14.1, D15.1, D16.1, P1.3, P1.5, P1.7, P1.9, P1.12, P1.14, P1.16, P1.18, P2.3, P2.5, P2.7, P2.9, P2.12, P2.14, P2.16, P2.18, P3.1, P3.2, P3.3, P3.4, P3.5, P3.6, P3.7, P3.8, P3.9, P3.10
/BLANK: P2.21, U2.2
/GATE0: Q1.1, R1.2, U2.7
/GATE1: Q2.1, R2.2, U2.8
/GATE2: Q3.1, R3.2, U2.9
/GATE3: Q4.1, R4.2, U2.10
/GATE4: Q5.1, R5.2, U2.11
/GATE5: Q6.1, R6.2, U2.12
/GATE6: Q7.1, R7.2, U2.13
/GATE7: Q8.1, R8.2, U2.14
/GATE8: Q9.1, R9.2, U2.15
/GATE9: Q10.1, R10.2, U2.16
/GATE10: Q11.1, R11.2, U2.17
/GATE11: Q12.1, R12.2, U2.18
/GATE12: Q13.1, R13.2, U2.19
/GATE13: Q14.1, R14.2, U2.20
/GATE14: Q15.1, R15.2, U2.21
/GATE15: Q16.1, R16.2, U2.22
/GSCLK: P1.20, R18.2, U2.25
/OUT_0: D1.3, P1.2, Q1.3
/OUT_1: D2.3, P2.2, Q2.3
/OUT_2: D3.3, P1.4, Q3.3
/OUT_3: D4.3, P2.4, Q4.3
/OUT_4: D5.3, P1.6, Q5.3
/OUT_5: D6.3, P2.6, Q6.3
/OUT_6: D7.3, P1.8, Q7.3
/OUT_7: D8.3, P2.8, Q8.3
/OUT_8: D9.3, P1.11, Q9.3
/OUT_9: D10.3, P2.11, Q10.3
/OUT_10: D11.3, P1.13, Q11.3
/OUT_11: D12.3, P2.13, Q12.3
/OUT_12: D13.3, P1.15, Q13.3
/OUT_13: D14.3, P2.15, Q14.3
/OUT_14: D15.3, P1.17, Q15.3
/OUT_15: D16.3, P2.17, Q16.3
/SCLK: P1.22, U2.4
/SIN: P1.23, U2.5
/SOUT: P1.24, U2.24
/XLAT: P1.21, U2.3
GND: C1.2, C2.2, C3.2, C4.2, C5.2, C6.2, C7.2, C8.2, C9.2, C10.2, P1.1, P1.10, P1.19, P1.25, P2.1, P2.10, P2.19, P2.25, P4.1, P4.2, P4.3, P4.4, P4.5, P4.6, P4.7, P4.8, P4.9, P4.10, Q1.2, Q2.2, Q3.2, Q4.2, Q5.2, Q6.2, Q7.2, Q8.2, Q9.2, Q10.2, Q11.2, Q12.2, Q13.2, Q14.2, Q15.2, Q16.2, R17.2, U1.1, U2.1, U2.6
unnamed: R17.1, U2.27
