wayoffthecoast/reference-PDB-files/flow-rate-aux-board/v2v_flow_emitter/flow_rate/flow_rate.kicad_pcb

## KiCad design flow-rate-aux-board/v2v_flow_emitter/flow_rate/flow_rate.kicad_pcb (2021-12-21)

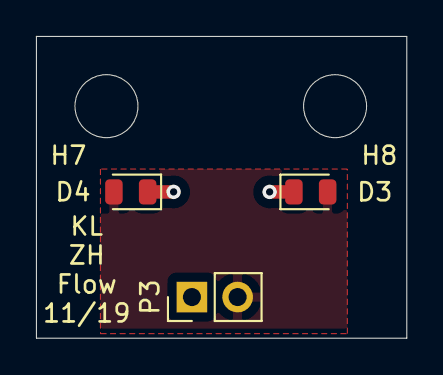
[picture p52: board flow-rate-aux-board/v2v_flow_emitter/flow_rate/flow_rate.kicad_pcb from above]

Board: 2 copper layers, 20.6 x 16.8 mm, 5 parts (0 on the bottom side), 2 nets.

Parts:
D3, D4: D; D_0805_2012Metric
H7, H8: MountingHole; MountingHole_3.5mm
P3: CONN_01X02; PinHeader_1x02_P2.54mm_Vertical

Connections:
/LED_GND: D3.1, D4.1, P3.1
/LED_PWR: D3.2, D4.2, P3.2
