wayoffthecoast/reference-PDB-files/flow-rate-aux-board/flow_rate/flow_rate.kicad_pcb

## KiCad design flow-rate-aux-board/flow_rate/flow_rate.kicad_pcb (2021-12-21)

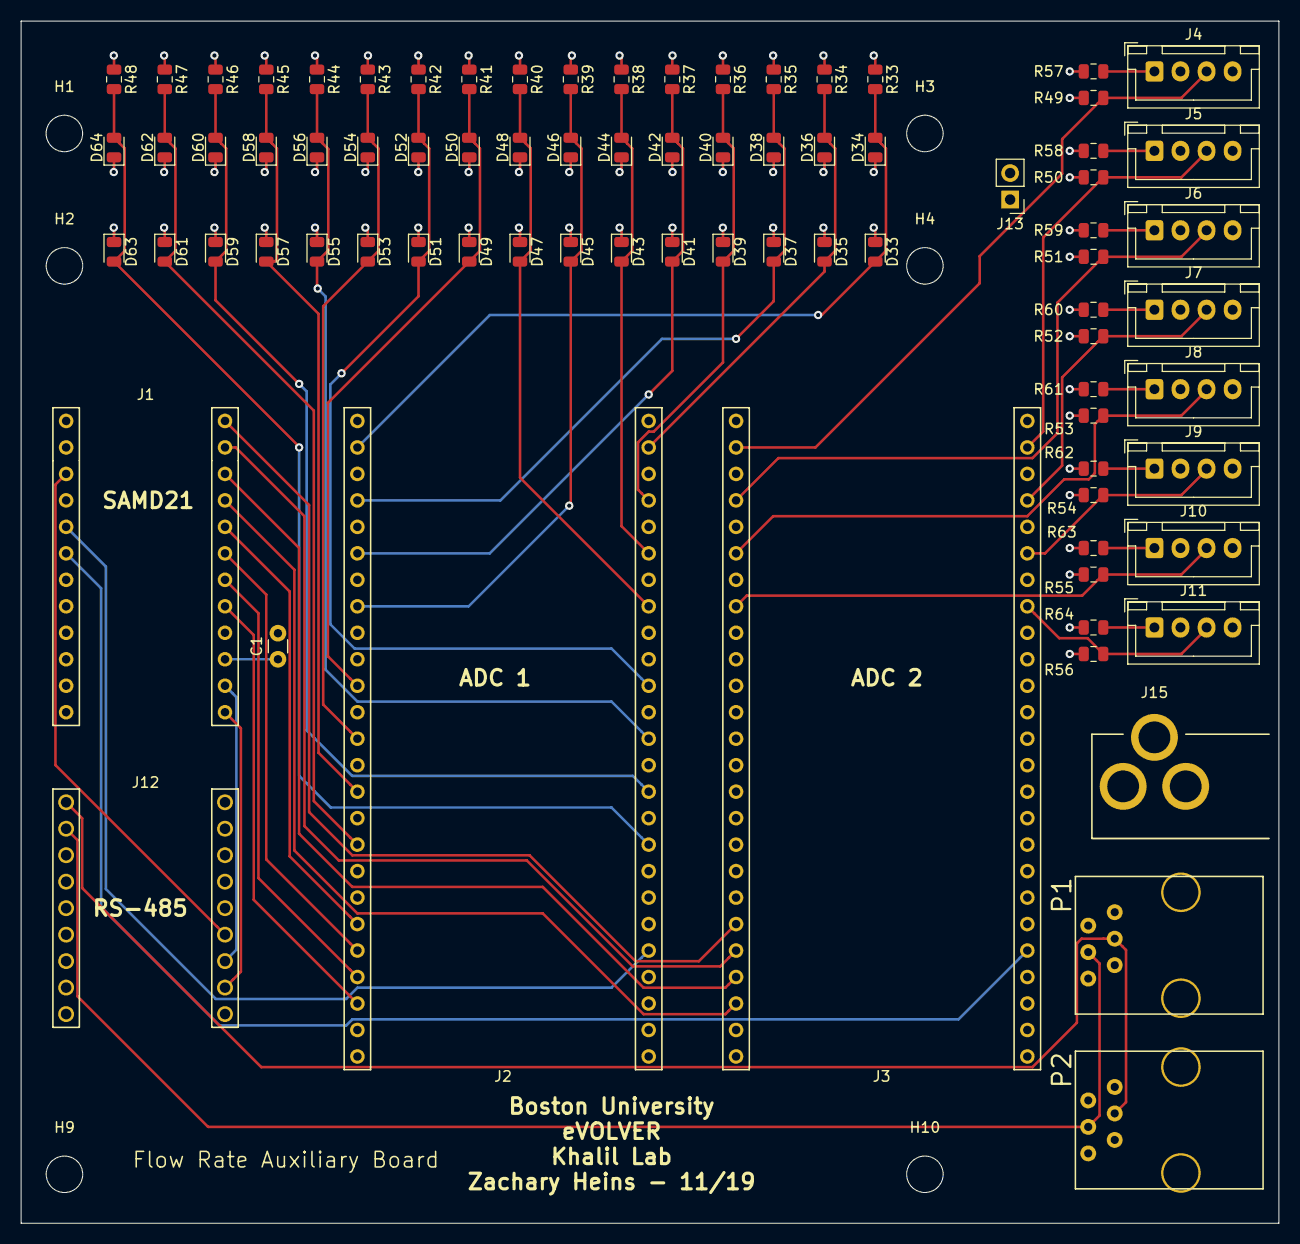
[picture p53: board flow-rate-aux-board/flow_rate/flow_rate.kicad_pcb from above]

Board: 4 copper layers, 120.6 x 115.3 mm, 87 parts (0 on the bottom side), 52 nets.

Parts:
C1: 10u; C_Disc_D3.0mm_W1.6mm_P2.50mm
D33, D34, D35, D36, D37, D38, D39, D40, D41, D42, D43, D44, D45, D46, D47, D48, D49, D50, D51, D52, D53, D54, D55, D56, D57, D58, D59, D60, D61, D62, D63, D64: D; D_0805_2012Metric
H1, H2, H3, H4, H9, H10: MountingHole; MountingHole_3.5mm
J1: Conn_02x12_Odd_Even; 24_pin_10in
J2, J3: Conn_02x25_Odd_Even; 50_pin_10in
J4, J5, J6, J7, J8, J9, J10, J11: Conn_01x04; JST_XH_B4B-XH-A_1x04_P2.50mm_Vertical
J12: Conn_02x09_Odd_Even; 2x_9_pin_10in
J13: Conn_01x02; PinHeader_1x02_P2.54mm_Vertical
J15: Barrel_Jack; 2.1mm_DC_Jack
P1, P2: RJ14
R33, R34, R35, R36, R37, R38, R39, R40, R41, R42, R43, R44, R45, R46, R47, R48, R49, R50, R51, R52, R53, R54, R55, R56: 2.2k; R_0805_2012Metric
R57, R58, R59, R60, R61, R62, R63, R64: 100; R_0805_2012Metric

Connections:
+5V: J1.2, J2.46, J2.48, J3.46, J3.48, J12.15, J13.1, J15.1, R57.2, R58.2, R59.2, R60.2, R61.2, R62.2, R63.2, R64.2
/3.3V_ONBOARD: D33.1, D34.1, D35.1, D36.1, D37.1, D38.1, D39.1, D40.1, D41.1, D42.1, D43.1, D44.1, D45.1, D46.1, D47.1, D48.1, D49.1, D50.1, D51.1, D52.1, D53.1, D54.1, D55.1, D56.1, D57.1, D58.1, D59.1, D60.1, D61.1, D62.1, D63.1, D64.1, J2.40
/3.3V_V2V: J3.40, J4.2, J5.2, J6.2, J7.2, J8.2, J9.2, J10.2, J11.2
/A: J12.16, P1.3, P2.3
/A0: J1.16, J2.42
/A1: J1.14, J3.42
/B: J12.18, P1.4, P2.4
/CH0: D33.2, D34.2, J2.3, R33.2
/CH1: D35.2, D36.2, J2.4, R34.2
/CH2: D37.2, D38.2, J2.7, R35.2
/CH3: D39.2, D40.2, J2.8, R36.2
/CH4: D41.2, D42.2, J2.11, R37.2
/CH5: D43.2, D44.2, J2.12, R38.2
/CH6: D45.2, D46.2, J2.15, R39.2
/CH7: D47.2, D48.2, J2.16, R40.2
/CH8: D49.2, D50.2, J2.21, R41.2
/CH9: D51.2, D52.2, J2.22, R42.2
/CH10: D53.2, D54.2, J2.25, R43.2
/CH11: D55.2, D56.2, J2.26, R44.2
/CH12: D57.2, D58.2, J2.29, R45.2
/CH13: D59.2, D60.2, J2.30, R46.2
/CH14: D61.2, D62.2, J2.33, R47.2
/CH15: D63.2, D64.2, J2.34, R48.2
/S0: J1.15, J2.39
/S1: J1.13, J2.41
/S2: J1.11, J2.43
/S3: J1.9, J2.45
/UC_D12: J1.20, J12.7
/UC_RX: J1.3, J12.5
/UC_TX: J1.1, J12.3
/V2V_0: J3.3, J4.3, R49.2
/V2V_1: J3.4, J5.3, R50.2
/V2V_2: J3.7, J6.3, R51.2
/V2V_3: J3.8, J7.3, R52.2
/V2V_4: J3.11, J8.3, R53.2
/V2V_5: J3.12, J9.3, R54.2
/V2V_6: J3.15, J10.3, R55.2
/V2V_7: J3.16, J11.3, R56.2
/v2v_0: J1.23, J3.39
/v2v_1: J1.21, J3.41
/v2v_2: J1.19, J3.43
/v2v_3: J1.17, J3.45
GND: C1.2, J1.4, J1.7, J2.1, J2.2, J2.5, J2.6, J2.9, J2.10, J2.13, J2.14, J2.17, J2.18, J2.19, J2.20, J2.23, J2.24, J2.27, J2.28, J2.31, J2.32, J2.35, J2.36, J2.37, J2.38, J2.49, J2.50, J3.1, J3.2, J3.5, J3.6, J3.9, J3.10, J3.13, J3.14, J3.17, J3.18, J3.19, J3.20, J3.23, J3.24, J3.27, J3.28, J3.31, J3.32, J3.35, J3.36, J3.37, J3.38, J3.49, J3.50, J4.4, J5.4, J6.4, J7.4, J8.4, J9.4, J10.4, J11.4, J12.1, J12.2, J12.17, J13.2, J15.2, P1.2, P1.5, P2.2, P2.5, R33.1, R34.1, R35.1, R36.1, R37.1, R38.1, R39.1, R40.1, R41.1, R42.1, R43.1, R44.1, R45.1, R46.1, R47.1, R48.1, R49.1, R50.1, R51.1, R52.1, R53.1, R54.1, R55.1, R56.1
unnamed: C1.1, J1.5
unnamed: J4.1, R57.1
unnamed: J5.1, R58.1
unnamed: J6.1, R59.1
unnamed: J7.1, R60.1
unnamed: J8.1, R61.1
unnamed: J9.1, R62.1
unnamed: J10.1, R63.1
unnamed: J11.1, R64.1
