wayoffthecoast/reference-PDB-files/hardware-master/temp-cal/temperature board.kicad_pcb

## KiCad design hardware-master/temp-cal/temperature board.kicad_pcb (2021-12-21)

Schematic: temperature board.sch

Parts:
C1, C3, C4: C; C_Radial_D4.0mm_H5.0mm_P1.50mm
C2: 1uF; C_Radial_D4.0mm_H5.0mm_P1.50mm
J1: Barrel_Jack; barreljack
J2, J3, J4, J5, J6, J7, J8, J9, J12, J13, J14, J15, J16, J17, J18, J19: Conn_01x02; JSTHeader
J10: Connector_Generic_Conn_02x25_Row_Letter_Last; ADCBoard
J11: Conn_01x04; ethernet cable jack
J20: Conn_02x12_Counter_Clockwise; arduinoChip
J21: Conn_02x09_Odd_Even; RS485
J22: DualDSub; dualDSub9Connector
U1, U2: 9_R_01x10; resistorPackx10

Connections:
+3V3: C3.1, C4.1, J10.45, U1.1, U2.1
+5V: C1.2, J1.1, J10.48, J10.49, J20.24, J21.15
/RJ11_A: J11.2, J21.16, J22.4, J22.13
/RJ11_B: J11.4, J21.18, J22.3, J22.12
/arduA0: J10.46, J20.17
/arduA1: J20.18
/arduA2: J20.19
/arduA3: J20.20
/arduD7: J10.20, J20.10
/arduD8: J10.21, J20.11
/arduD9: J10.22, J20.12
/arduD10: J10.23, J20.13
/arduD11: J10.24, J20.14
/arduD12: J20.15, J21.7
/arduD13: J20.16
/arduRX: J20.2, J21.5
/arduReset: C2.1, J20.3
/arduTX: J20.1, J21.3
/res1: J10.27, J12.1, U2.2
/res2: J10.29, J13.1, U2.3
/res3: J10.31, J14.1, U2.4
/res4: J10.33, J15.1, U2.5
/res5: J10.36, J16.1, U2.6
/res6: J10.38, J17.1, U2.7
/res7: J10.40, J18.1, U2.8
/res8: J10.42, J19.1, U2.9
/res9: J2.1, J10.2, U1.2
/res10: J3.1, J10.4, U1.3
/res11: J4.1, J10.6, U1.4
/res12: J5.1, J10.8, U1.5
/res13: J6.1, J10.11, U1.6
/res14: J7.1, J10.13, U1.7
/res15: J8.1, J10.15, U1.8
/res16: J9.1, J10.17, U1.9
GND: C1.1, C2.2, C3.2, C4.2, J1.2, J2.2, J3.2, J4.2, J5.2, J6.2, J7.2, J8.2, J9.2, J10.1, J10.3, J10.5, J10.7, J10.9, J10.10, J10.12, J10.14, J10.16, J10.18, J10.19, J10.25, J10.26, J10.28, J10.30, J10.32, J10.34, J10.35, J10.37, J10.39, J10.41, J10.43, J10.44, J10.50, J12.2, J13.2, J14.2, J15.2, J16.2, J17.2, J18.2, J19.2, J20.4, J20.23, J21.1, J21.2, J21.17, J22.1, J22.10

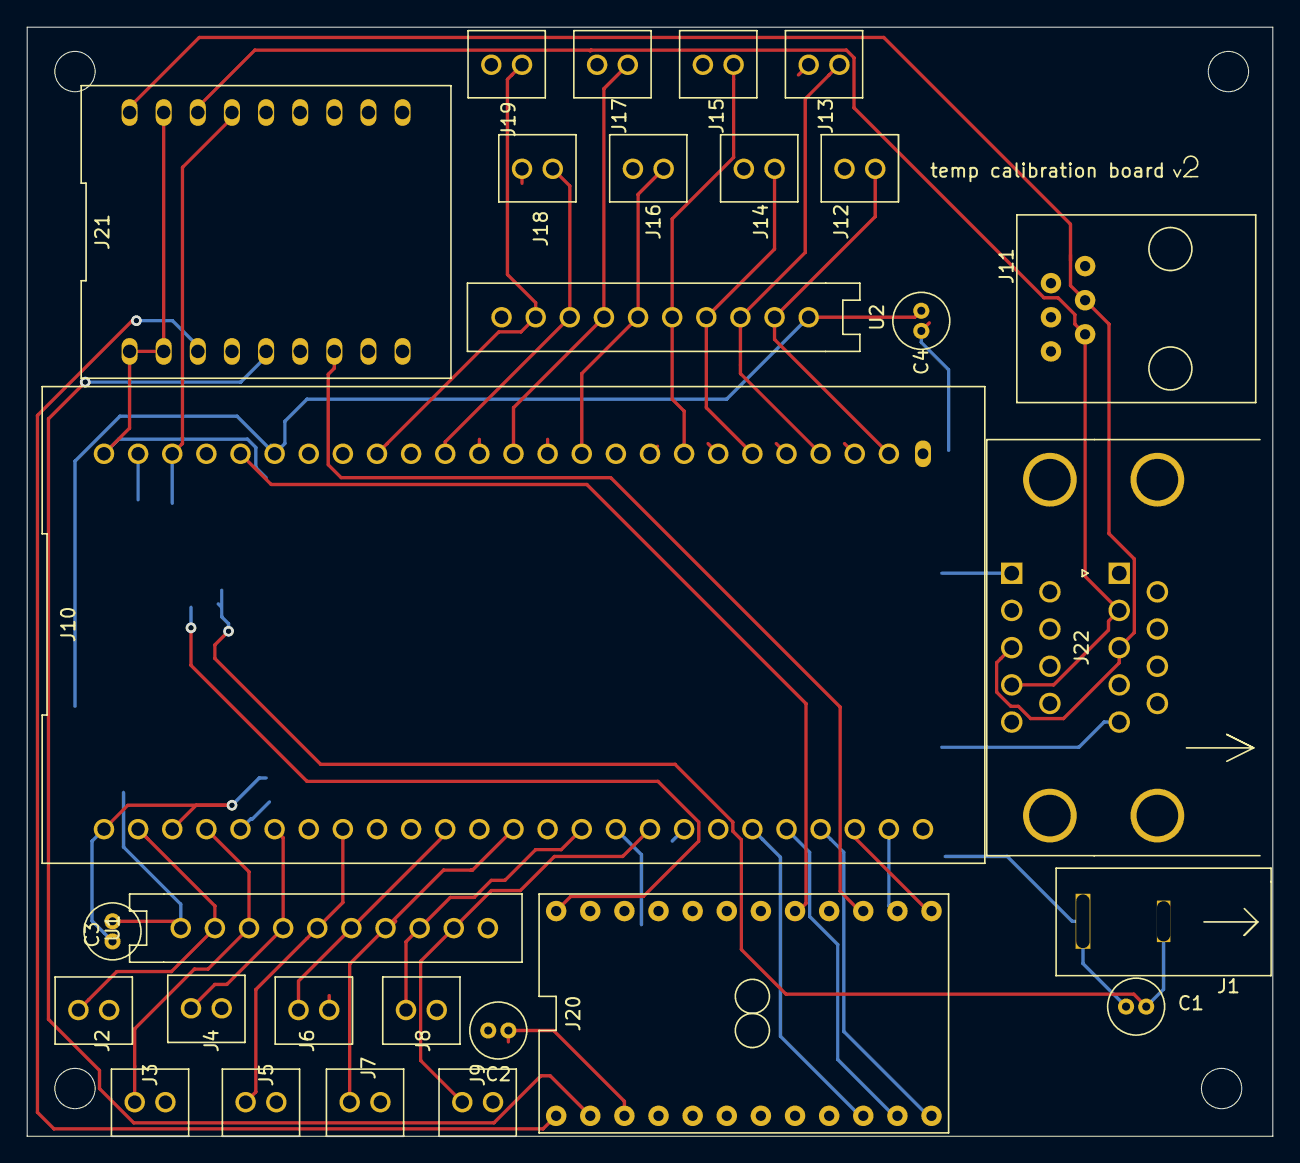
[picture p54: board temperature board.kicad_pcb from above]

Board: 2 copper layers, 92.7 x 82.5 mm, 32 parts (0 on the bottom side), 31 nets.

Other parts of the board:
  : MountingHole_3mm
  #2,   #3,   #4: MountingHole_3mm
