wayoffthecoast/reference-PDB-files/hardware-master/Smart Sleeve/vial_board/Rev D/Vial_Board.kicad_pcb

## KiCad design hardware-master/Smart Sleeve/vial_board/Rev D/Vial_Board.kicad_pcb (2021-12-21)

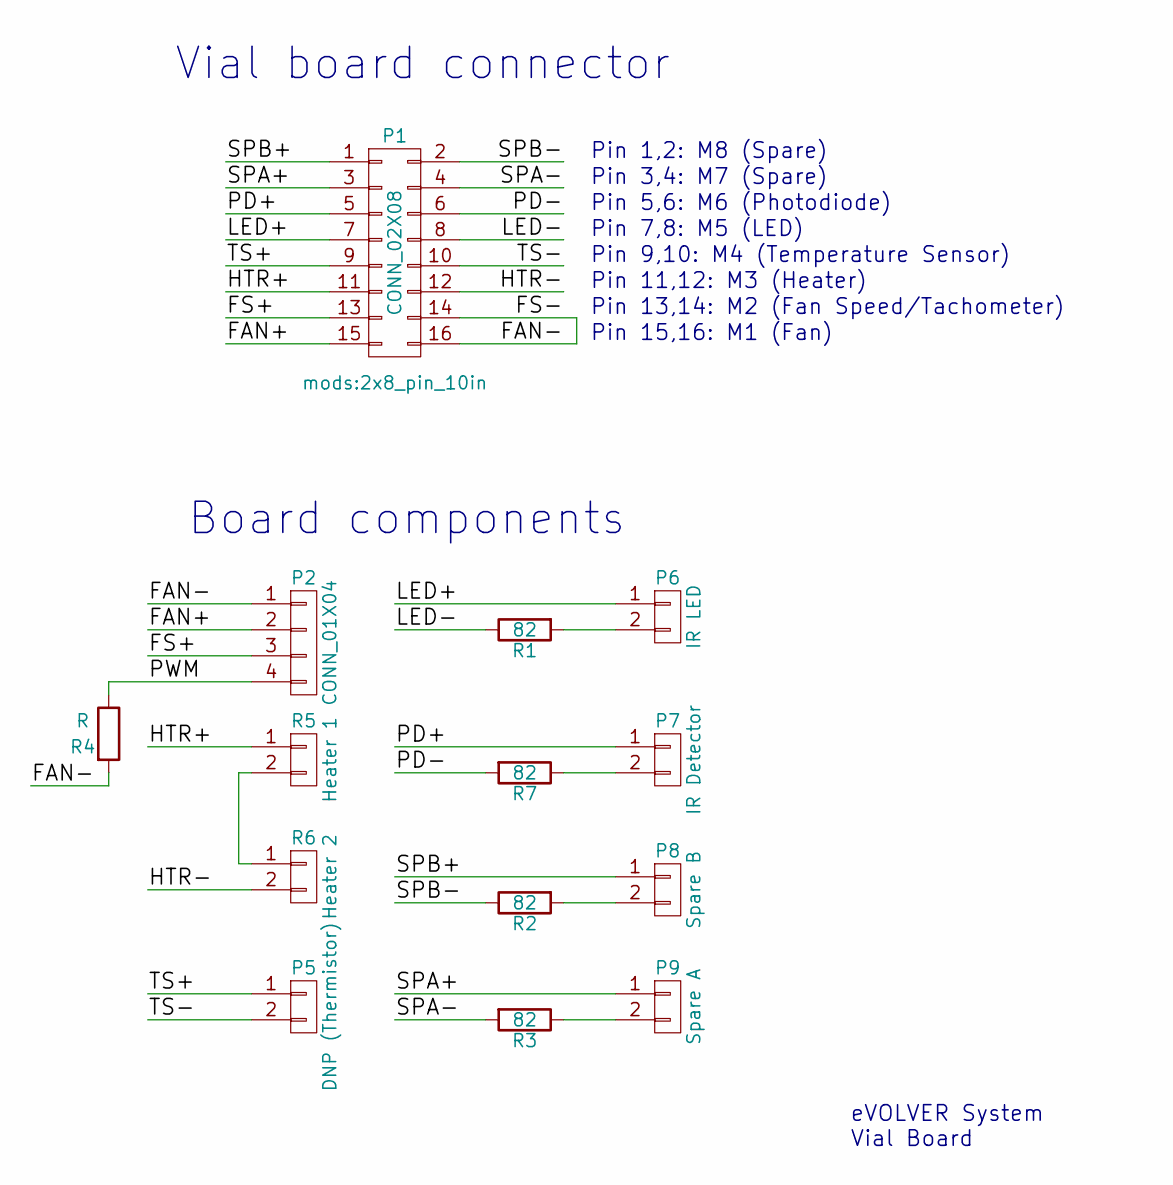
[picture p55: schematic Vial_Board.sch]

Parts:
P1: CONN_02X08; 2x8_pin_10in
P2: CONN_01X04; 4_ScrewTerm
P5: DNP (Thermistor); Thermistor
P6: IR LED; screw_terminal
P7: IR Detector; screw_terminal
P8: Spare B; screw_terminal
P9: Spare A; screw_terminal
R1, R2, R3, R7: 82; R_0805_HandSoldering
R4: R; R_0805_HandSoldering
R5: Heater 1; Heater
R6: Heater 2; Heater

Connections:
/FAN+: P1.15, P2.2
/FAN-: P1.14, P1.16, P2.1, R4.2
/FS+: P1.13, P2.3
/HTR+: P1.11, R5.1
/HTR-: P1.12, R6.2
/LED+: P1.7, P6.1
/LED-: P1.8, R1.1
/PD+: P1.5, P7.1
/PD-: P1.6, R7.2
/PWM: P2.4, R4.1
/SPA+: P1.3, P9.1
/SPA-: P1.4, R3.2
/SPB+: P1.1, P8.1
/SPB-: P1.2, R2.1
/TS+: P1.9, P5.1
/TS-: P1.10, P5.2
unnamed: P6.2, R1.2
unnamed: P7.2, R7.1
unnamed: P8.2, R2.2
unnamed: P9.2, R3.1
unnamed: R5.2, R6.1

Notes on the sheet:
Vial board connector
Board components
Pin 1,2: M8 (Spare)
Pin 3,4: M7 (Spare)
Pin 5,6: M6 (Photodiode)
Pin 7,8: M5 (LED)
Pin 9,10: M4 (Temperature Sensor)
Pin 11,12: M3 (Heater)
Pin 15,16: M1 (Fan)
eVOLVER System Vial Board
Pin 13,14: M2 (Fan Speed/Tachometer)

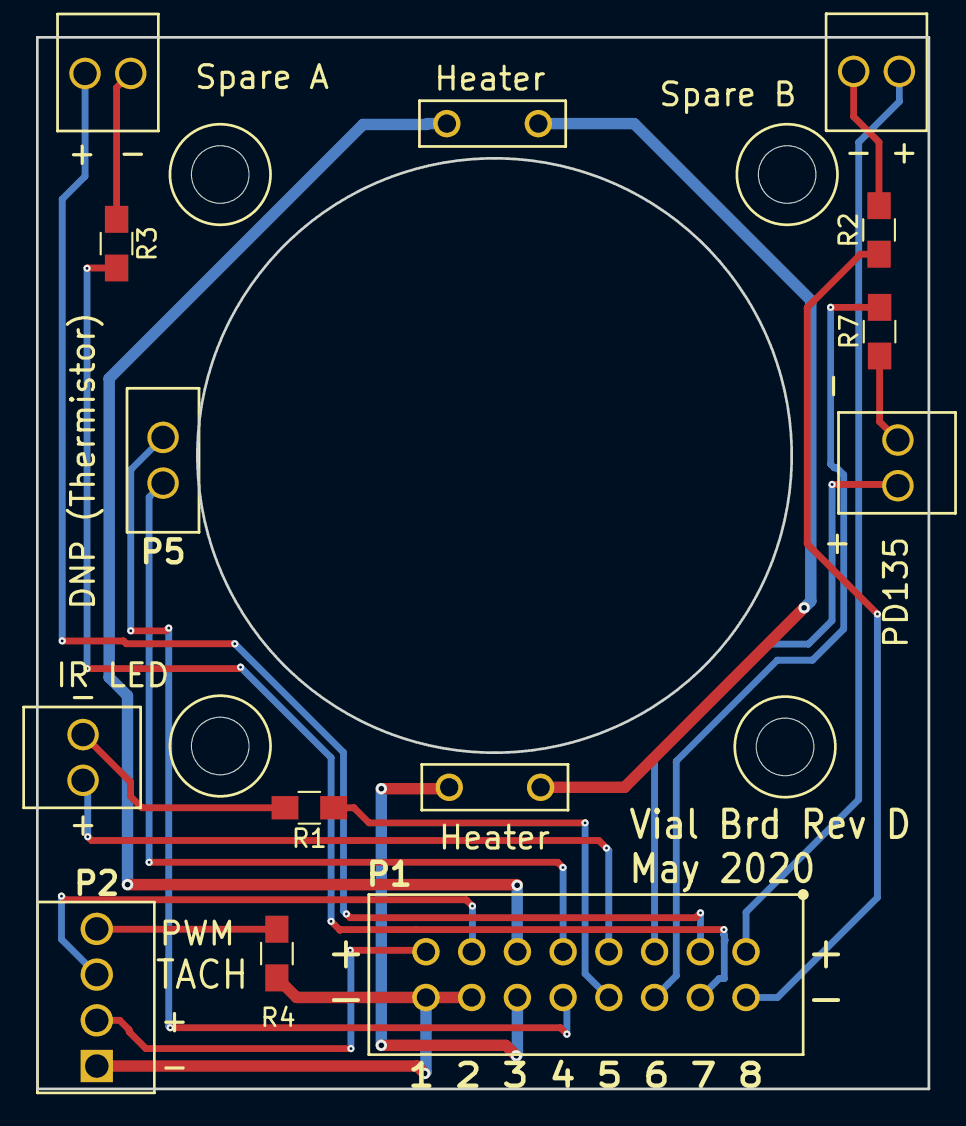
[picture p56: board hardware-master/Smart Sleeve/vial_board/Rev D/Vial_Board.kicad_pcb from above]

Board: 2 copper layers, 49.5 x 58.4 mm, 14 parts (0 on the bottom side), 21 nets.
