wayoffthecoast/reference-PDB-files/flow-rate-aux-board/v2v_flow/flow_rate/flow_rate.kicad_pcb

## KiCad design flow-rate-aux-board/v2v_flow/flow_rate/flow_rate.kicad_pcb (2021-12-21)

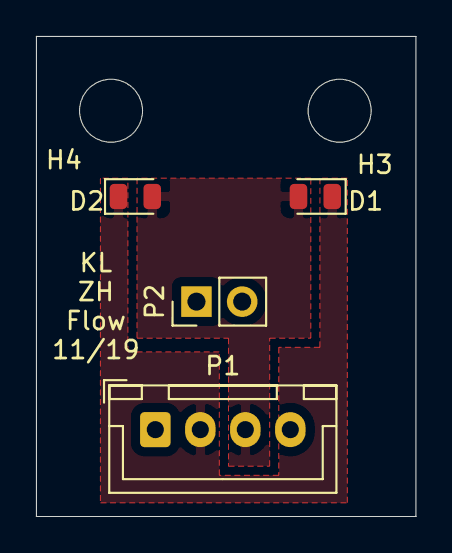
[picture p57: board flow-rate-aux-board/v2v_flow/flow_rate/flow_rate.kicad_pcb from above]

Board: 2 copper layers, 21.1 x 26.7 mm, 6 parts (0 on the bottom side), 4 nets, no tracks yet.

Parts:
D1, D2: D; D_0805_2012Metric
H3, H4: MountingHole; MountingHole_3.5mm
P1: CONN_01X04; JST_XH_B4B-XH-A_1x04_P2.50mm_Vertical
P2: CONN_01X02; PinHeader_1x02_P2.54mm_Vertical

Connections:
/LED_GND: P1.4, P2.2
/LED_PWR: P1.1, P2.1
/OUT: D1.2, D2.2, P1.3
/V_SENSE: D1.1, D2.1, P1.2
