wayoffthecoast/reference-PDB-files/hardware-master/resistor-pack/resistor_pack.kicad_pcb

## KiCad design hardware-master/resistor-pack/resistor_pack.kicad_pcb (2021-12-21)

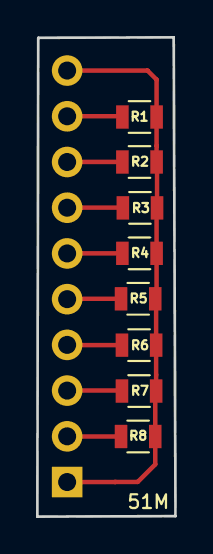
[picture p58: board resistor_pack.kicad_pcb from above]

Board: 2 copper layers, 7.7 x 26.6 mm, 9 parts (1 on the bottom side), 9 nets.

Parts:
J1: Conn_01x10; Socket_Strip_Straight_1x10_Pitch2.54mm
R1, R2, R3, R4, R5, R6, R7, R8: R; R_0805

Connections:
unnamed: J1.1, J1.10, R1.2, R2.2, R3.2, R4.2, R5.2, R6.2, R7.2, R8.2
unnamed: J1.2, R8.1
unnamed: J1.3, R7.1
unnamed: J1.4, R6.1
unnamed: J1.5, R5.1
unnamed: J1.6, R4.1
unnamed: J1.7, R3.1
unnamed: J1.8, R2.1
unnamed: J1.9, R1.1
